phuongnamzz/jetson-agx-thor-baseboard/jetson-agx-thor-baseboard_full3D/3D_Model/D_SOD-323.step

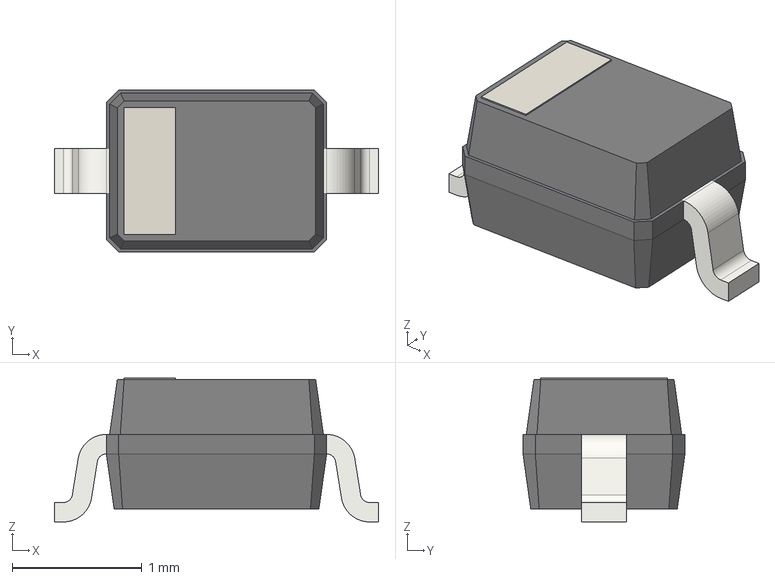
[picture p1: CAD file, 2026-10-12]
jetson-agx-thor-baseboard_full3D/3D_Model/D_SOD-323.step
2.50 x 1.25 x 1.11 mm
