phuongnamzz/jetson-agx-thor-baseboard/jetson-agx-thor-baseboard_full3D/3D_Model/Oscillator_SMD_Epson_SG3225EEN_3.2x2.5x1.2mm.stp

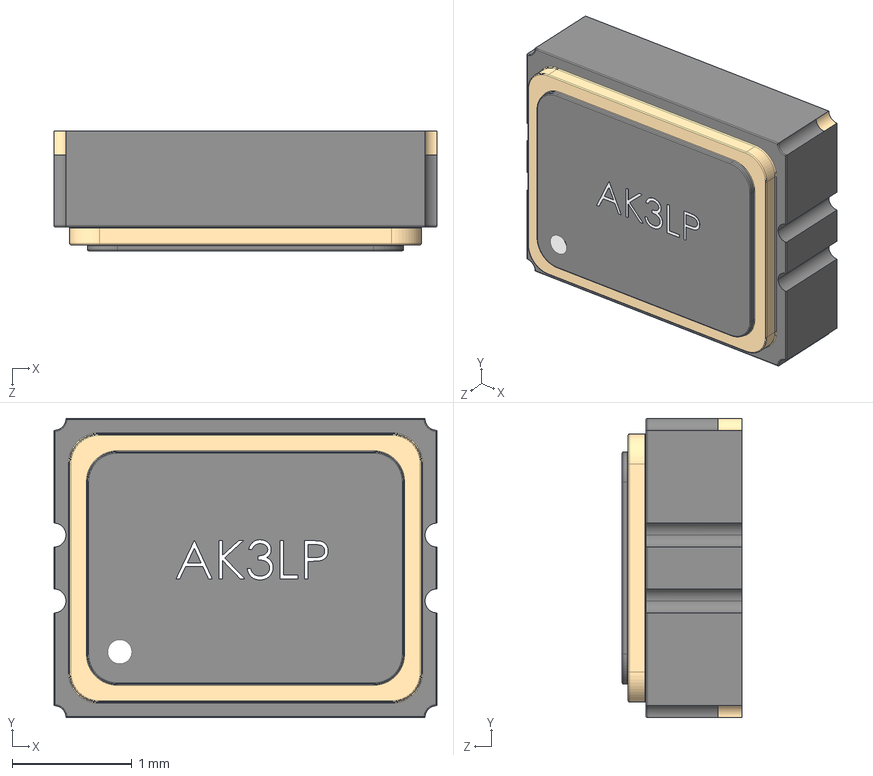
[picture p2: CAD file, 2026-10-12]
jetson-agx-thor-baseboard_full3D/3D_Model/Oscillator_SMD_Epson_SG3225EEN_3.2x2.5x1.2mm.stp
3.20 x 2.50 x 1.00 mm
