phuongnamzz/jetson-agx-thor-baseboard/jetson-agx-thor-baseboard_full3D/3D_Model/SOIC-8_L5.0-W4.0-P1.27-LS6.0-BL.step

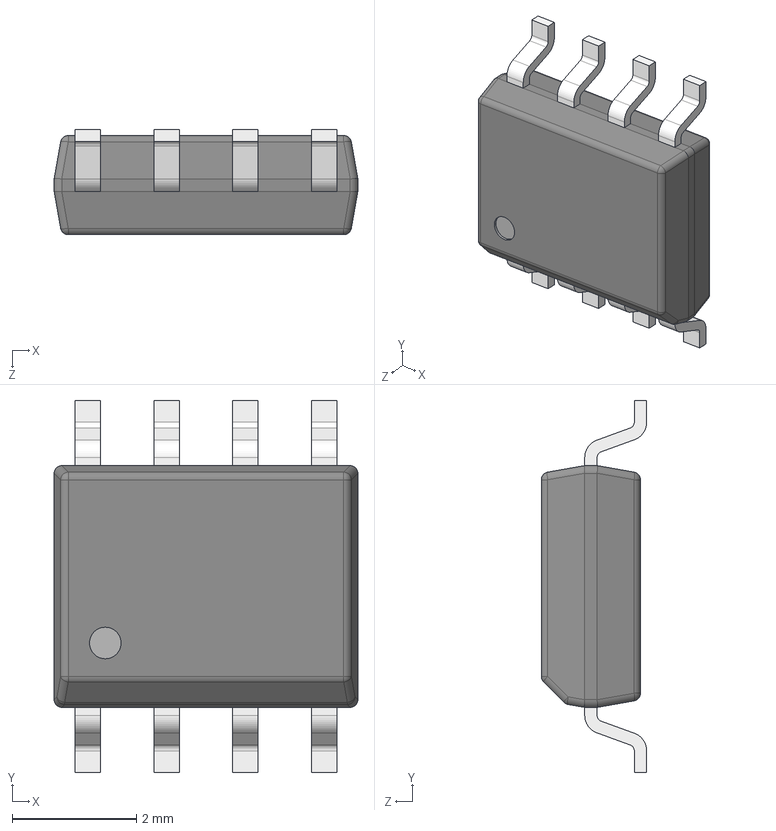
[picture p3: CAD file, 2026-10-12]
jetson-agx-thor-baseboard_full3D/3D_Model/SOIC-8_L5.0-W4.0-P1.27-LS6.0-BL.step
4.90 x 6.00 x 1.70 mm
