phuongnamzz/jetson-agx-thor-baseboard/jetson-agx-thor-baseboard_full3D/3D_Model/Oscillator_SMD_ECS_2520MV-2.5x2mm.stp

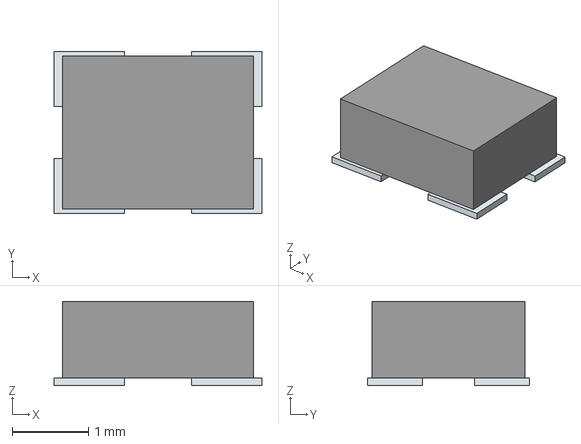
[picture p4: CAD file, 2026-10-12]
jetson-agx-thor-baseboard_full3D/3D_Model/Oscillator_SMD_ECS_2520MV-2.5x2mm.stp
2.72 x 2.12 x 1.10 mm
Pins
