phuongnamzz/jetson-agx-thor-baseboard/jetson-agx-thor-baseboard_full3D/3D_Model/CONN-SMD_MX1.25-LS-4P.step

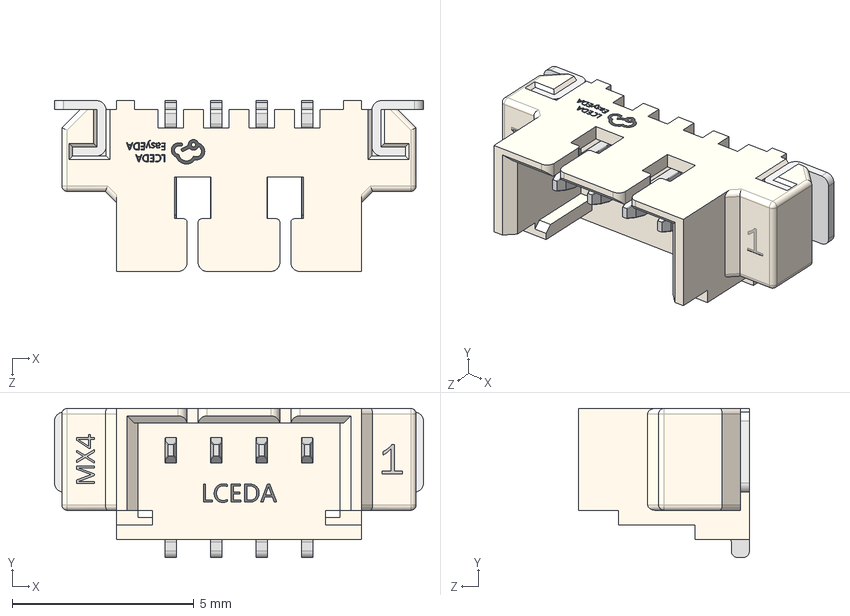
[picture p5: CAD file, 2026-10-12]
jetson-agx-thor-baseboard_full3D/3D_Model/CONN-SMD_MX1.25-LS-4P.step
10.2 x 4.10 x 4.70 mm
