phuongnamzz/jetson-agx-thor-baseboard/jetson-agx-thor-baseboard_full3D/3D_Model/XAL5030-332MEB.stp

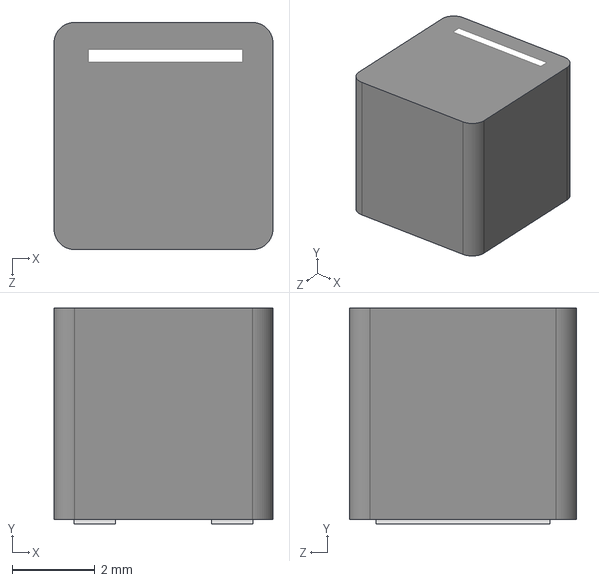
[picture p6: CAD file, 2026-10-12]
jetson-agx-thor-baseboard_full3D/3D_Model/XAL5030-332MEB.stp
5.28 x 5.20 x 5.48 mm
