phuongnamzz/jetson-agx-thor-baseboard/jetson-agx-thor-baseboard_full3D/3D_Model/SRP6050CA-1R0M.stp

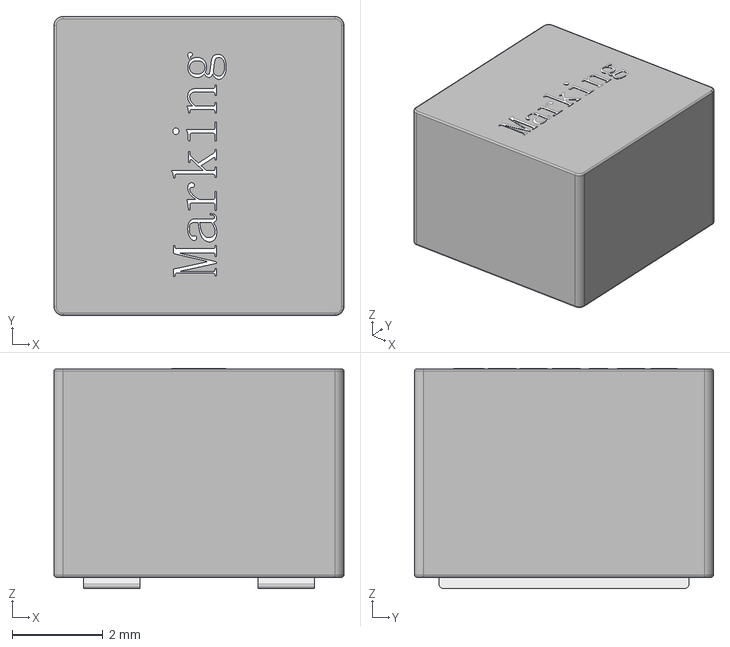
[picture p8: CAD file, 2026-10-12]
jetson-agx-thor-baseboard_full3D/3D_Model/SRP6050CA-1R0M.stp
6.40 x 6.60 x 4.86 mm
