phuongnamzz/jetson-agx-thor-baseboard/jetson-agx-thor-baseboard_full3D/3D_Model/Bus_M.2_Socket_Key_M_TE_1-2199230-6.step

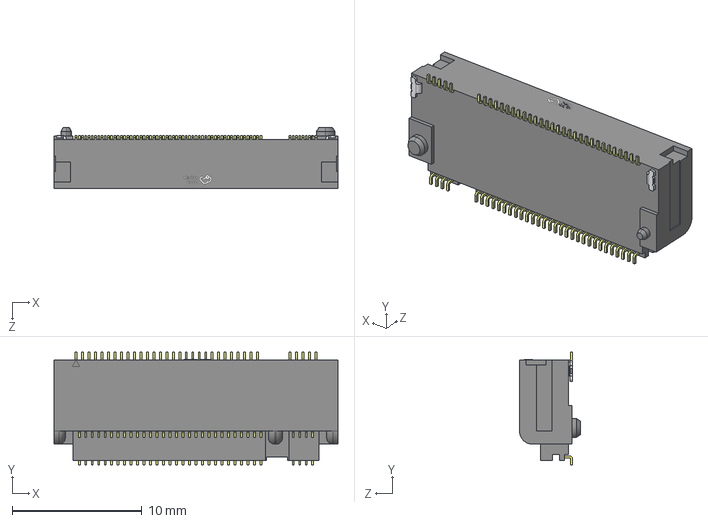
[picture p9: CAD file, 2026-10-12]
jetson-agx-thor-baseboard_full3D/3D_Model/Bus_M.2_Socket_Key_M_TE_1-2199230-6.step
21.9 x 8.70 x 4.70 mm
