phuongnamzz/jetson-agx-thor-baseboard/jetson-agx-thor-baseboard_full3D/3D_Model/SOT-23-8.step

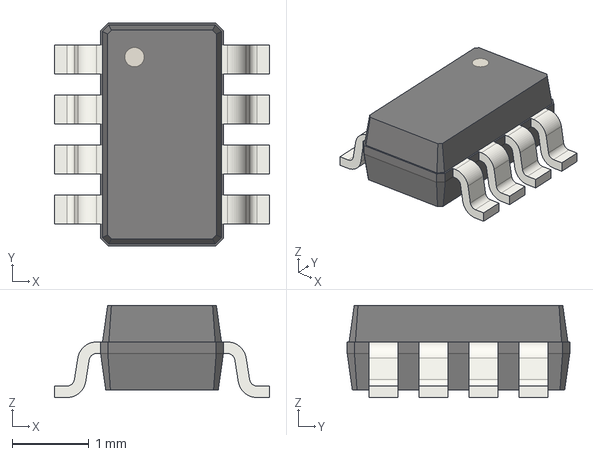
[picture p10: CAD file, 2026-10-12]
jetson-agx-thor-baseboard_full3D/3D_Model/SOT-23-8.step
2.80 x 2.90 x 1.20 mm
