phuongnamzz/jetson-agx-thor-baseboard/jetson-agx-thor-baseboard_full3D/3D_Model/SOT-363_SC-70-6.step

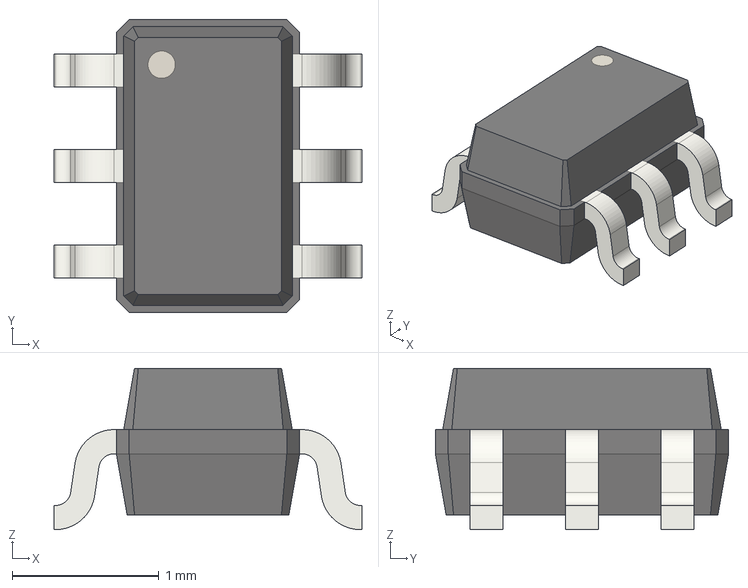
[picture p11: CAD file, 2026-10-12]
jetson-agx-thor-baseboard_full3D/3D_Model/SOT-363_SC-70-6.step
2.10 x 2.00 x 1.10 mm
