phuongnamzz/jetson-agx-thor-baseboard/jetson-agx-thor-baseboard_full3D/3D_Model/XAL7070-332MEB.stp

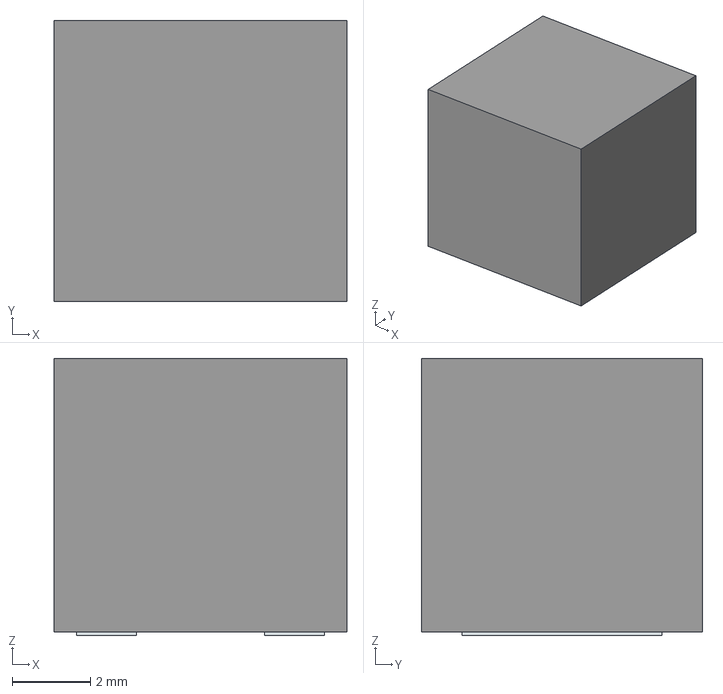
[picture p12: CAD file, 2026-10-12]
jetson-agx-thor-baseboard_full3D/3D_Model/XAL7070-332MEB.stp
7.50 x 7.20 x 7.10 mm
Pins
