phuongnamzz/jetson-agx-thor-baseboard/jetson-agx-thor-baseboard_full3D/3D_Model/R_0603_1608Metric.step

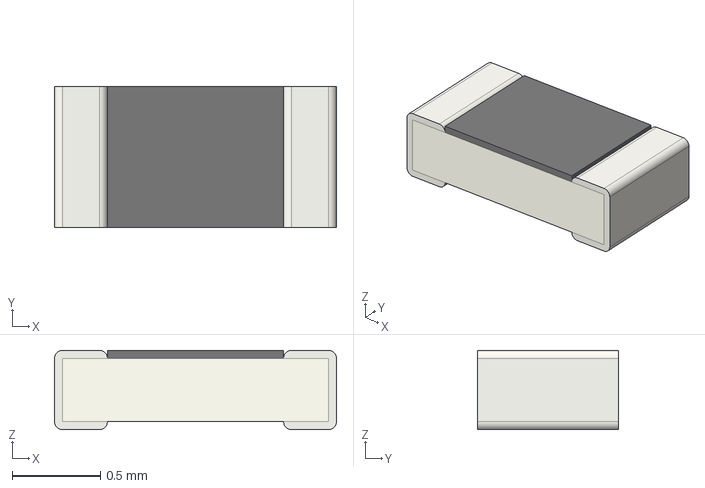
[picture p13: CAD file, 2026-10-12]
jetson-agx-thor-baseboard_full3D/3D_Model/R_0603_1608Metric.step
1.60 x 0.8 x 0.45 mm
