phuongnamzz/jetson-agx-thor-baseboard/jetson-agx-thor-baseboard_full3D/3D_Model/SOT-23-5_L2.9-W1.6-P0.95-LS2.8-BR.step

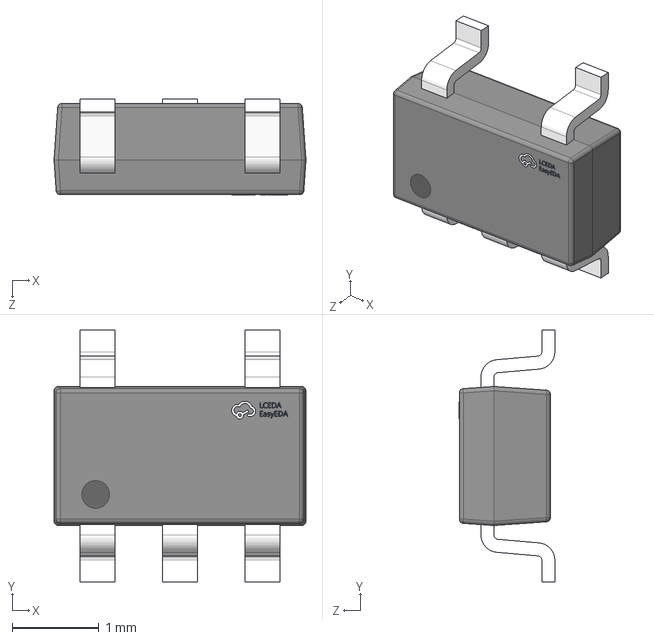
[picture p14: CAD file, 2026-10-12]
jetson-agx-thor-baseboard_full3D/3D_Model/SOT-23-5_L2.9-W1.6-P0.95-LS2.8-BR.step
2.90 x 2.90 x 1.10 mm
