phuongnamzz/jetson-agx-thor-baseboard/jetson-agx-thor-baseboard_full3D/3D_Model/SRP5030CA-R56M.stp

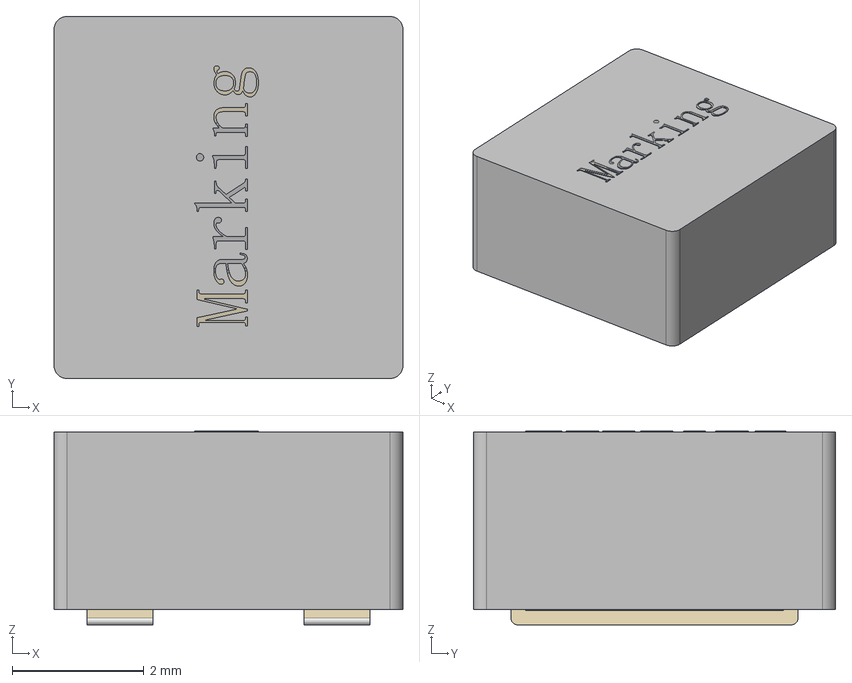
[picture p15: CAD file, 2026-10-12]
jetson-agx-thor-baseboard_full3D/3D_Model/SRP5030CA-R56M.stp
5.30 x 5.50 x 2.94 mm
