phuongnamzz/jetson-agx-thor-baseboard/jetson-agx-thor-baseboard_full3D/3D_Model/SOD-523_L1.2-W0.8-H0.7-LS1.6.step

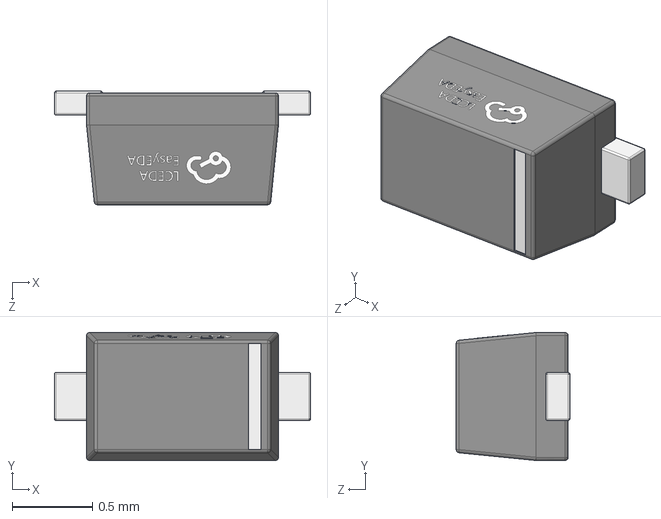
[picture p16: CAD file, 2026-10-12]
jetson-agx-thor-baseboard_full3D/3D_Model/SOD-523_L1.2-W0.8-H0.7-LS1.6.step
1.60 x 0.8 x 0.71 mm
