phuongnamzz/jetson-agx-thor-baseboard/jetson-agx-thor-baseboard_full3D/3D_Model/DFN1610-2_L1.6-W1.0-P1.05-RD.step

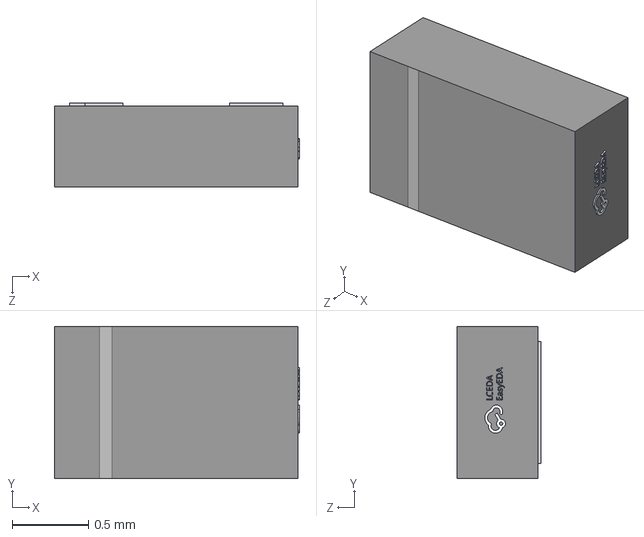
[picture p18: CAD file, 2026-10-12]
jetson-agx-thor-baseboard_full3D/3D_Model/DFN1610-2_L1.6-W1.0-P1.05-RD.step
1.61 x 1.00 x 0.55 mm
