phuongnamzz/jetson-agx-thor-baseboard/jetson-agx-thor-baseboard_full3D/3D_Model/USB-C_Receptacle_Kycon_KUSBX-SL2-CS1N24-B-TR.step

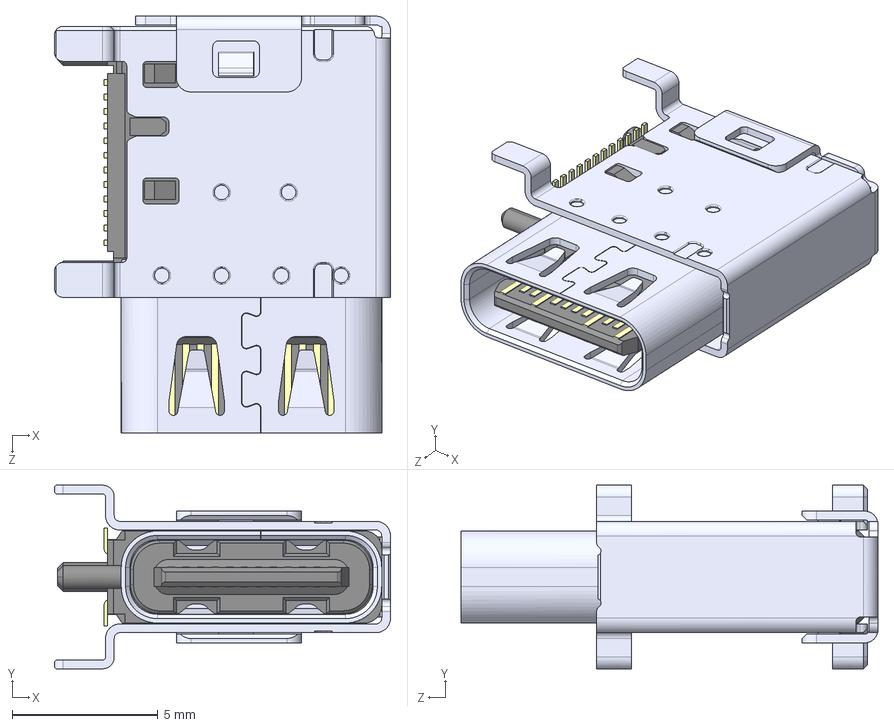
[picture p19: CAD file, 2026-10-12]
jetson-agx-thor-baseboard_full3D/3D_Model/USB-C_Receptacle_Kycon_KUSBX-SL2-CS1N24-B-TR.step
11.5 x 6.30 x 14.3 mm
