phuongnamzz/jetson-agx-thor-baseboard/jetson-agx-thor-baseboard_full3D/3D_Model/NTS0102GT.stp

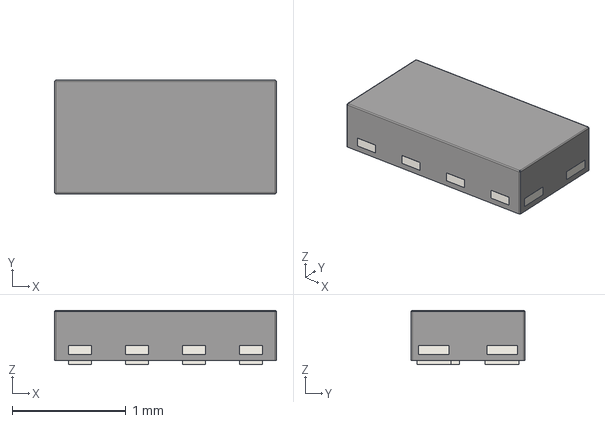
[picture p20: CAD file, 2026-10-12]
jetson-agx-thor-baseboard_full3D/3D_Model/NTS0102GT.stp
1.95 x 1.00 x 0.475 mm
