phuongnamzz/jetson-agx-thor-baseboard/jetson-agx-thor-baseboard_full3D/3D_Model/CONN-SMD_SR1.00-WS-4P.step

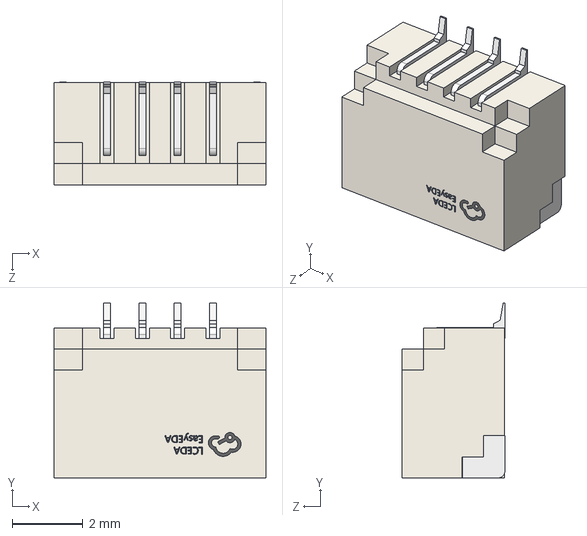
[picture p21: CAD file, 2026-10-12]
jetson-agx-thor-baseboard_full3D/3D_Model/CONN-SMD_SR1.00-WS-4P.step
6.00 x 4.95 x 2.91 mm
