phuongnamzz/jetson-agx-thor-baseboard/jetson-agx-thor-baseboard_full3D/3D_Model/WQFN-40_L6.0-W4.0-P0.40-TL-EP.step

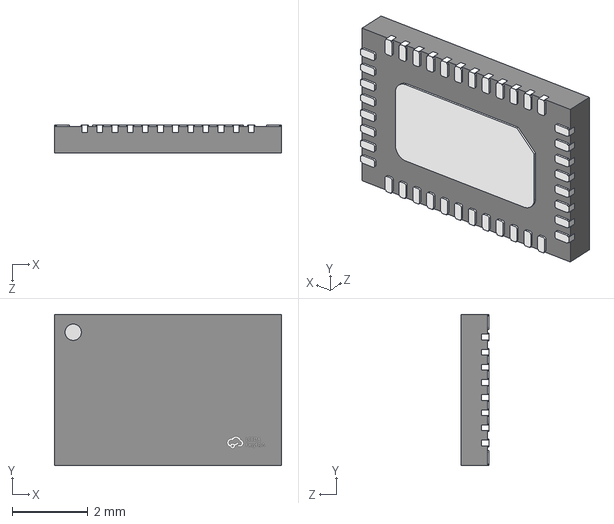
[picture p22: CAD file, 2026-10-12]
jetson-agx-thor-baseboard_full3D/3D_Model/WQFN-40_L6.0-W4.0-P0.40-TL-EP.step
6.00 x 4.00 x 0.751 mm
