phuongnamzz/jetson-agx-thor-baseboard/jetson-agx-thor-baseboard_full3D/3D_Model/WQFN-30_L4.5-W2.5-P0.4-BL-EP.step

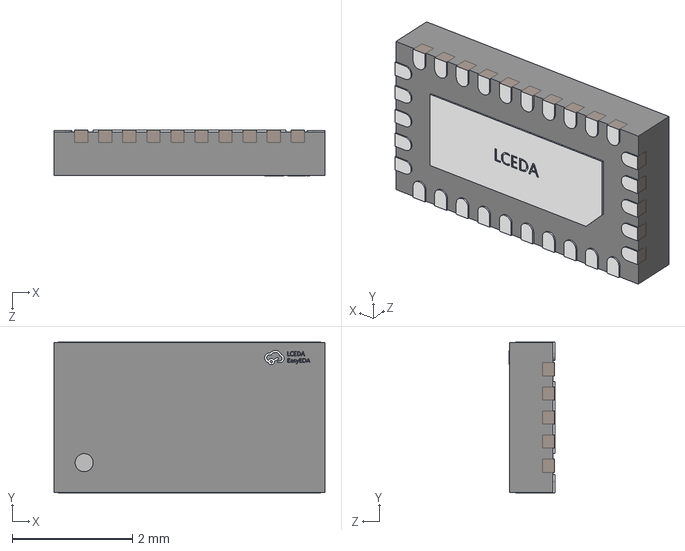
[picture p23: CAD file, 2026-10-12]
jetson-agx-thor-baseboard_full3D/3D_Model/WQFN-30_L4.5-W2.5-P0.4-BL-EP.step
4.50 x 2.50 x 0.756 mm
