phuongnamzz/jetson-agx-thor-baseboard/jetson-agx-thor-baseboard_full3D/3D_Model/Vishay_PowerPAK_1212-8_Single.stp

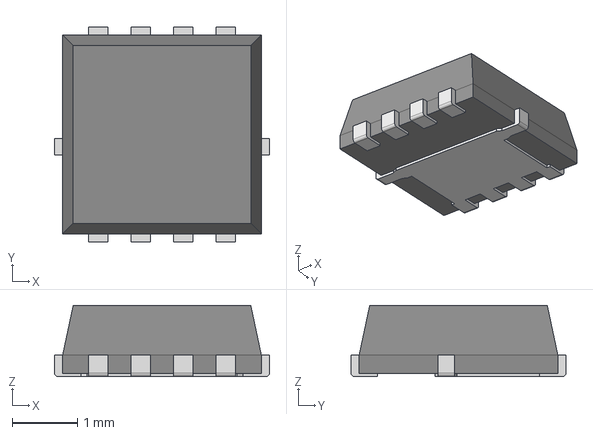
[picture p24: CAD file, 2026-10-12]
jetson-agx-thor-baseboard_full3D/3D_Model/Vishay_PowerPAK_1212-8_Single.stp
3.30 x 3.30 x 1.09 mm
