phuongnamzz/jetson-agx-thor-baseboard/jetson-agx-thor-baseboard_full3D/3D_Model/R_1206_3216Metric.step

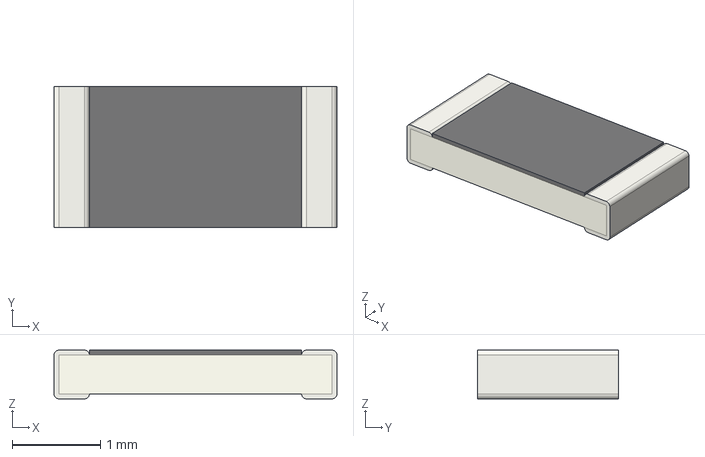
[picture p25: CAD file, 2026-10-12]
jetson-agx-thor-baseboard_full3D/3D_Model/R_1206_3216Metric.step
3.20 x 1.60 x 0.55 mm
