phuongnamzz/jetson-agx-thor-baseboard/jetson-agx-thor-baseboard_full3D/3D_Model/SOT-523.step

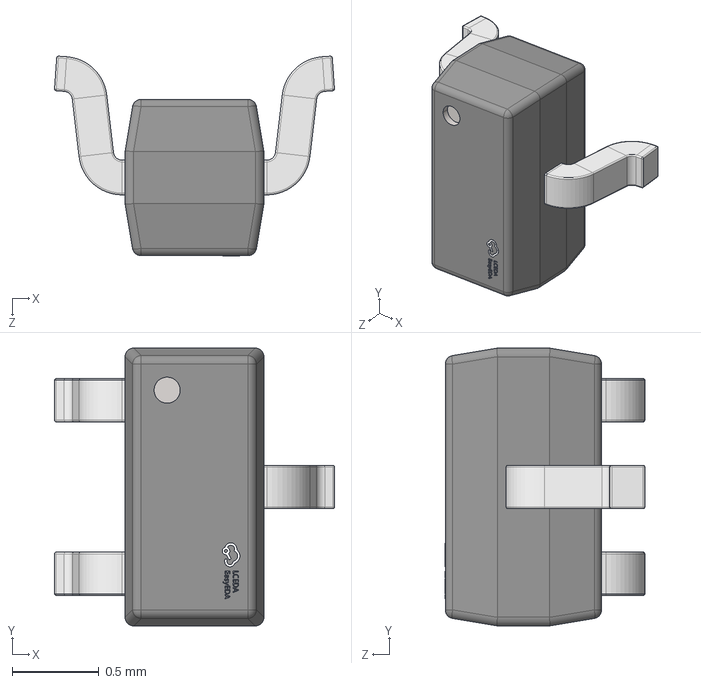
[picture p26: CAD file, 2026-10-12]
jetson-agx-thor-baseboard_full3D/3D_Model/SOT-523.step
1.61 x 1.60 x 1.15 mm
