phuongnamzz/jetson-agx-thor-baseboard/jetson-agx-thor-baseboard_full3D/3D_Model/USON-8_L3.0-W2.0-P0.50-BL-EP_GD25QXX.step

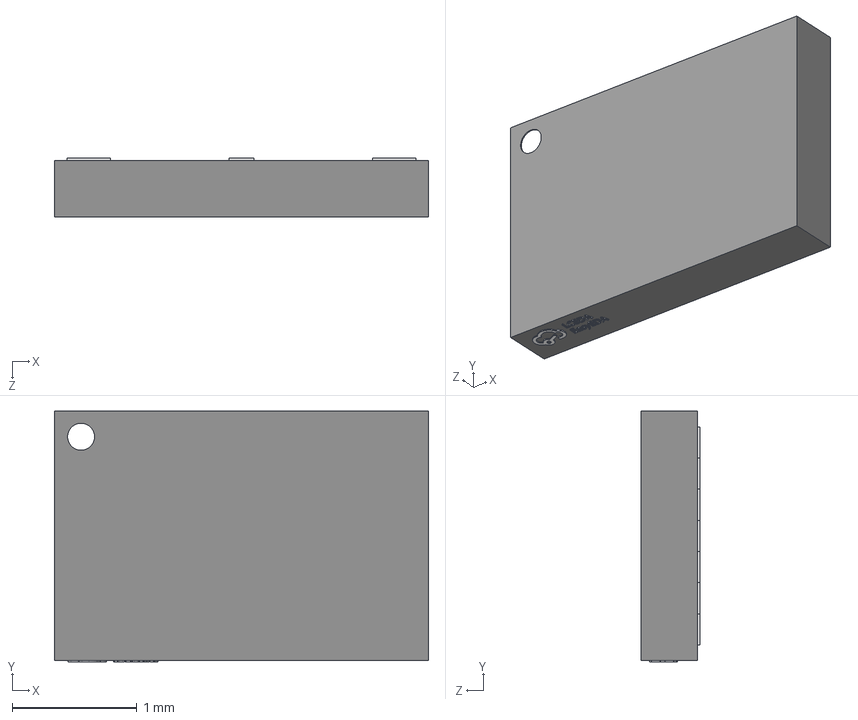
[picture p27: CAD file, 2026-10-12]
jetson-agx-thor-baseboard_full3D/3D_Model/USON-8_L3.0-W2.0-P0.50-BL-EP_GD25QXX.step
3.00 x 2.01 x 0.47 mm
