phuongnamzz/jetson-agx-thor-baseboard/jetson-agx-thor-baseboard_full3D/3D_Model/MPL-AL5050-xxx.STEP

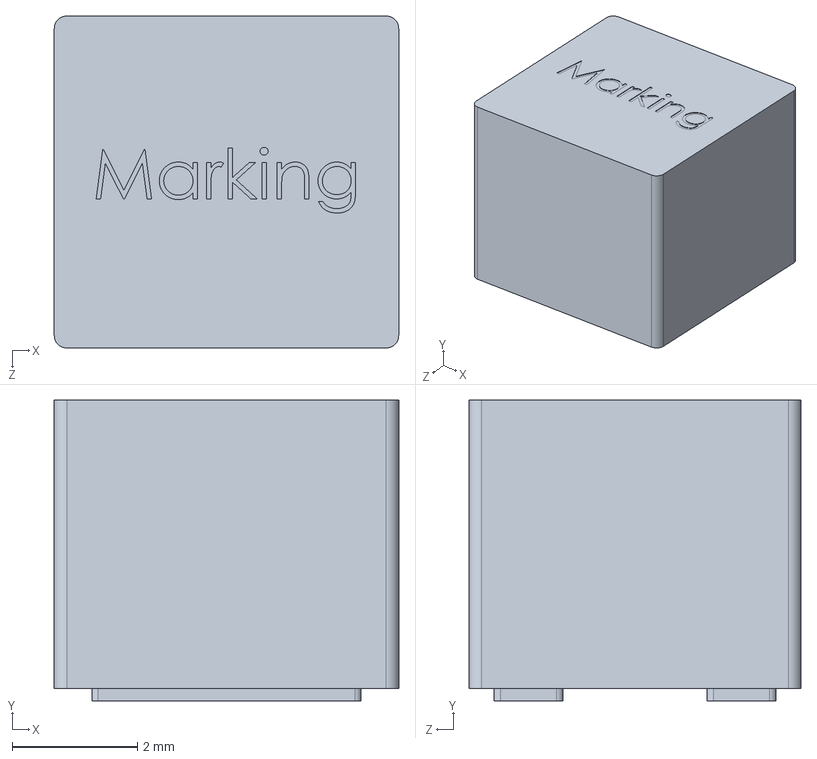
[picture p28: CAD file, 2026-10-12]
jetson-agx-thor-baseboard_full3D/3D_Model/MPL-AL5050-xxx.STEP
5.50 x 4.80 x 5.30 mm
