phuongnamzz/jetson-agx-thor-baseboard/jetson-agx-thor-baseboard_full3D/3D_Model/RSH0056E.stp

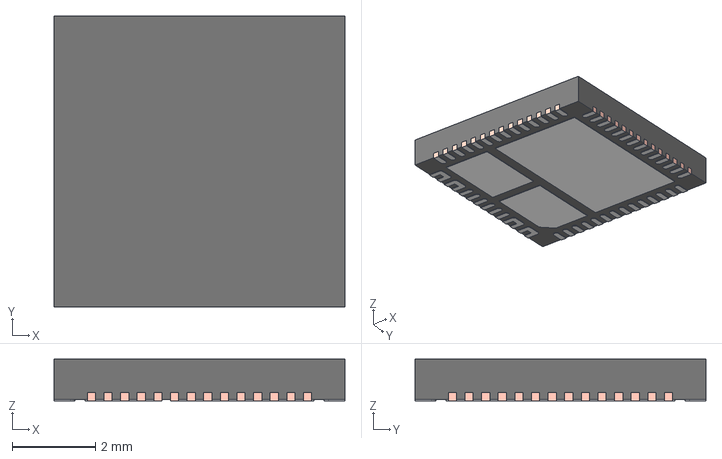
[picture p29: CAD file, 2026-10-12]
jetson-agx-thor-baseboard_full3D/3D_Model/RSH0056E.stp
7.00 x 7.00 x 1.00 mm
BODY-QFN
FRAME-RSH0056E
