phuongnamzz/jetson-agx-thor-baseboard/jetson-agx-thor-baseboard_full3D/3D_Model/SiC431AED-T1-GE3.stp

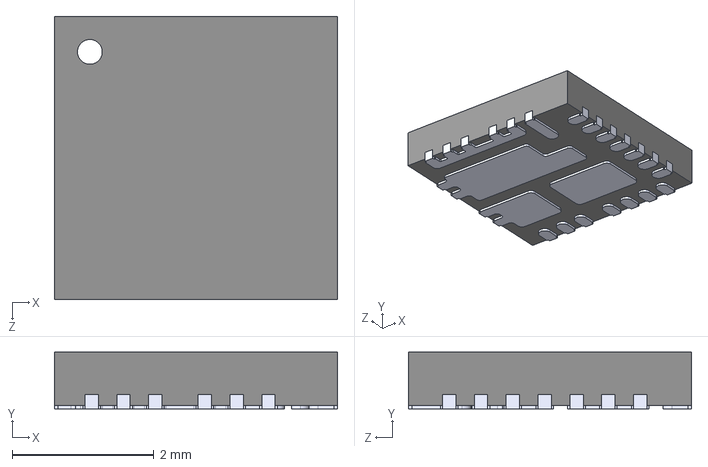
[picture p30: CAD file, 2026-10-12]
jetson-agx-thor-baseboard_full3D/3D_Model/SiC431AED-T1-GE3.stp
4.00 x 0.8 x 4.00 mm
