phuongnamzz/jetson-agx-thor-baseboard/jetson-agx-thor-baseboard_full3D/3D_Model/PCM12SMTR.step

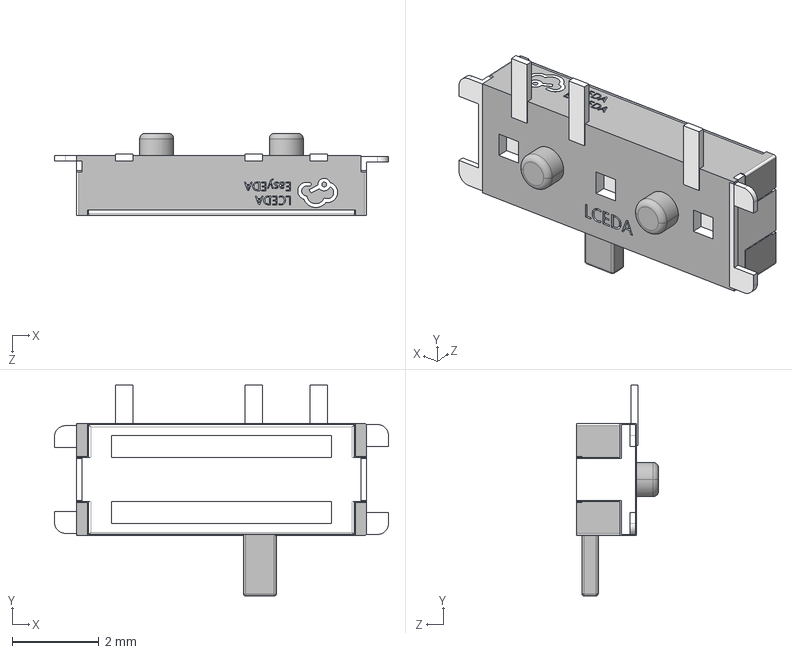
[picture p31: CAD file, 2026-10-12]
jetson-agx-thor-baseboard_full3D/3D_Model/PCM12SMTR.step
7.72 x 4.88 x 1.91 mm
