phuongnamzz/jetson-agx-thor-baseboard/jetson-agx-thor-baseboard_full3D/3D_Model/TQFN-32_L5.0-W5.0-P0.50-TL-EP3.7.step

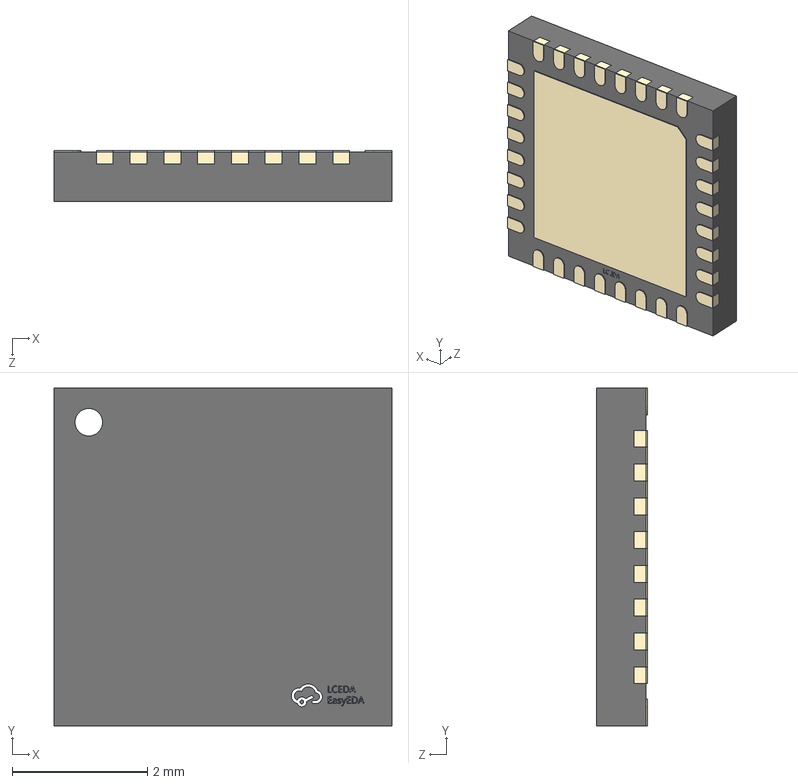
[picture p32: CAD file, 2026-10-12]
jetson-agx-thor-baseboard_full3D/3D_Model/TQFN-32_L5.0-W5.0-P0.50-TL-EP3.7.step
5.00 x 5.00 x 0.751 mm
