phuongnamzz/jetson-agx-thor-baseboard/jetson-agx-thor-baseboard_full3D/3D_Model/HVQFN-16_L3.0-W3.0-P0.50-BL-EP1.6.step

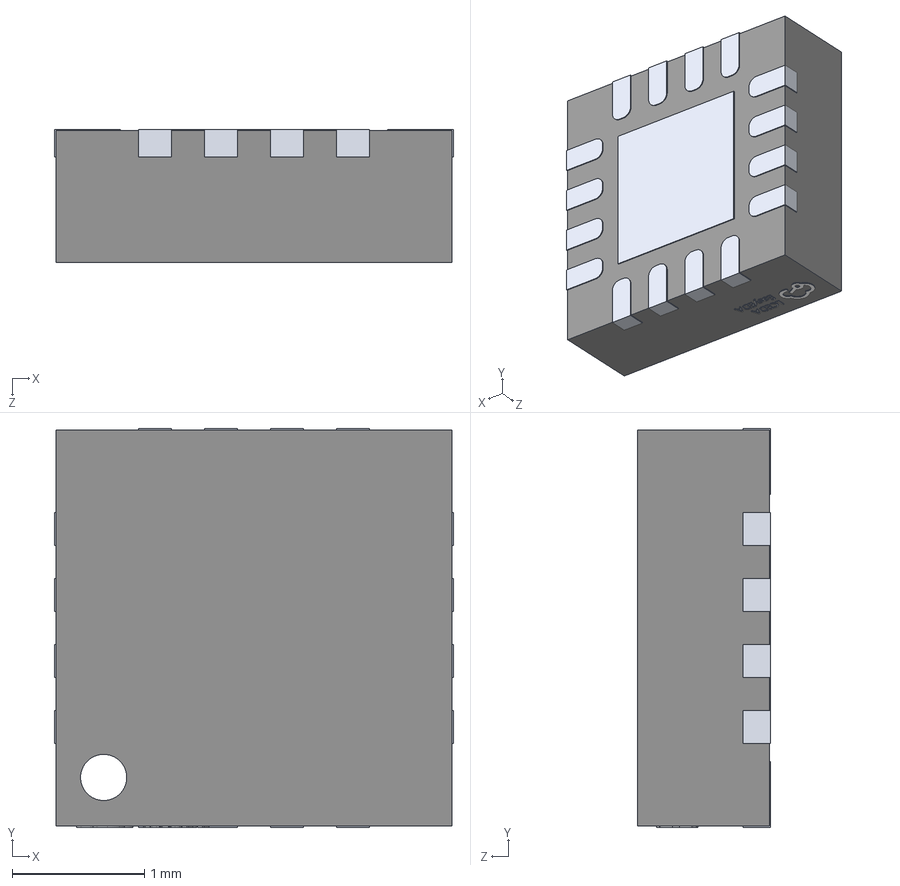
[picture p33: CAD file, 2026-10-12]
jetson-agx-thor-baseboard_full3D/3D_Model/HVQFN-16_L3.0-W3.0-P0.50-BL-EP1.6.step
3.02 x 3.02 x 1.01 mm
