phuongnamzz/jetson-agx-thor-baseboard/jetson-agx-thor-baseboard_full3D/3D_Model/R_0805_2012Metric.step

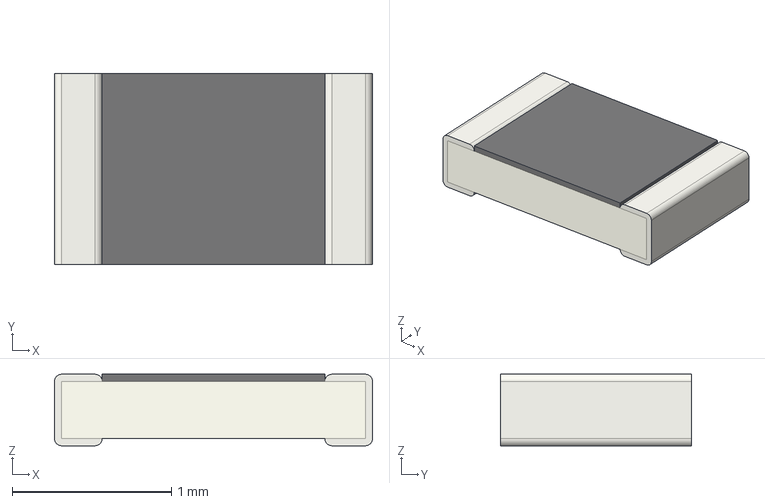
[picture p34: CAD file, 2026-10-12]
jetson-agx-thor-baseboard_full3D/3D_Model/R_0805_2012Metric.step
2.00 x 1.20 x 0.45 mm
