phuongnamzz/jetson-agx-thor-baseboard/jetson-agx-thor-baseboard_full3D/3D_Model/VQFN-24.step

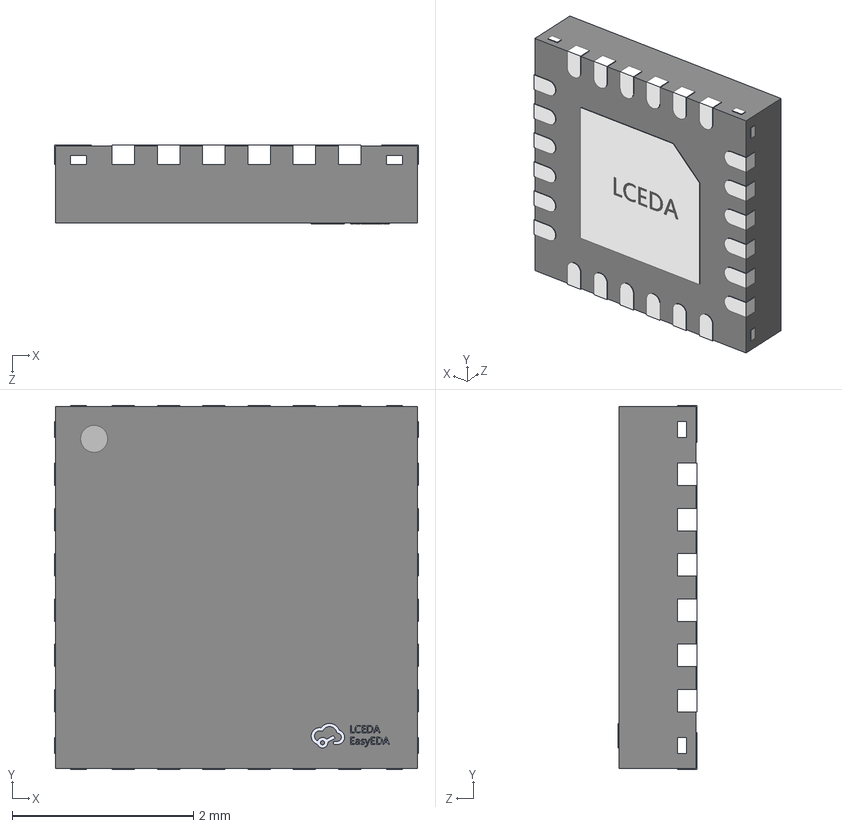
[picture p35: CAD file, 2026-10-12]
jetson-agx-thor-baseboard_full3D/3D_Model/VQFN-24.step
4.02 x 4.02 x 0.87 mm
