phuongnamzz/jetson-agx-thor-baseboard/jetson-agx-thor-baseboard_full3D/3D_Model/VQFN-100_L12.0-W12.0-P0.40-TL-EP8.0.step

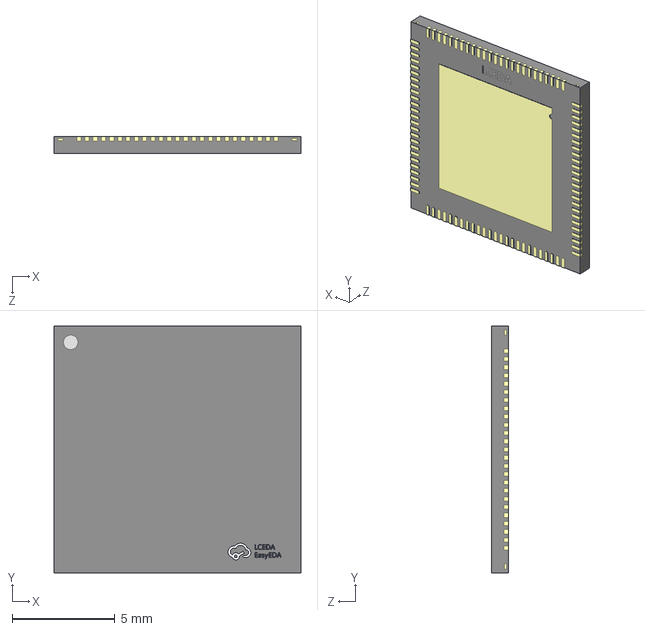
[picture p36: CAD file, 2026-10-12]
jetson-agx-thor-baseboard_full3D/3D_Model/VQFN-100_L12.0-W12.0-P0.40-TL-EP8.0.step
12.0 x 12.0 x 0.851 mm
