phuongnamzz/jetson-agx-thor-baseboard/jetson-agx-thor-baseboard_full3D/3D_Model/MS621FE-FL11E.stp

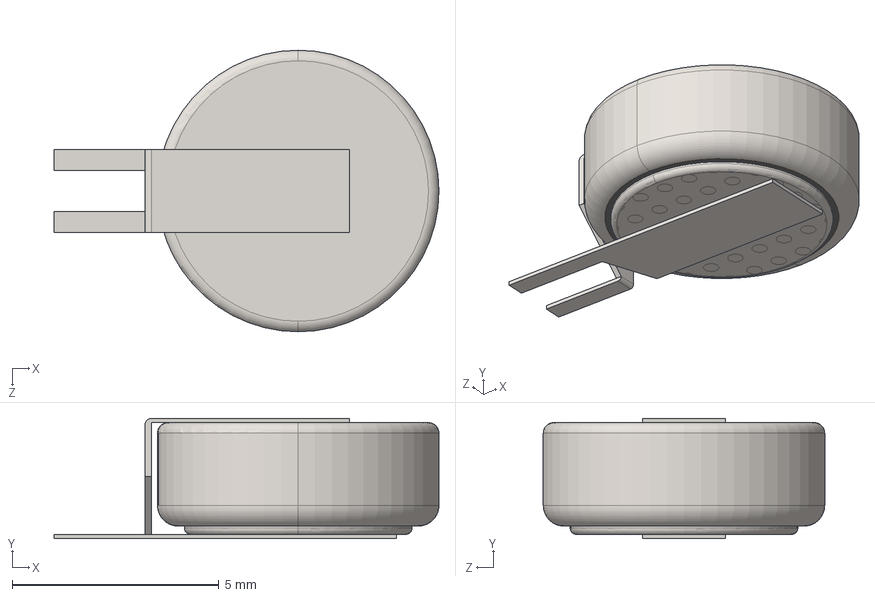
[picture p37: CAD file, 2026-10-12]
jetson-agx-thor-baseboard_full3D/3D_Model/MS621FE-FL11E.stp
9.30 x 2.90 x 6.80 mm
