phuongnamzz/jetson-agx-thor-baseboard/jetson-agx-thor-baseboard_full3D/3D_Model/MODULE_GENERIC_M.2-2280.step

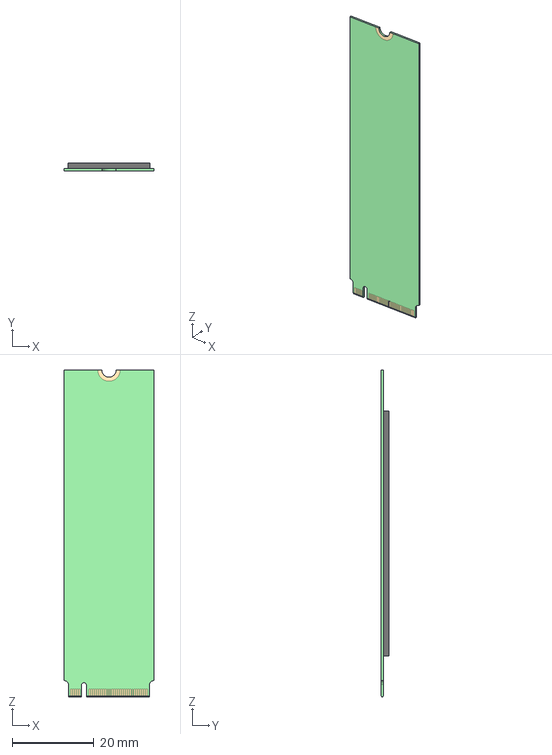
[picture p38: CAD file, 2026-10-12]
jetson-agx-thor-baseboard_full3D/3D_Model/MODULE_GENERIC_M.2-2280.step
22.0 x 1.86 x 80.0 mm
