phuongnamzz/jetson-agx-thor-baseboard/jetson-agx-thor-baseboard_full3D/3D_Model/Conn_Amphenol_SFP28_1x20_UE763GA202600T.step

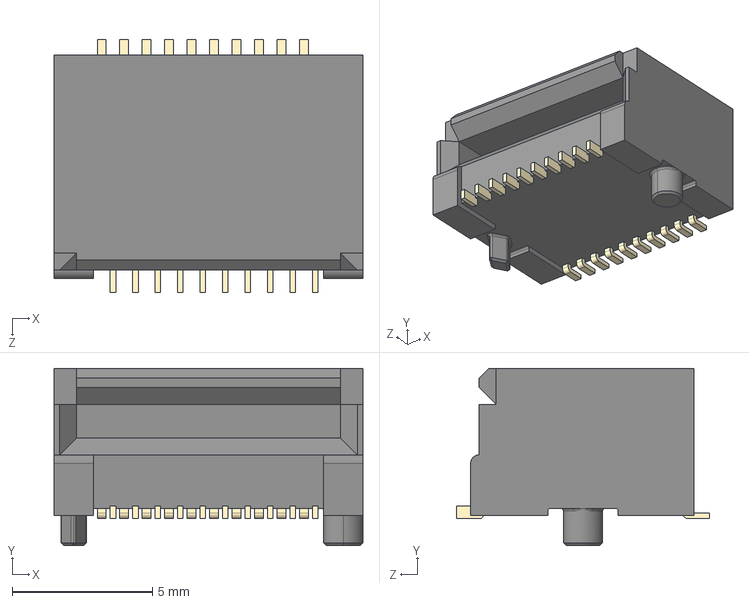
[picture p39: CAD file, 2026-10-12]
jetson-agx-thor-baseboard_full3D/3D_Model/Conn_Amphenol_SFP28_1x20_UE763GA202600T.step
11.0 x 6.31 x 9.00 mm
