phuongnamzz/jetson-agx-thor-baseboard/jetson-agx-thor-baseboard_full3D/3D_Model/D_SOD-123.step

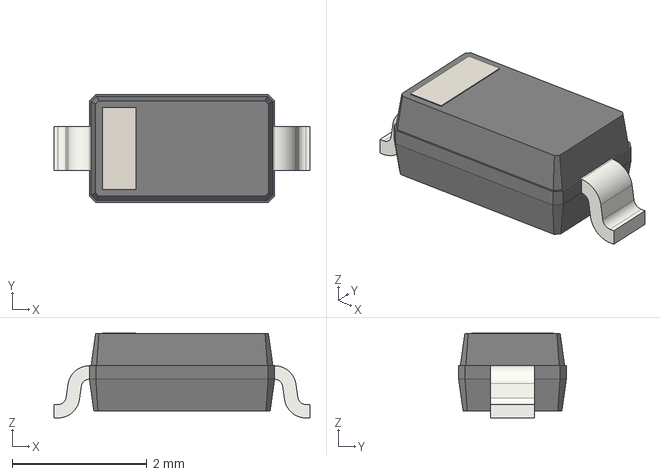
[picture p40: CAD file, 2026-10-12]
jetson-agx-thor-baseboard_full3D/3D_Model/D_SOD-123.step
3.80 x 1.60 x 1.26 mm
