phuongnamzz/jetson-agx-thor-baseboard/jetson-agx-thor-baseboard_full3D/3D_Model/UMPT-06-06.5-G-V-S-W-TR.stp

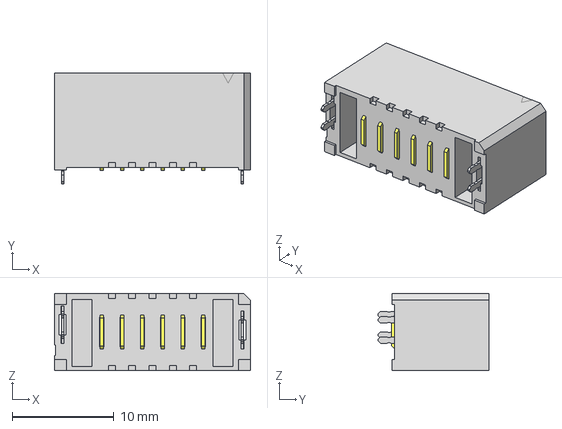
[picture p41: CAD file, 2026-10-12]
jetson-agx-thor-baseboard_full3D/3D_Model/UMPT-06-06.5-G-V-S-W-TR.stp
19.3 x 11.0 x 7.60 mm
06-06.5--W_BODY
UMPT-06-06.5-S-_PINS
