phuongnamzz/jetson-agx-thor-baseboard/jetson-agx-thor-baseboard_full3D/3D_Model/USON-10_L2.5-W1.0-H0.6-P0.50.step

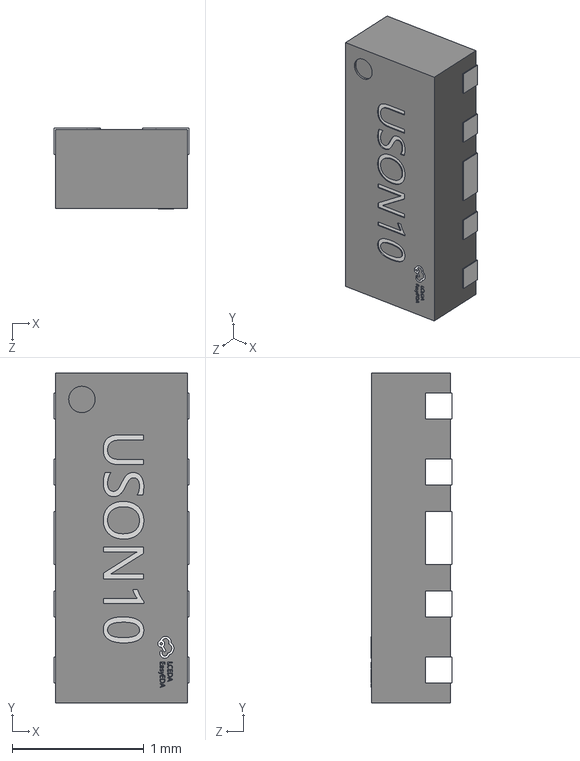
[picture p42: CAD file, 2026-10-12]
jetson-agx-thor-baseboard_full3D/3D_Model/USON-10_L2.5-W1.0-H0.6-P0.50.step
1.02 x 2.50 x 0.611 mm
