phuongnamzz/jetson-agx-thor-baseboard/jetson-agx-thor-baseboard_full3D/3D_Model/M-U77-3GC1638-X071-REVT1.STEP

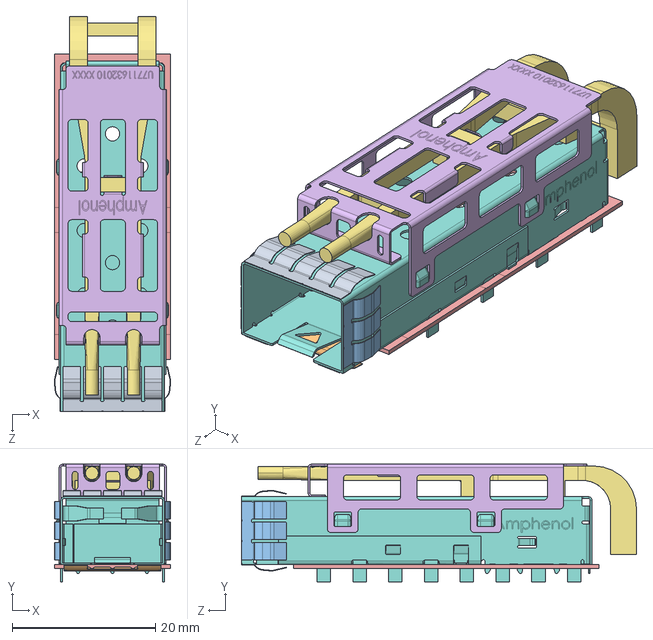
[picture p43: CAD file, 2026-10-12]
jetson-agx-thor-baseboard_full3D/3D_Model/M-U77-3GC1638-X071-REVT1.STEP
16.3 x 16.4 x 55.2 mm
