phuongnamzz/jetson-agx-thor-baseboard/jetson-agx-thor-baseboard_full3D/3D_Model/SOT-666.step

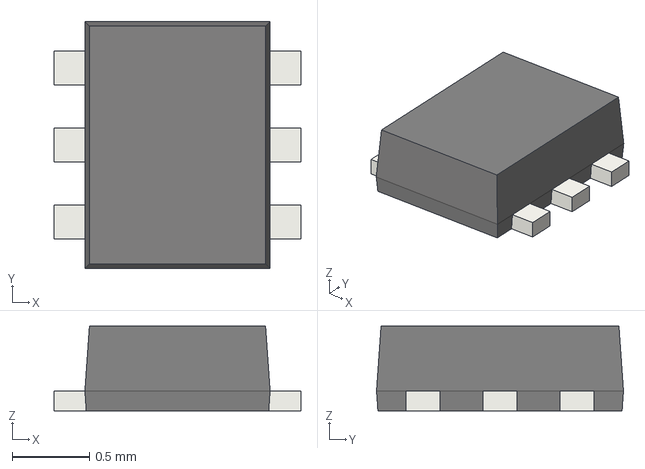
[picture p44: CAD file, 2026-10-12]
jetson-agx-thor-baseboard_full3D/3D_Model/SOT-666.step
1.60 x 1.60 x 0.55 mm
