phuongnamzz/jetson-agx-thor-baseboard/jetson-agx-thor-baseboard_full3D/3D_Model/SW-SMD_4P-L4.2-W2.8-P1.60-LS4.6-TR.step

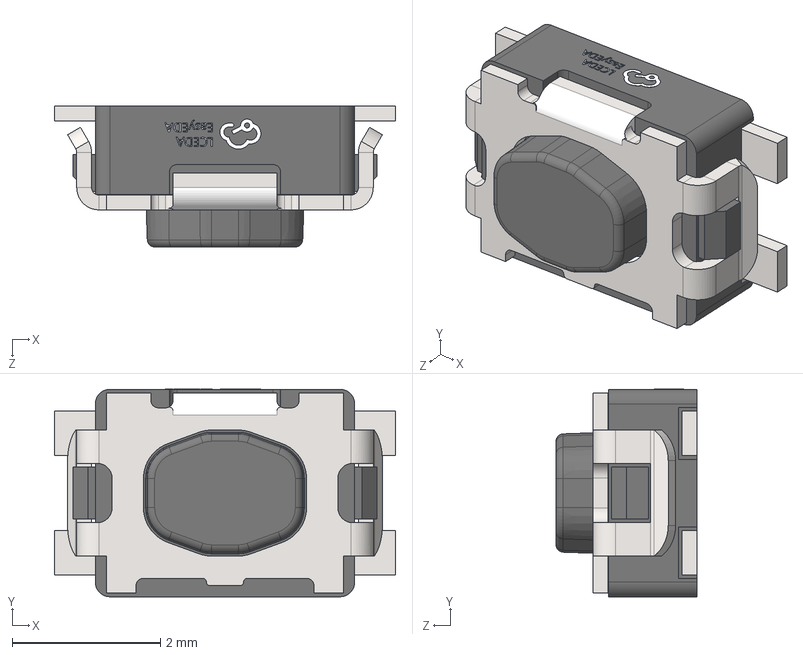
[picture p45: CAD file, 2026-10-12]
jetson-agx-thor-baseboard_full3D/3D_Model/SW-SMD_4P-L4.2-W2.8-P1.60-LS4.6-TR.step
4.60 x 2.80 x 1.90 mm
