phuongnamzz/jetson-agx-thor-baseboard/jetson-agx-thor-baseboard_full3D/3D_Model/C_0402_1005Metric.step

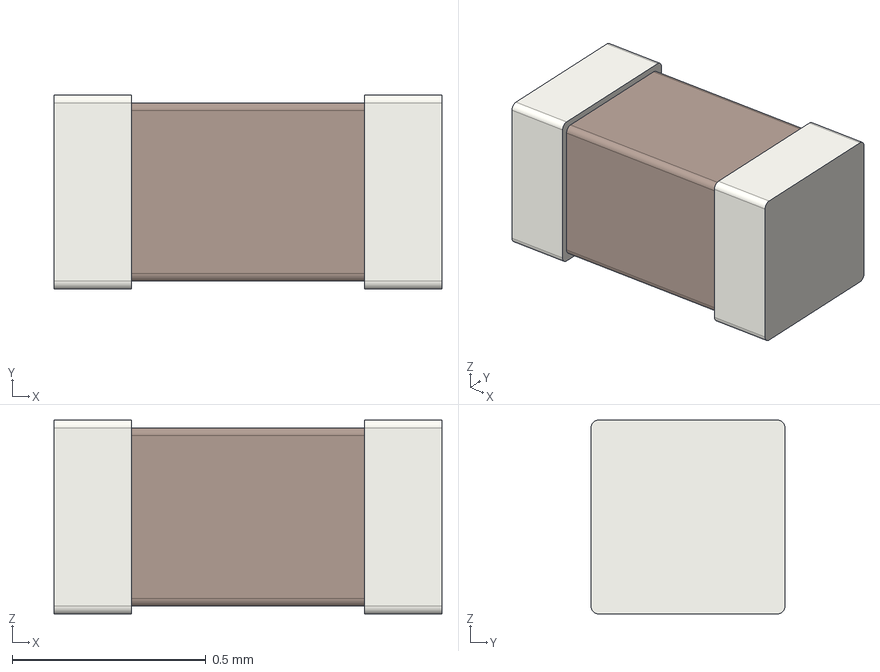
[picture p46: CAD file, 2026-10-12]
jetson-agx-thor-baseboard_full3D/3D_Model/C_0402_1005Metric.step
1.00 x 0.5 x 0.5 mm
