phuongnamzz/jetson-agx-thor-baseboard/jetson-agx-thor-baseboard_full3D/3D_Model/WE_68715014522.stp

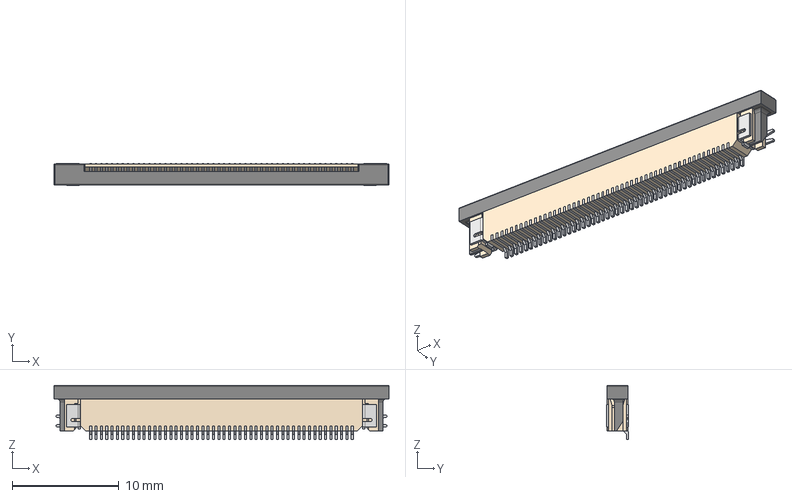
[picture p47: CAD file, 2026-10-12]
jetson-agx-thor-baseboard_full3D/3D_Model/WE_68715014522.stp
31.4 x 2.10 x 5.10 mm
6871xx14522_PIN x 50
6871xx14522_Patte
6871xx14522_Patte_2
68715014522_CAP
