phuongnamzz/jetson-agx-thor-baseboard/jetson-agx-thor-baseboard_full3D/3D_Model/SOIJ-8_L5.3-W5.3-P1.27-LS7.9-BL.step

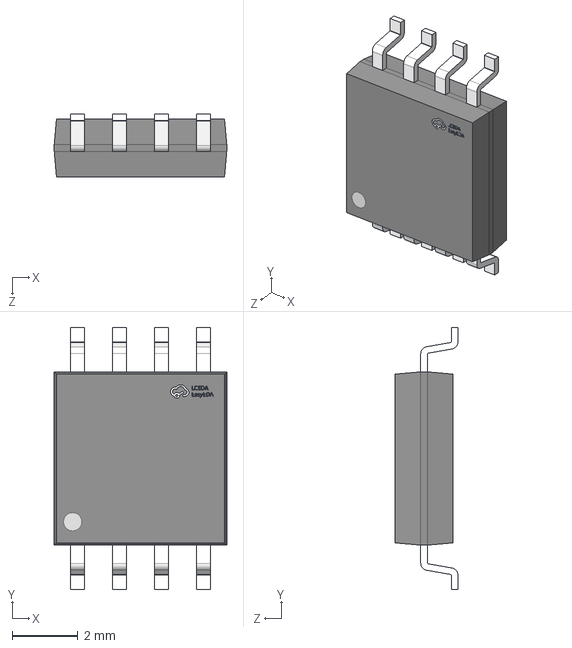
[picture p49: CAD file, 2026-10-12]
jetson-agx-thor-baseboard_full3D/3D_Model/SOIJ-8_L5.3-W5.3-P1.27-LS7.9-BL.step
5.23 x 7.94 x 1.90 mm
