phuongnamzz/jetson-agx-thor-baseboard/jetson-agx-thor-baseboard_full3D/3D_Model/UQFN-24_L4.0-W2.0-H0.6-P0.40-BL.step

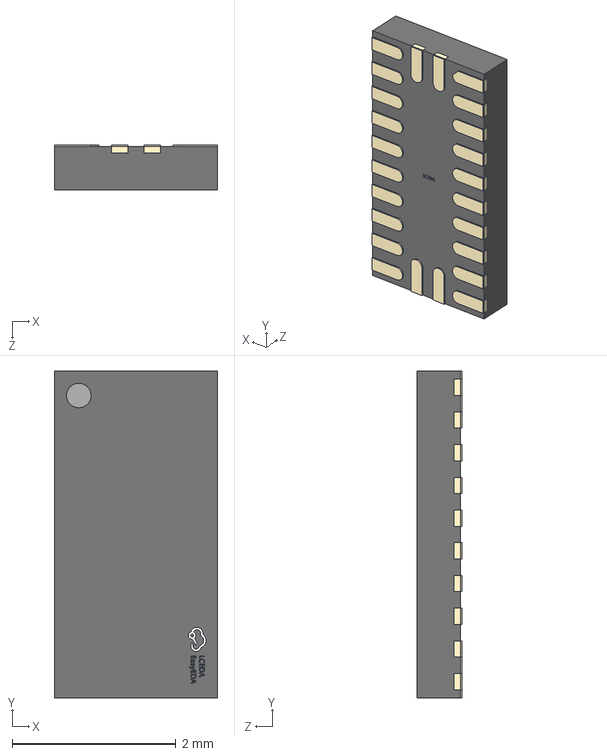
[picture p50: CAD file, 2026-10-12]
jetson-agx-thor-baseboard_full3D/3D_Model/UQFN-24_L4.0-W2.0-H0.6-P0.40-BL.step
2.00 x 4.00 x 0.551 mm
