phuongnamzz/jetson-agx-thor-baseboard/jetson-agx-thor-baseboard_full3D/3D_Model/sot23-6.step

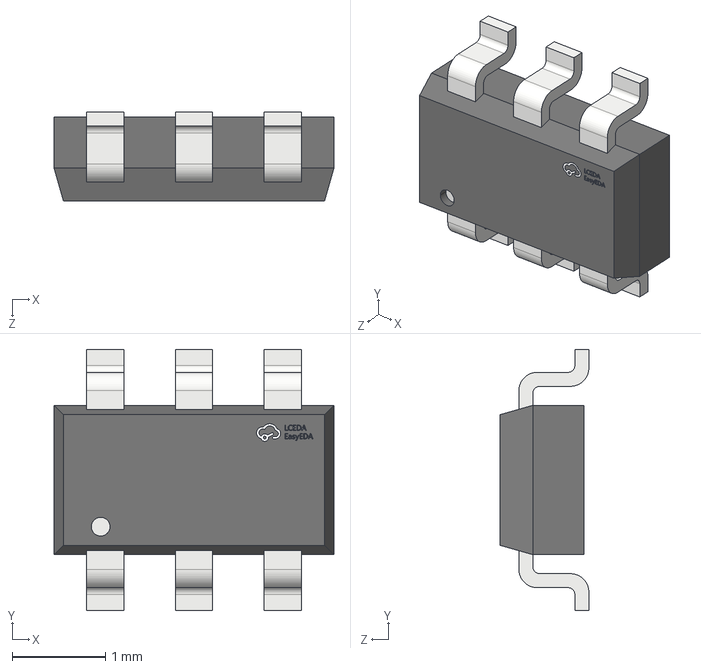
[picture p51: CAD file, 2026-10-12]
jetson-agx-thor-baseboard_full3D/3D_Model/sot23-6.step
3.00 x 2.80 x 0.951 mm
