phuongnamzz/jetson-agx-thor-baseboard/jetson-agx-thor-baseboard_full3D/3D_Model/QFN-16_L4.0-W4.0-H1.0-P0.65.step

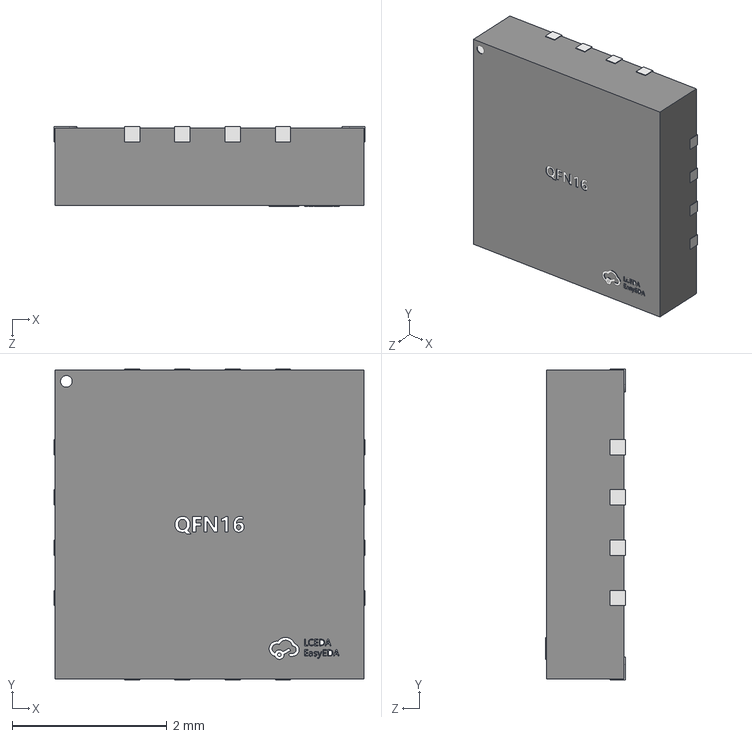
[picture p52: CAD file, 2026-10-12]
jetson-agx-thor-baseboard_full3D/3D_Model/QFN-16_L4.0-W4.0-H1.0-P0.65.step
4.02 x 4.02 x 1.03 mm
