phuongnamzz/jetson-agx-thor-baseboard/jetson-agx-thor-baseboard_full3D/3D_Model/sm3zs067u310amr1200.stp

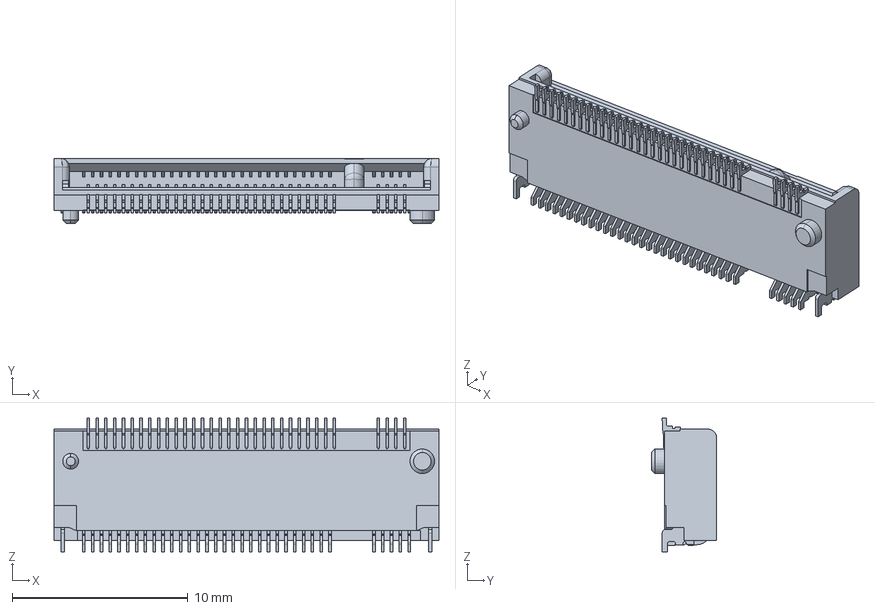
[picture p53: CAD file, 2026-10-12]
jetson-agx-thor-baseboard_full3D/3D_Model/sm3zs067u310amr1200.stp
21.9 x 3.72 x 7.60 mm
