phuongnamzz/jetson-agx-thor-baseboard/jetson-agx-thor-baseboard_full3D/3D_Model/X1SON-2_L1.0-W0.6-H0.4-P0.65.step

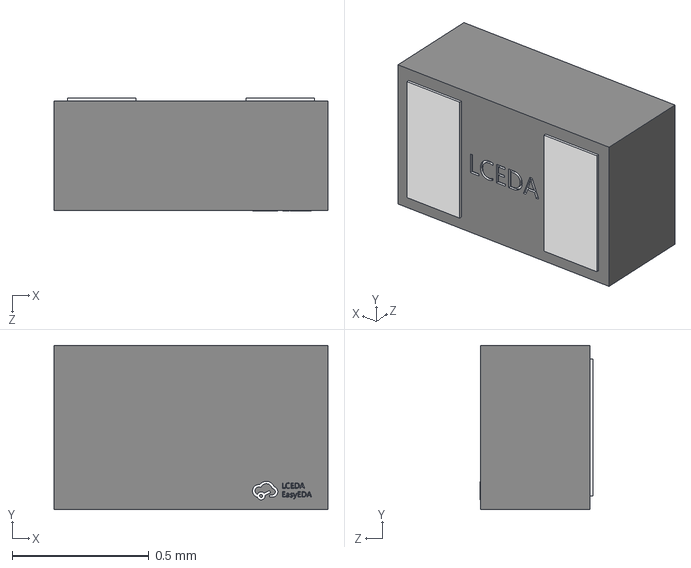
[picture p54: CAD file, 2026-10-12]
jetson-agx-thor-baseboard_full3D/3D_Model/X1SON-2_L1.0-W0.6-H0.4-P0.65.step
1.00 x 0.6 x 0.411 mm
