phuongnamzz/jetson-agx-thor-baseboard/jetson-agx-thor-baseboard_full3D/3D_Model/Oscillator_SMD_Abracon_AX3_3.2x2.5x1mm.stp

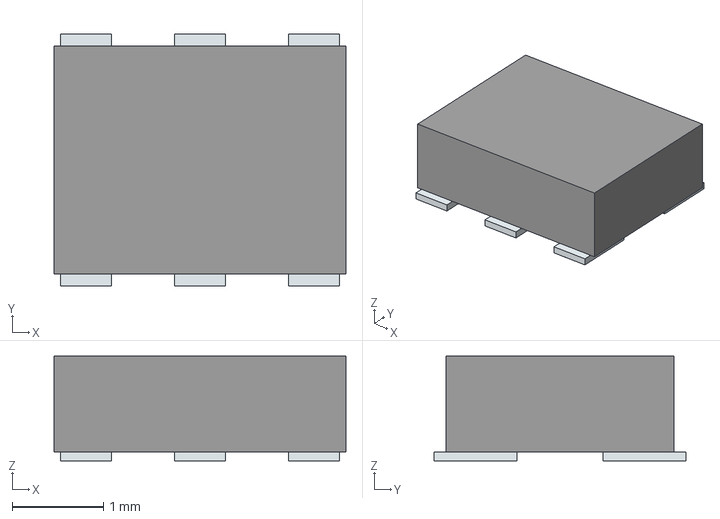
[picture p55: CAD file, 2026-10-12]
jetson-agx-thor-baseboard_full3D/3D_Model/Oscillator_SMD_Abracon_AX3_3.2x2.5x1mm.stp
3.20 x 2.76 x 1.15 mm
Pins
