phuongnamzz/jetson-agx-thor-baseboard/jetson-agx-thor-baseboard_full3D/3D_Model/DHVQFN-14-1EP_2.5x3mm.stp

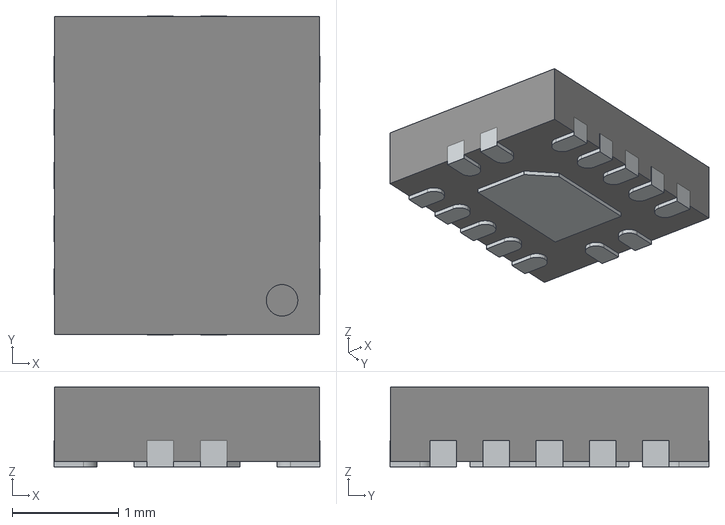
[picture p57: CAD file, 2026-10-12]
jetson-agx-thor-baseboard_full3D/3D_Model/DHVQFN-14-1EP_2.5x3mm.stp
2.51 x 3.00 x 0.75 mm
