phuongnamzz/jetson-agx-thor-baseboard/jetson-agx-thor-baseboard_full3D/3D_Model/Oscillator_SMD_ECS_2016MV_2x1.6x0.85mm.stp

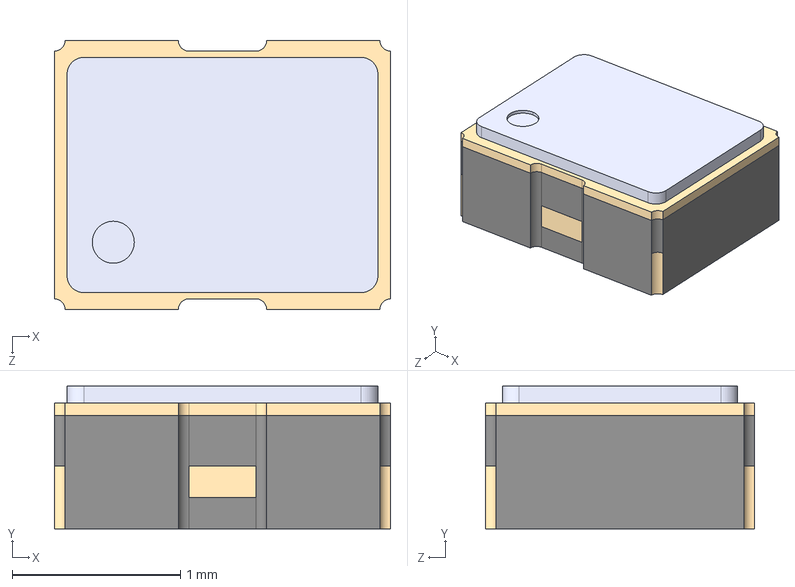
[picture p58: CAD file, 2026-10-12]
jetson-agx-thor-baseboard_full3D/3D_Model/Oscillator_SMD_ECS_2016MV_2x1.6x0.85mm.stp
2.00 x 0.85 x 1.60 mm
