phuongnamzz/jetson-agx-thor-baseboard/(list of files, cad)

Other CAD files:
jetson-agx-thor-baseboard_full3D/3D_Model/Bus_M.2_Socket_Key_E_TE_2199230-6.step
jetson-agx-thor-baseboard_full3D/3D_Model/0050362462.stp
jetson-agx-thor-baseboard_full3D/3D_Model/74438356018.stp
