phuongnamzz/jetson-agx-thor-baseboard/jetson-agx-thor-baseboard_full3D/expansion_connector.kicad_sch

## KiCad design jetson-agx-thor-baseboard_full3D/expansion_connector.kicad_sch (2026-10-11)

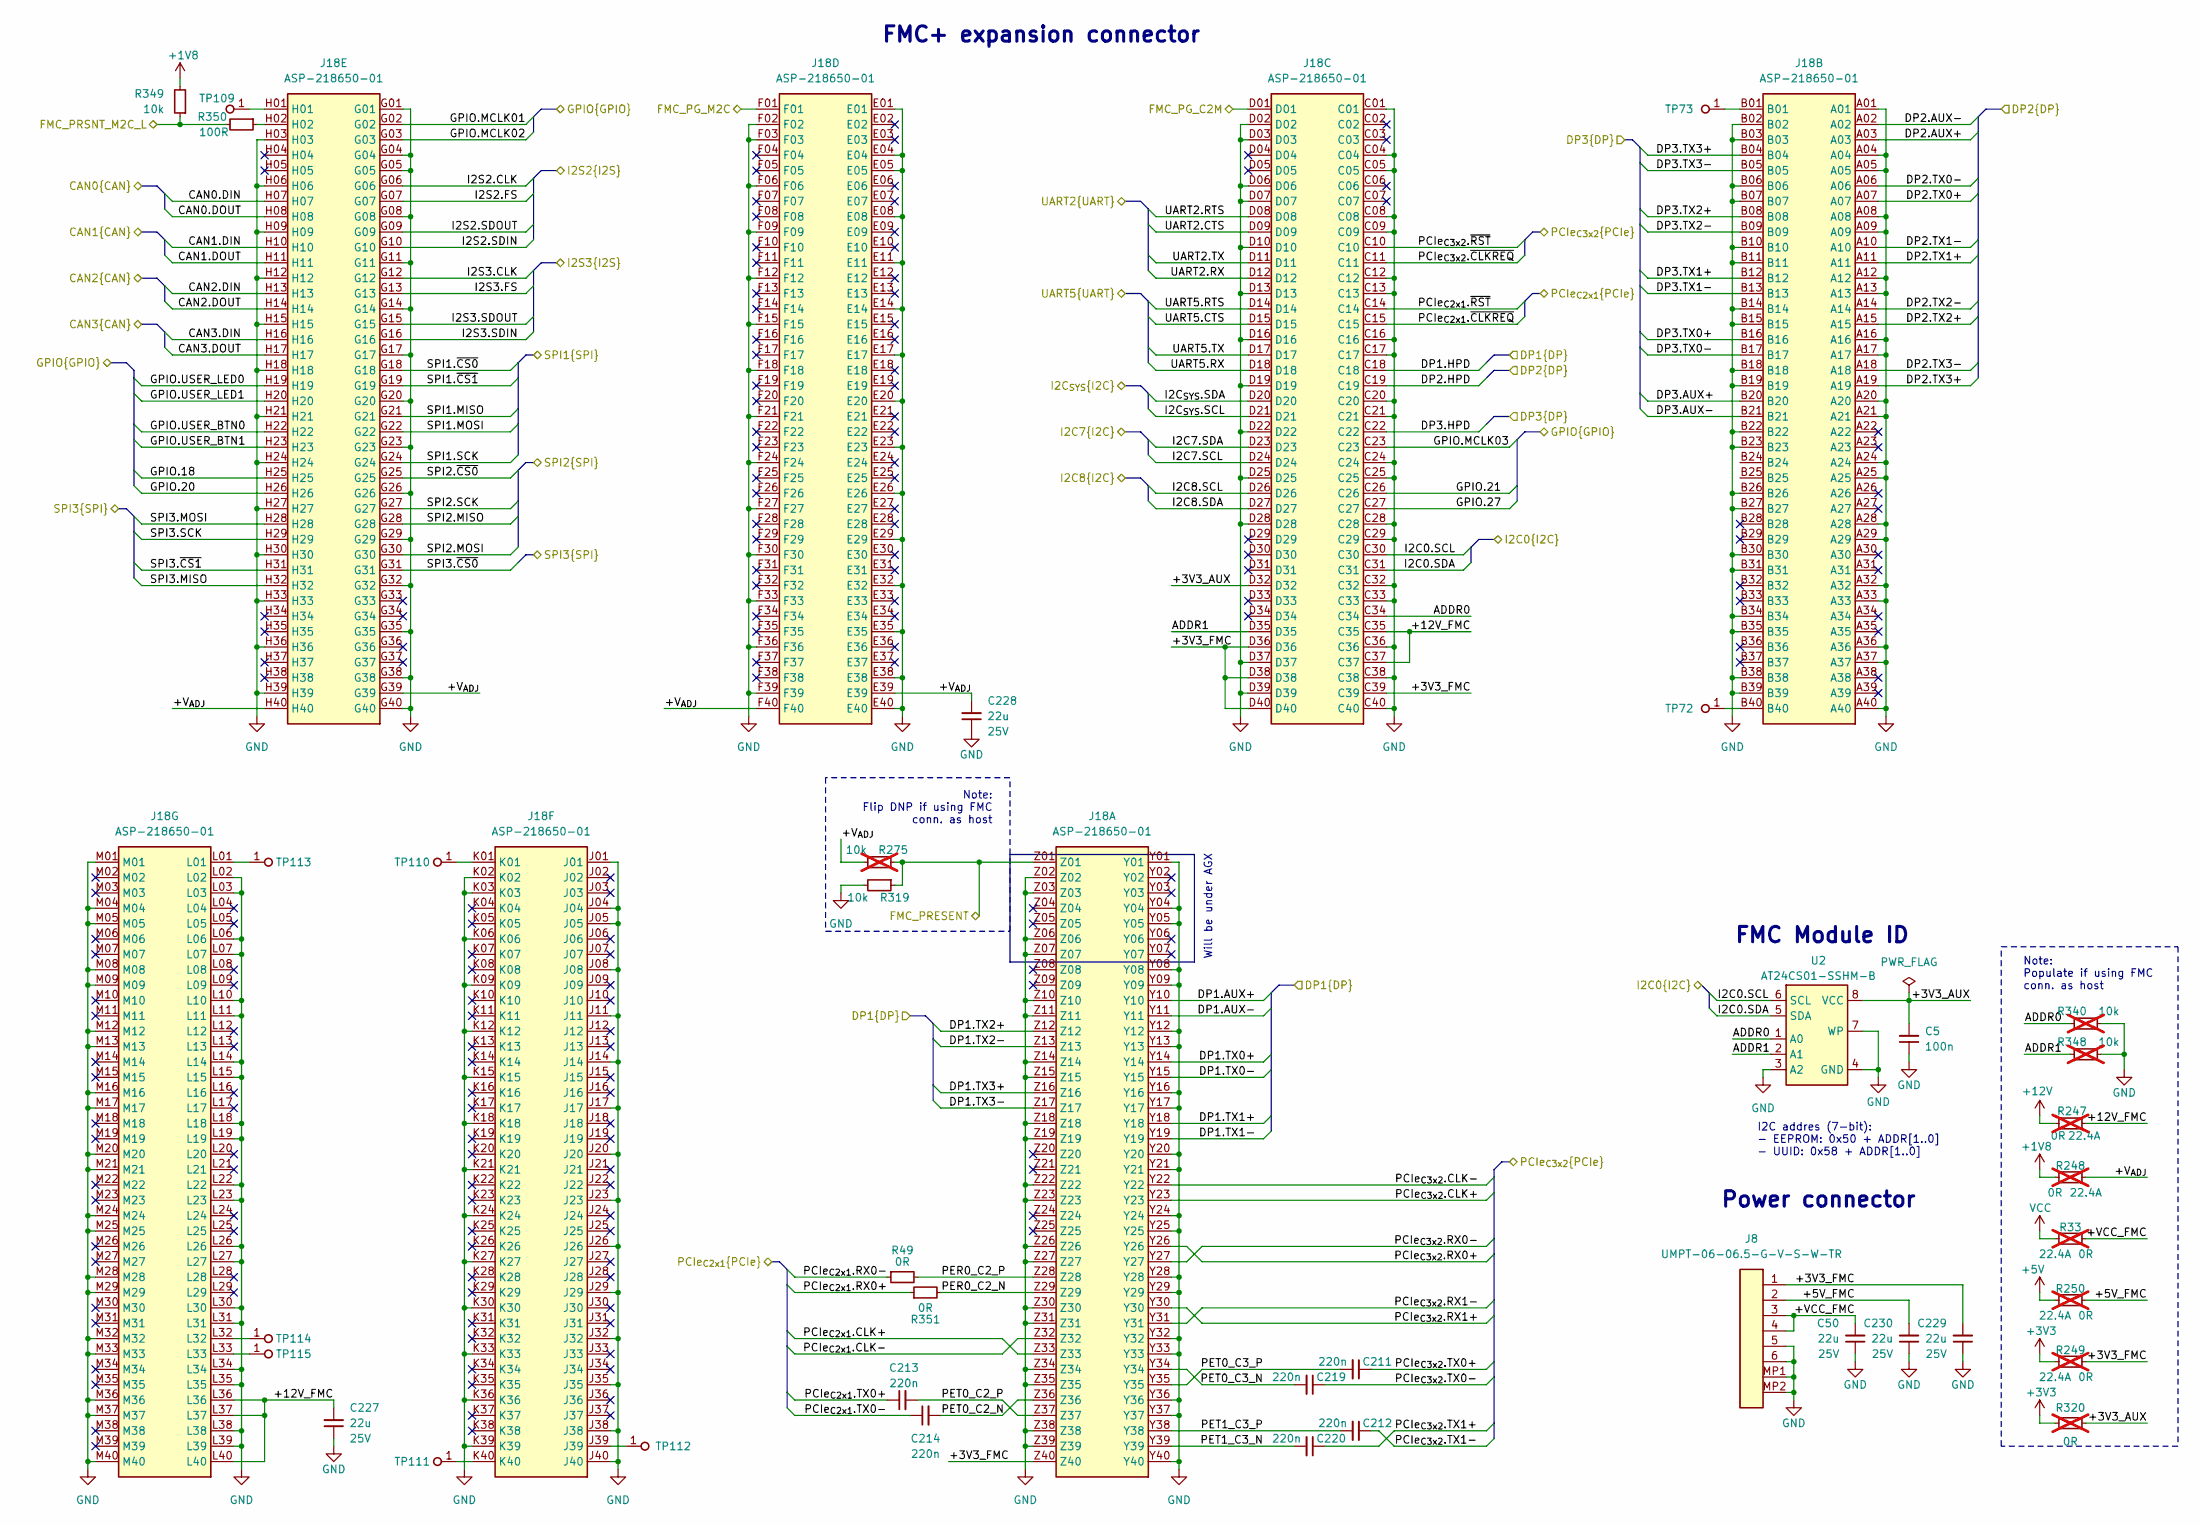
[picture p61: schematic expansion_connector.kicad_sch]

Parts:
C5: C_100n_0402; C_0402_1005Metric; Voltage 50V; MPN GRM155R61H104KE14D
C50, C227, C228, C229, C230: C_22u_25V_0805; C_0805_2012Metric; Voltage 25V; MPN CL21A226MAYNNNE
C211, C212, C213, C214, C219, C220: C_220n_0402; C_0402_1005Metric; Voltage 25V; MPN CC0402KRX5R6BB224
J8: Plug_Samtec_UMPT_1x6_UMPT-06-06.5-G-V-S-TR; Conn_Plug_Samtec_UMPT_1x6_UMPT-06-06.5-G-V-S-W-TR; MPN UMPT-06-06.5-G-V-S-W-TR
J18: ASP-218650-01_mounting_holes; MPN ASP-218650-01
R33, R247, R248, R249, R250: R_0R_22.4A_0603; R_0603_1608Metric; Tolerance template_tolerance; MPN PMR03EZPJ000; not fitted
R49, R351: R_0R_0402; R_0402_1005Metric; MPN ERJ2GE0R00X
R275, R340, R348: R_10k_0402; R_0402_1005Metric; Tolerance 1%; MPN CR0402-FX-1002GLF; not fitted
R319, R349: R_10k_0402; R_0402_1005Metric; Tolerance 1%; MPN CR0402-FX-1002GLF
R320: R_0R_0402; R_0402_1005Metric; MPN ERJ2GE0R00X; not fitted
R350: R_100R_0402; R_0402_1005Metric; Tolerance 1%; MPN CR0402-FX-1000GLF
TP72, TP73, TP109, TP110, TP111, TP112, TP113, TP114, TP115: TP_0.75mm_SMD; TP_SMD_0.75mm
U2: AT24CS01_SOIC8; SOIC-8-1EP_3.9x4.9x1.75mm_P1.27mm; MPN AT24CS01-SSHM-B

Connections:
+1V8: R248.2, R349.2
+3V3: R249.1, R320.1
+3V3_AUX: C5.2, J18.D32, R320.2, U2.8 (VCC)
+3V3_FMC: C229.2, J8.1, J18.C39, J18.D36, J18.D38, J18.D40, J18.Z40, R249.2
+5V: R250.1
+5V_FMC: C230.2, J8.2, R250.2
+12V: R247.2
+12V_FMC: C227.2, J18.C35, J18.C37, J18.L36, J18.L37, J18.L40, R247.1
+VCC_FMC: C50.2, J8.3, J8.4, R33.2
+V_{ADJ}: C228.2, J18.E39, J18.F40, J18.G39, J18.H40, R248.1, R275.2
ADDR0: J18.C34, R340.1, U2.1 (A0)
ADDR1: J18.D35, R348.1, U2.2 (A1)
CAN0.DIN: J18.H07
CAN0.DOUT: J18.H08
CAN1.DIN: J18.H10
CAN1.DOUT: J18.H11
CAN2.DIN: J18.H13
CAN2.DOUT: J18.H14
CAN3.DIN: J18.H16
CAN3.DOUT: J18.H17
DP1.AUX+: J18.Y10
DP1.AUX-: J18.Y11
DP1.HPD: J18.C18
DP1.TX0+: J18.Y14
DP1.TX0-: J18.Y15
DP1.TX1+: J18.Y18
DP1.TX1-: J18.Y19
DP1.TX2+: J18.Z12
DP1.TX2-: J18.Z13
DP1.TX3+: J18.Z16
DP1.TX3-: J18.Z17
DP2.AUX+: J18.A03
DP2.AUX-: J18.A02
DP2.HPD: J18.C19
DP2.TX0+: J18.A07
DP2.TX0-: J18.A06
DP2.TX1+: J18.A11
DP2.TX1-: J18.A10
DP2.TX2+: J18.A15
DP2.TX2-: J18.A14
DP2.TX3+: J18.A19
DP2.TX3-: J18.A18
DP3.AUX+: J18.B20
DP3.AUX-: J18.B21
DP3.HPD: J18.C22
DP3.TX0+: J18.B16
DP3.TX0-: J18.B17
DP3.TX1+: J18.B12
DP3.TX1-: J18.B13
DP3.TX2+: J18.B08
DP3.TX2-: J18.B09
DP3.TX3+: J18.B04
DP3.TX3-: J18.B05
FMC_PG_C2M: J18.D01
FMC_PG_M2C: J18.F01
FMC_PRESENT: J18.Z01, R275.1, R319.1
FMC_PRSNT_M2C_L: R349.1, R350.2
GND: C5.1, C50.1, C227.1, C228.1, C229.1, C230.1, J8.5, J8.6, J8.MP1, J8.MP2, J18.A01, J18.A04, J18.A05, J18.A08, J18.A09, J18.A12, J18.A13, J18.A16, J18.A17, J18.A20, J18.A21, J18.A24, J18.A25, J18.A28, J18.A29, J18.A32, J18.A33, J18.A36, J18.A37, J18.A40, J18.B02, J18.B03, J18.B06, J18.B07, J18.B10, J18.B11, J18.B14, J18.B15, J18.B18, J18.B19, J18.B22, J18.B23, J18.B26, J18.B27, J18.B30, J18.B31, J18.B34, J18.B35, J18.B38, J18.B39, J18.C01, J18.C04, J18.C05, J18.C08, J18.C09, J18.C12, J18.C13, J18.C16, J18.C17, J18.C20, J18.C21, J18.C24, J18.C25, J18.C28, J18.C29, J18.C32, J18.C33, J18.C36, J18.C38, J18.C40, J18.D02, J18.D03, J18.D06, J18.D07, J18.D10, J18.D13, J18.D16, J18.D19, J18.D22, J18.D25, J18.D28, J18.D37, J18.D39, J18.E01, J18.E04, J18.E05, J18.E08, J18.E11, J18.E14, J18.E17, J18.E20, J18.E23, J18.E26, J18.E29, J18.E32, J18.E35, J18.E38, J18.E40, J18.F02, J18.F03, J18.F06, J18.F09, J18.F12, J18.F15, J18.F18, J18.F21, J18.F24, J18.F27, J18.F30, J18.F33, J18.F36, J18.F39, J18.G01, J18.G04, J18.G05, J18.G08, J18.G11, J18.G14, J18.G17, J18.G20, J18.G23, J18.G26, J18.G29, J18.G32, J18.G35, J18.G38, J18.G40, J18.H03, J18.H06, J18.H09, J18.H12, J18.H15, J18.H18, J18.H21, J18.H24, J18.H27, J18.H30, J18.H33, J18.H36, J18.H39, J18.J01, J18.J04, J18.J05, J18.J08, J18.J11, J18.J14, J18.J17, J18.J20, J18.J23, J18.J26, J18.J29, J18.J32, J18.J35, J18.J38, J18.J40, J18.K02, J18.K03, J18.K06, J18.K09, J18.K12, J18.K15, J18.K18, J18.K21, J18.K24, J18.K27, J18.K30, J18.K33, J18.K36, J18.K39, J18.L02, J18.L03, J18.L06, J18.L07, J18.L10, J18.L11, J18.L14, J18.L15, J18.L18, J18.L19, J18.L22, J18.L23, J18.L26, J18.L27, J18.L30, J18.L31, J18.L34, J18.L35, J18.L38, J18.L39, J18.M01, J18.M04, J18.M05, J18.M08, J18.M09, J18.M12, J18.M13, J18.M16, J18.M17, J18.M20, J18.M21, J18.M24, J18.M25, J18.M28, J18.M29, J18.M32, J18.M33, J18.M36, J18.M37, J18.M40, J18.Y01, J18.Y04, J18.Y05, J18.Y08, J18.Y09, J18.Y12, J18.Y13, J18.Y16, J18.Y17, J18.Y20, J18.Y21, J18.Y24, J18.Y25, J18.Y28, J18.Y29, J18.Y32, J18.Y33, J18.Y36, J18.Y37, J18.Y40, J18.Z02, J18.Z03, J18.Z06, J18.Z07, J18.Z10, J18.Z11, J18.Z14, J18.Z15, J18.Z18, J18.Z19, J18.Z22, J18.Z23, J18.Z26, J18.Z27, J18.Z30, J18.Z31, J18.Z34, J18.Z35, J18.Z38, J18.Z39, R319.2, R340.2, R348.2, U2.3 (A2), U2.4 (GND), U2.7 (WP)
GPIO.18: J18.H25
GPIO.20: J18.H26
GPIO.21: J18.C26
GPIO.27: J18.C27
GPIO.MCLK01: J18.G02
GPIO.MCLK02: J18.G03
GPIO.MCLK03: J18.C23
GPIO.USER_BTN0: J18.H22
GPIO.USER_BTN1: J18.H23
GPIO.USER_LED0: J18.H19
GPIO.USER_LED1: J18.H20
I2C0.SCL: J18.C30, U2.6 (SCL)
I2C0.SDA: J18.C31, U2.5 (SDA)
I2C7.SCL: J18.D24
I2C7.SDA: J18.D23
I2C8.SCL: J18.D26
I2C8.SDA: J18.D27
I2C_{SYS}.SCL: J18.D21
I2C_{SYS}.SDA: J18.D20
I2S2.CLK: J18.G06
I2S2.FS: J18.G07
I2S2.SDIN: J18.G10
I2S2.SDOUT: J18.G09
I2S3.CLK: J18.G12
I2S3.FS: J18.G13
I2S3.SDIN: J18.G16
I2S3.SDOUT: J18.G15
unnamed: J18.B01, TP73.1
unnamed: J18.B40, TP72.1
unnamed: J18.H01, TP109.1
unnamed: J18.H02, R350.1
unnamed: J18.J39, TP112.1
unnamed: J18.K01, TP110.1
unnamed: J18.K40, TP111.1
unnamed: J18.L01, TP113.1
unnamed: J18.L32, TP114.1
unnamed: J18.L33, TP115.1
PCIe_{C2x1}.CLK+: J18.Z33
PCIe_{C2x1}.CLK-: J18.Z32
PCIe_{C2x1}.RX0+: R351.1
PCIe_{C2x1}.RX0-: R49.1
PCIe_{C2x1}.TX0+: C213.1
PCIe_{C2x1}.TX0-: C214.1
PCIe_{C2x1}.~CLKREQ: J18.C15
PCIe_{C2x1}.~RST: J18.C14
PCIe_{C3x2}.CLK+: J18.Y23
PCIe_{C3x2}.CLK-: J18.Y22
PCIe_{C3x2}.RX0+: J18.Y26
PCIe_{C3x2}.RX0-: J18.Y27
PCIe_{C3x2}.RX1+: J18.Y30
PCIe_{C3x2}.RX1-: J18.Y31
PCIe_{C3x2}.TX0+: C211.1
PCIe_{C3x2}.TX0-: C219.1
PCIe_{C3x2}.TX1+: C220.1
PCIe_{C3x2}.TX1-: C212.1
PCIe_{C3x2}.~CLKREQ: J18.C11
PCIe_{C3x2}.~RST: J18.C10
PER0_C2_N: J18.Z29, R351.2
PER0_C2_P: J18.Z28, R49.2
PET0_C2_N: C214.2, J18.Z36
PET0_C2_P: C213.2, J18.Z37
PET0_C3_N: C219.2, J18.Y34
PET0_C3_P: C211.2, J18.Y35
PET1_C3_N: C220.2, J18.Y39
PET1_C3_P: C212.2, J18.Y38
SPI1.MISO: J18.G21
SPI1.MOSI: J18.G22
SPI1.SCK: J18.G24
SPI1.~CS0: J18.G18
SPI1.~CS1: J18.G19
SPI2.MISO: J18.G28
SPI2.MOSI: J18.G30
SPI2.SCK: J18.G27
SPI2.~CS0: J18.G25
SPI3.MISO: J18.H32
SPI3.MOSI: J18.H28
SPI3.SCK: J18.H29
SPI3.~CS0: J18.G31
SPI3.~CS1: J18.H31
UART2.CTS: J18.D09
UART2.RTS: J18.D08
UART2.RX: J18.D12
UART2.TX: J18.D11
UART5.CTS: J18.D15
UART5.RTS: J18.D14
UART5.RX: J18.D18
UART5.TX: J18.D17
VCC: R33.1

Notes on the sheet:
Will be under AGX
Note: Populate if using FMC conn. as host
FMC Module ID
FMC+ expansion connector
I2C addres (7-bit): - EEPROM: 0x50 + ADDR[1..0] - UUID: 0x58 + ADDR[1..0]
Note: Flip DNP if using FMC conn. as host
Power connector
