phuongnamzz/jetson-agx-thor-baseboard/jetson-agx-thor-baseboard_full3D/jetson-agx-thor-baseboard.kicad_sch

## KiCad design jetson-agx-thor-baseboard_full3D/jetson-agx-thor-baseboard.kicad_sch (2026-10-11)

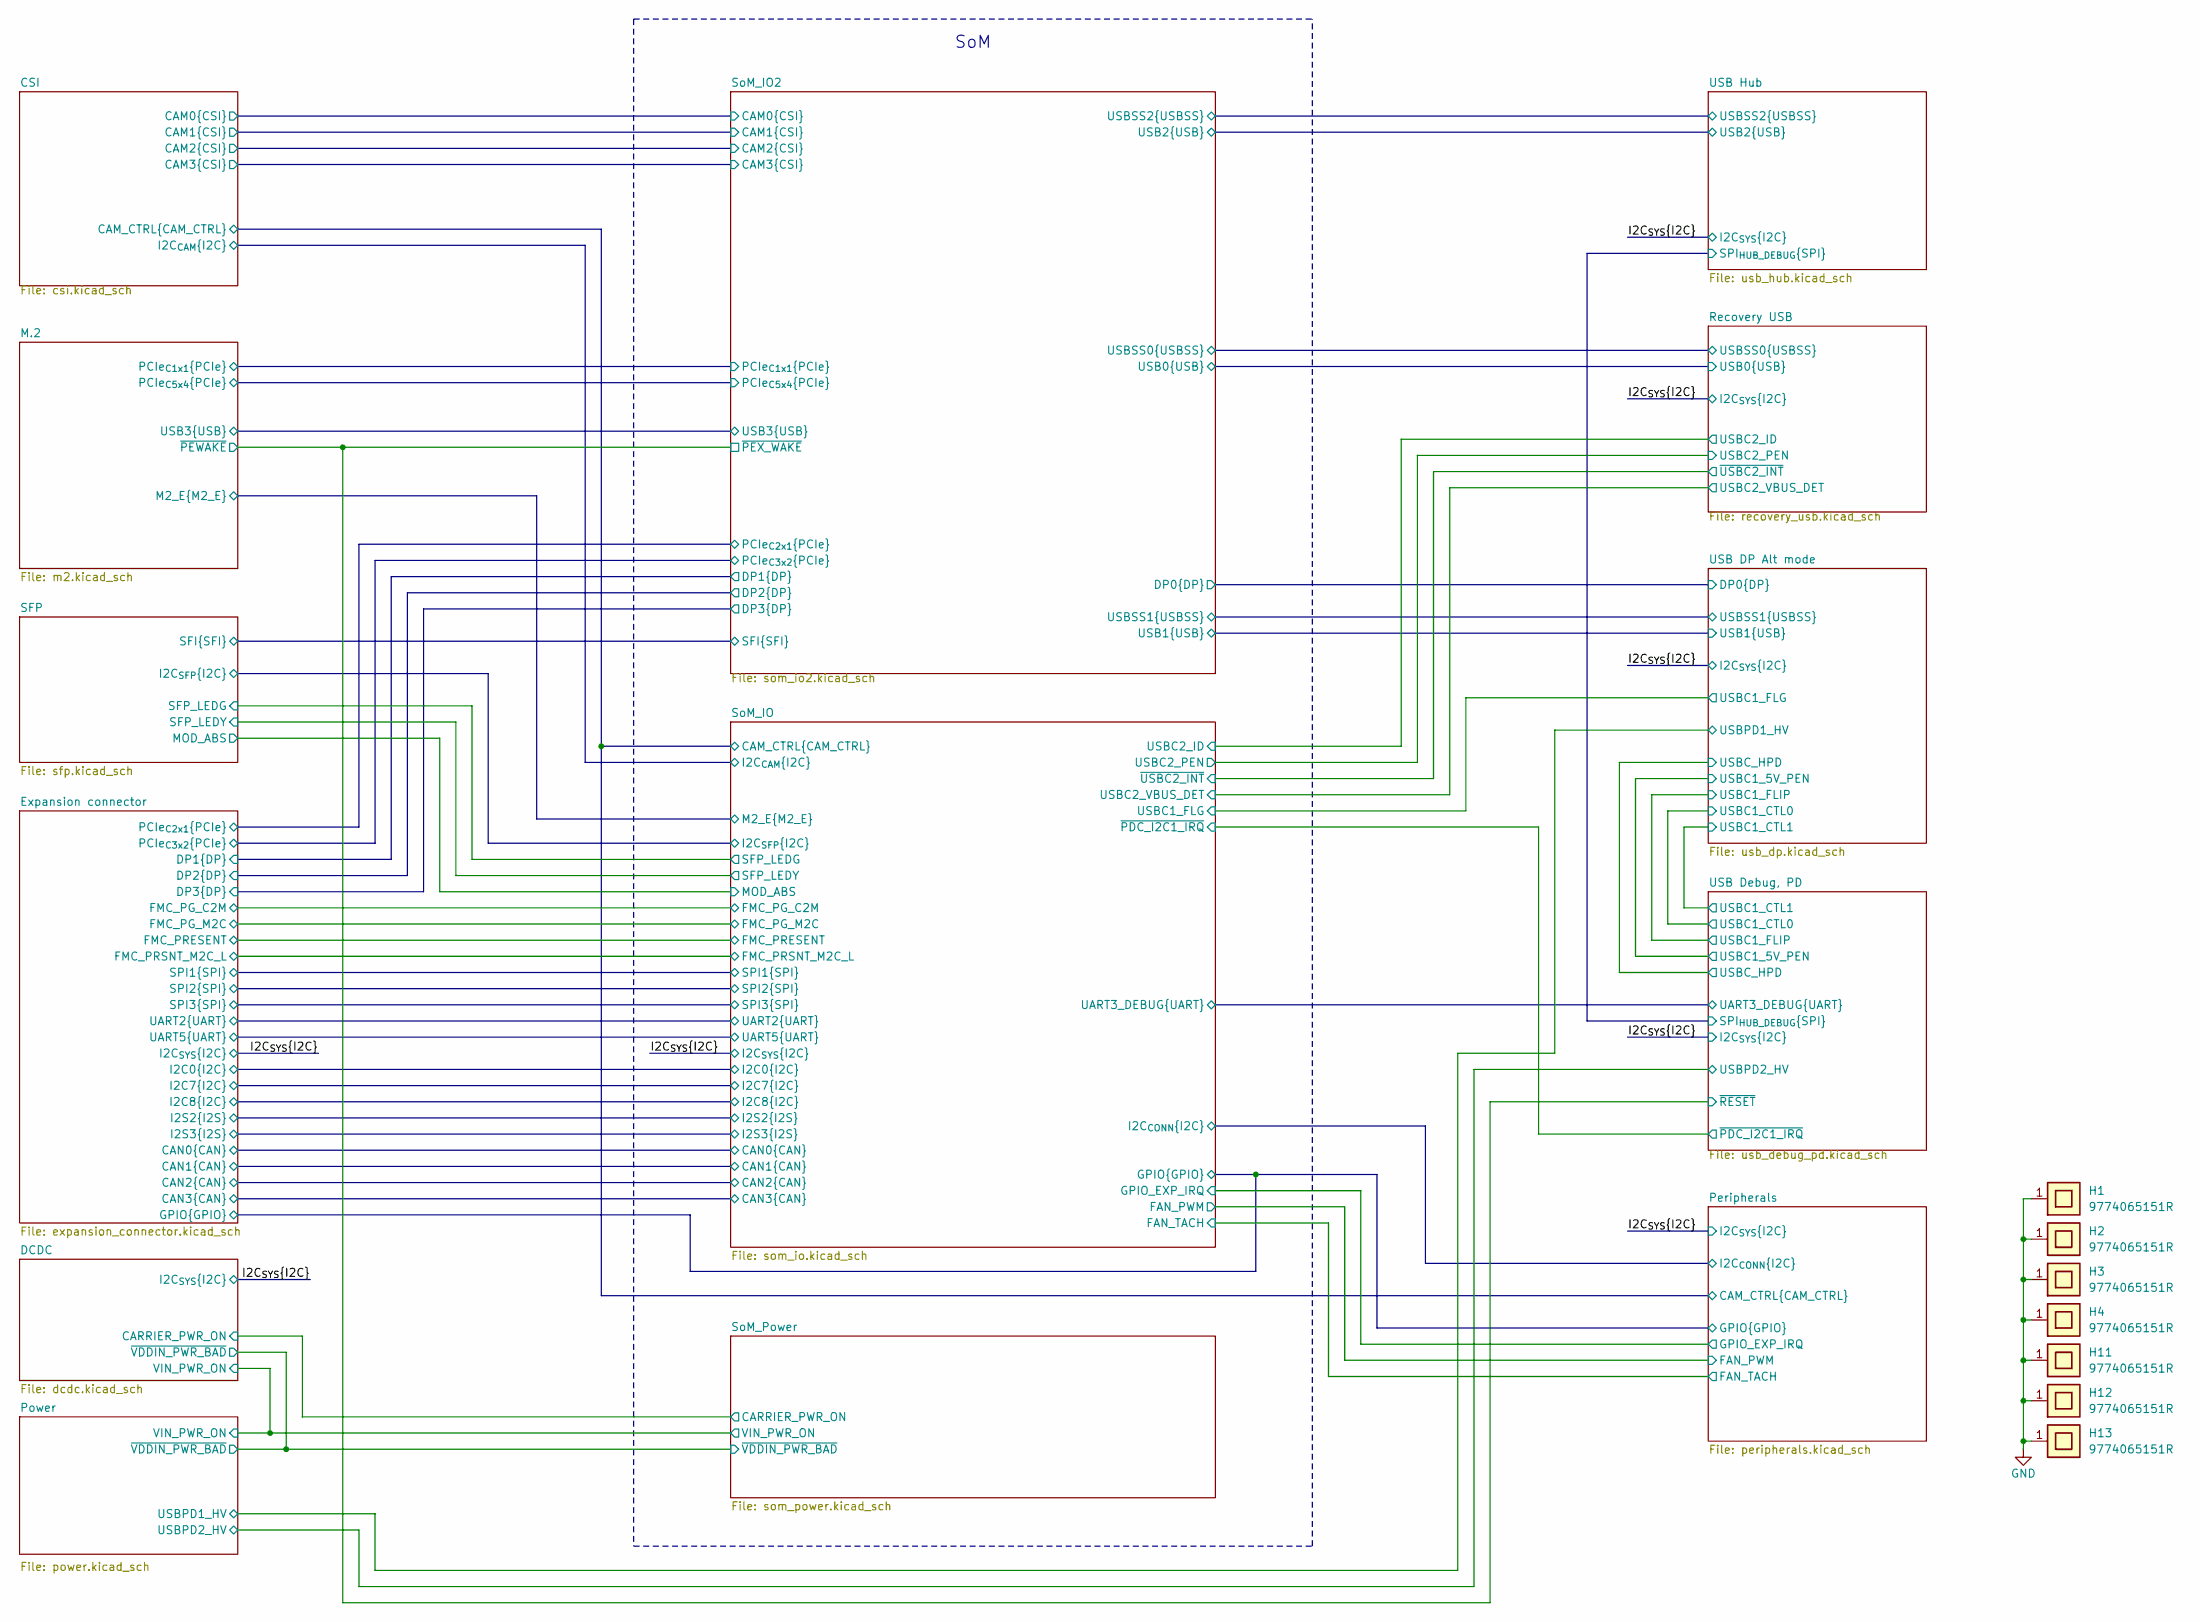
[picture p62: schematic jetson-agx-thor-baseboard.kicad_sch]

Parts:
H1, H2, H3, H4, H11, H12, H13: Spacer_Drill3.7mm_H6.5mm_9774065151R; MPN 9774065151R

Connections:
GND: H1.1, H2.1, H3.1, H4.1, H11.1, H12.1, H13.1

Notes on the sheet:
SoM
