phuongnamzz/jetson-agx-thor-baseboard/jetson-agx-thor-baseboard_full3D/level_shifter_x8.kicad_sch

## KiCad design jetson-agx-thor-baseboard_full3D/level_shifter_x8.kicad_sch (2026-10-11)

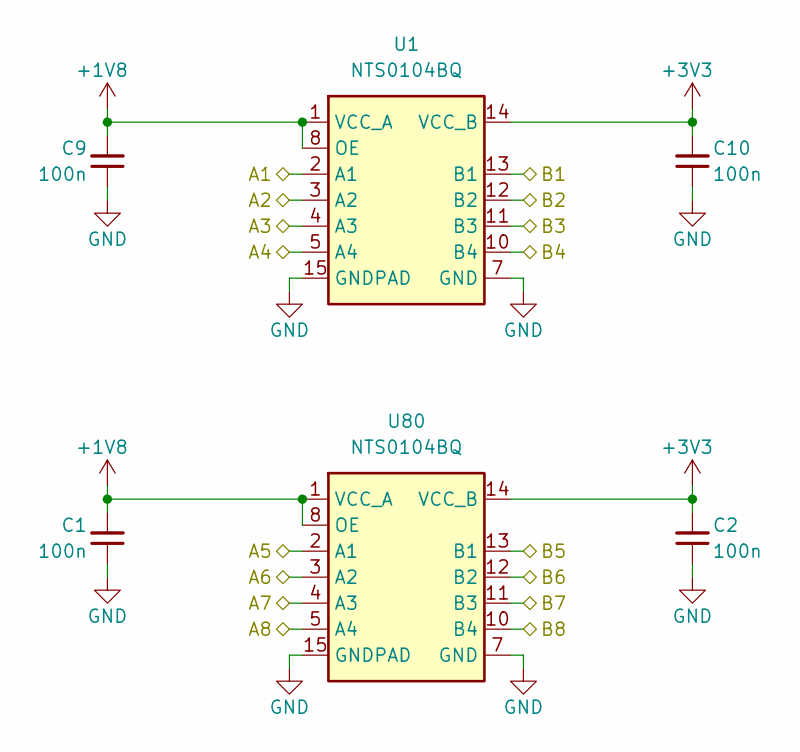
[picture p63: schematic level_shifter_x8.kicad_sch]

Parts:
C1, C2, C9, C10: C_100n_0402; C_0402_1005Metric; Voltage 50V; MPN GRM155R61H104KE14D
U1, U80: NTS0104_DHVQFN; DHVQFN-14-1EP_2.5x3mm; MPN NTS0104BQ

Connections:
+1V8: C1.2, C9.2, U1.1 (VCC_A), U1.8 (OE), U80.1 (VCC_A), U80.8 (OE)
+3V3: C2.2, C10.2, U1.14 (VCC_B), U80.14 (VCC_B)
A1: U1.2 (A1)
A2: U1.3 (A2)
A3: U1.4 (A3)
A4: U1.5 (A4)
A5: U80.2 (A1)
A6: U80.3 (A2)
A7: U80.4 (A3)
A8: U80.5 (A4)
B1: U1.13 (B1)
B2: U1.12 (B2)
B3: U1.11 (B3)
B4: U1.10 (B4)
B5: U80.13 (B1)
B6: U80.12 (B2)
B7: U80.11 (B3)
B8: U80.10 (B4)
GND: C1.1, C2.1, C9.1, C10.1, U1.7 (GND), U1.15 (GNDPAD), U80.7 (GND), U80.15 (GNDPAD)
