phuongnamzz/jetson-agx-thor-baseboard/jetson-agx-thor-baseboard_full3D/peripherals.kicad_sch

## KiCad design jetson-agx-thor-baseboard_full3D/peripherals.kicad_sch (2026-10-11)

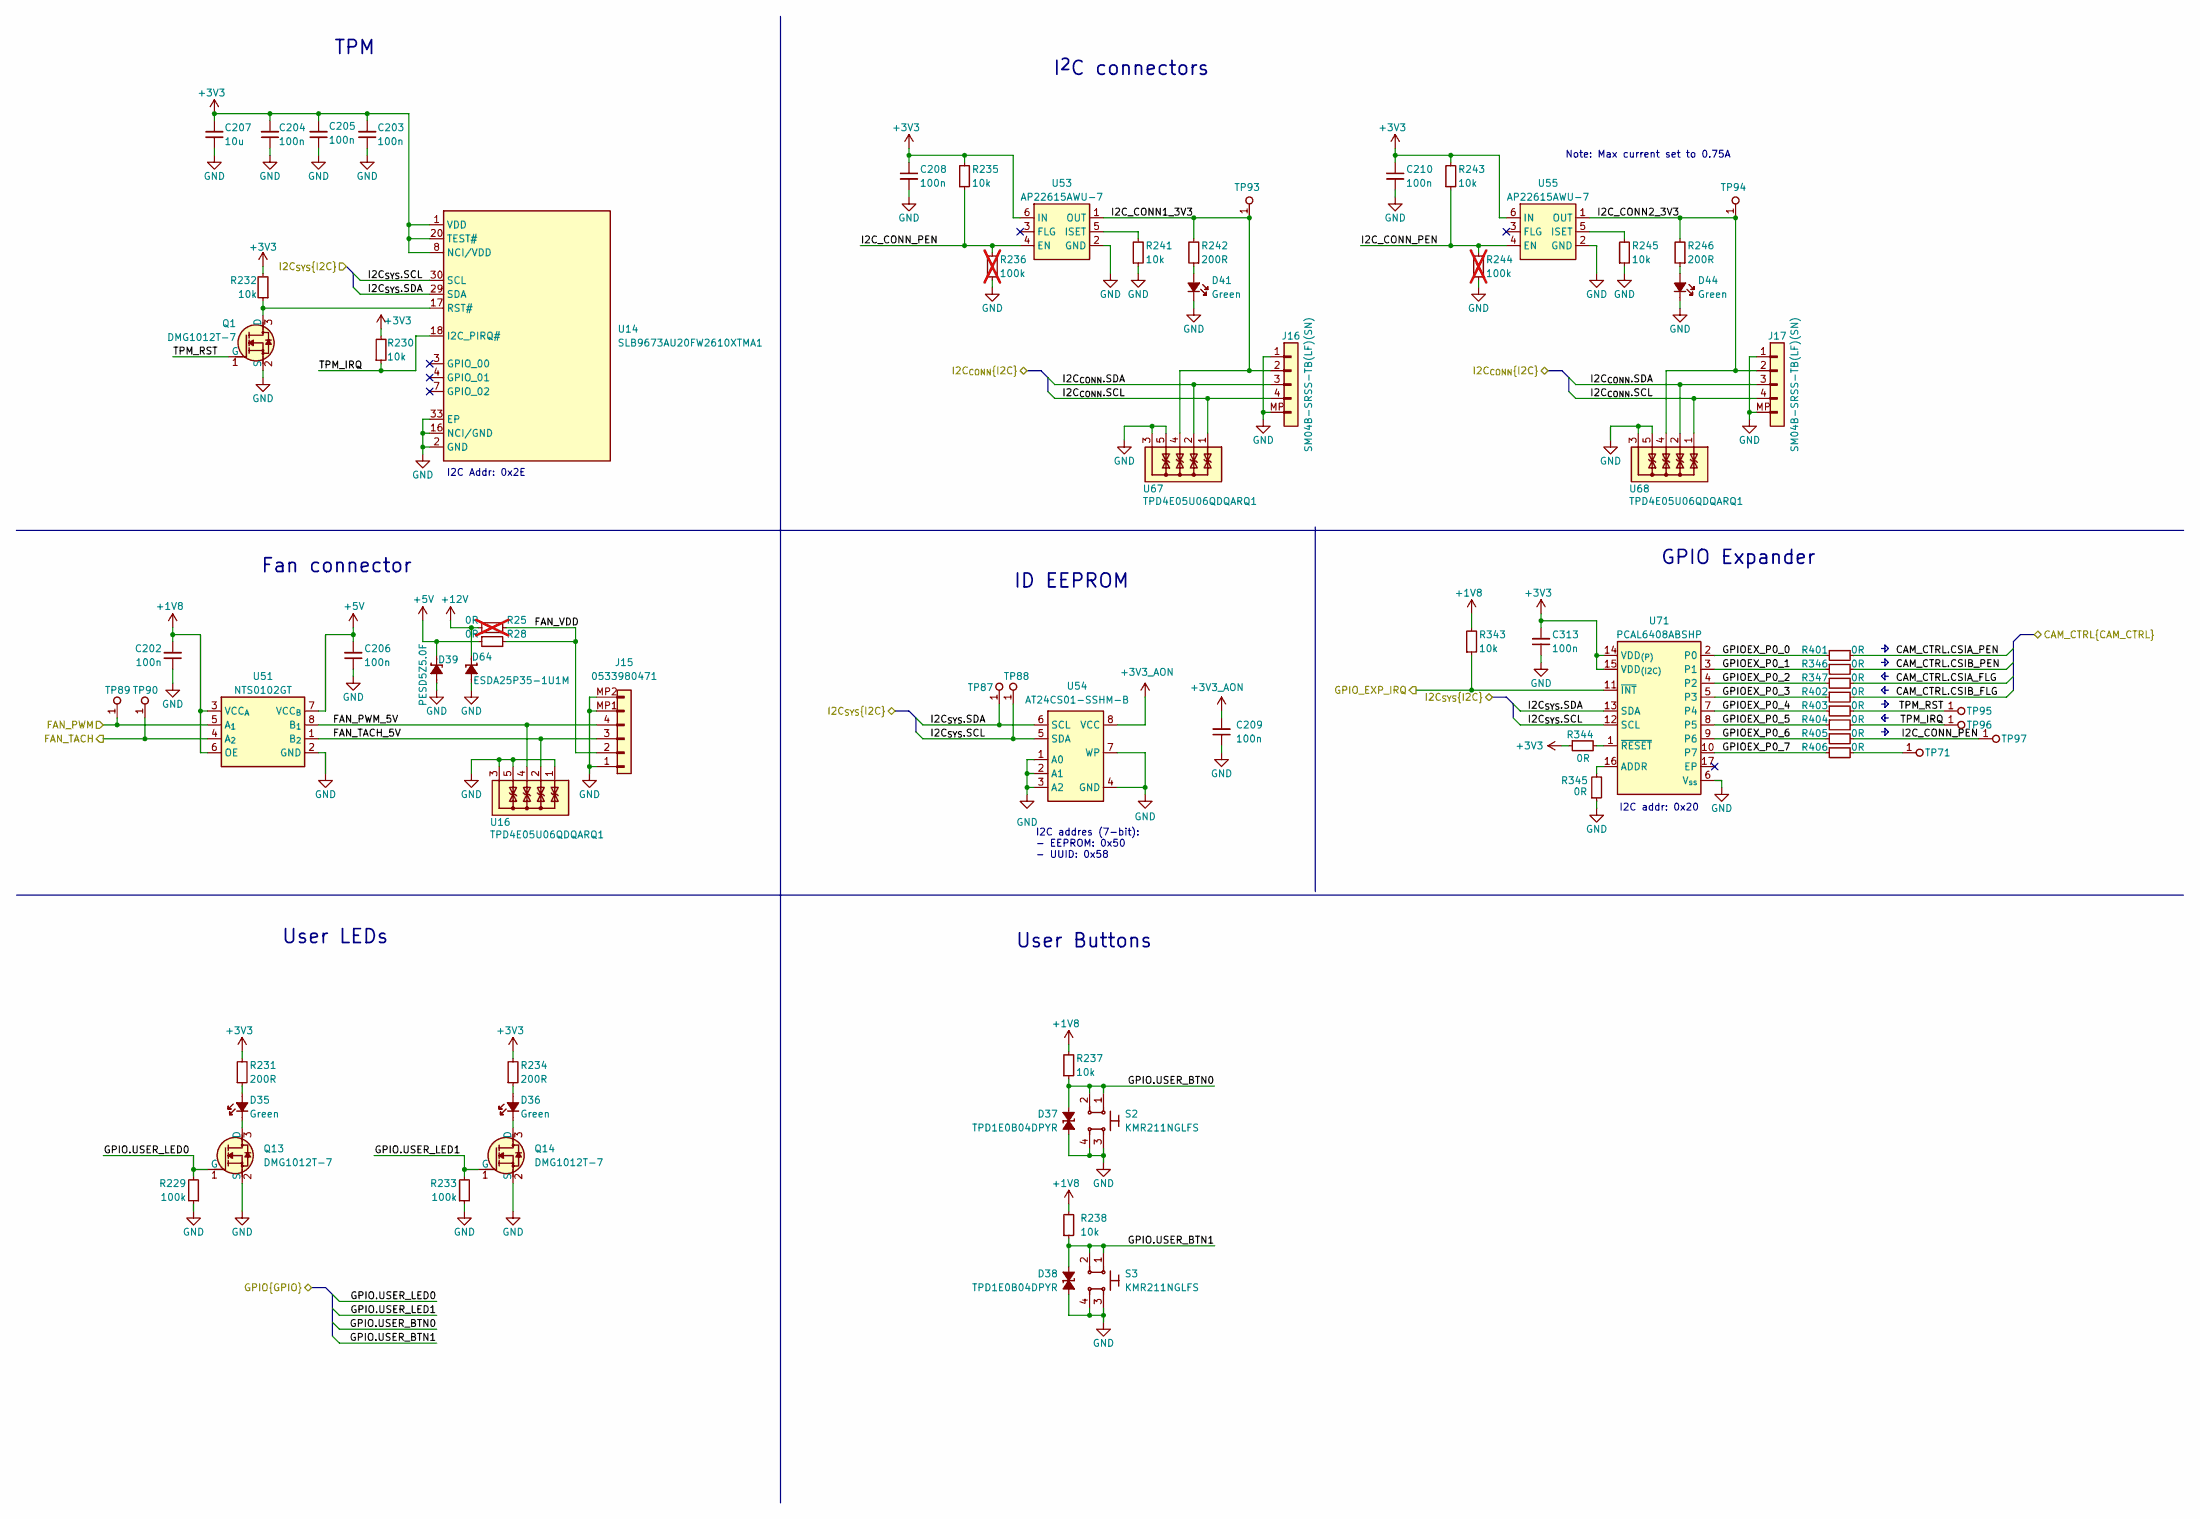
[picture p65: schematic peripherals.kicad_sch]

Parts:
C202, C203, C204, C205, C206, C208, C209, C210, C313: C_100n_0402; C_0402_1005Metric; Voltage 50V; MPN GRM155R61H104KE14D
C207: C_10u_0402; C_0402_1005Metric; Voltage 16V; MPN CC0402MRX5R5BB106
D35, D36, D41, D44: LED_G_0603_LTST-C190GKT; LED_0603_1608Metric_G; MPN LTST-C190GKT
D37, D38: TPD1E0B04_XDFN-2; XDFN-2_1x0.60mm; MPN TPD1E0B04DPYR
D39: PESD5Z5.0F; SOD-523; MPN PESD5Z5.0F
D64: ESDA25P35-1U1M; QFN-2L_1.6x1x0.55mm; MPN ESDA25P35-1U1M
J15: Molex_PicoBlade_1x4_0533980471; Conn_Molex_PicoBlade_1x4_0533980471; MPN 0533980471
J16, J17: JST_SH_1x4_SM04B-SRSS-TB-LF-SN; Conn_JST_SH_1x4_SM04B-SRSS-TB-LF-SN; MPN SM04B-SRSS-TB(LF)(SN)
Q1, Q13, Q14: DMG1012T-7; SOT-523; MPN DMG1012T-7
R25: R_0R_0402; R_0402_1005Metric; MPN ERJ2GE0R00X; not fitted
R28, R344, R345, R346, R347, R401, R402, R403, R404, R405, R406: R_0R_0402; R_0402_1005Metric; MPN ERJ2GE0R00X
R229, R233: R_100k_0402; R_0402_1005Metric; Tolerance 1%; MPN CR0402-FX-1003GLF
R230, R232, R235, R237, R238, R241, R243, R245, R343: R_10k_0402; R_0402_1005Metric; Tolerance 1%; MPN CR0402-FX-1002GLF
R231, R234, R242, R246: R_200R_0402; R_0402_1005Metric; Tolerance 1%; MPN CR0402-FX-2000GLF
R236, R244: R_100k_0402; R_0402_1005Metric; Tolerance 1%; MPN CR0402-FX-1003GLF; not fitted
S2, S3: SW_KMR211NGLFS_SMD; MPN KMR211NGLFS
TP71, TP87, TP88, TP89, TP90, TP93, TP94, TP95, TP96, TP97: TP_0.75mm_SMD; TP_SMD_0.75mm
U14: SLB9673AU20FW2610XTMA1; QFN-32-1EP_5x5mm; MPN SLB9673AU20FW2610XTMA1
U16, U67, U68: TPD4E05U06QDQARQ1; USON-10_2.5x1mm_P0.5mm; MPN TPD4E05U06QDQARQ1
U51: NTS0102_XSON; XSON-8_1x1.95mm_P0.5mm; MPN NTS0102GT
U53, U55: AP22615A_TSOT26; TSOT23-6; MPN AP22615AWU-7
U54: AT24CS01_SOIC8; SOIC-8-1EP_3.9x4.9x1.75mm_P1.27mm; MPN AT24CS01-SSHM-B
U71: PCAL6408A_VQFN; VQFN-16-1EP_3x3mm_P0.5mm_EP1.68x1.68mm; MPN PCAL6408ABSHP

Connections:
+1V8: C202.2, R237.2, R238.2, R343.2, U51.3 (VCC_{A}), U51.6 (OE)
+3V3: C203.2, C204.2, C205.2, C207.2, C208.1, C210.1, C313.2, R230.2, R231.2, R232.2, R234.2, R235.2, R243.2, R344.1, U14.1 (VDD), U14.8 (NCI/VDD), U14.14 (VDD), U14.20 (TEST#), U14.22 (VDD), U53.6 (IN), U55.6 (IN), U71.14 (VDD_{(P)}), U71.15 (VDD_{(I2C)})
+3V3_AON: C209.2, U54.8 (VCC)
+5V: C206.2, D39.1 (C), R28.1, U51.7 (VCC_{B})
+12V: D64.1 (C), R25.1
CAM_CTRL.CSIA_FLG: R347.2
CAM_CTRL.CSIA_PEN: R401.2
CAM_CTRL.CSIB_FLG: R402.2
CAM_CTRL.CSIB_PEN: R346.2
FAN_PWM: TP89.1, U51.5 (A_{1})
FAN_PWM_5V: J15.4, U16.4, U16.7, U51.8 (B_{1})
FAN_TACH: TP90.1, U51.4 (A_{2})
FAN_TACH_5V: J15.3, U16.2, U16.9, U51.1 (B_{2})
FAN_VDD: J15.2, R25.2, R28.2
GND: C202.1, C203.1, C204.1, C205.1, C206.1, C207.1, C208.2, C209.1, C210.2, C313.1, D37.1 (C), D38.1 (C), D39.2 (A), D41.1 (C), D44.1 (C), D64.2 (A), J15.1, J15.MP1, J15.MP2, J16.1, J16.MP, J17.1, J17.MP, Q1.2 (S), Q13.2 (S), Q14.2 (S), R229.1, R233.1, R236.1, R241.1, R244.1, R245.1, R345.1, S2.3, S2.4, S3.3, S3.4, U14.2 (GND), U14.9 (GND), U14.16 (NCI/GND), U14.23 (GND), U14.32 (GND), U14.33 (EP), U16.1, U16.3, U16.5, U16.6, U16.8, U16.10, U51.2 (GND), U53.2 (GND), U54.1 (A0), U54.2 (A1), U54.3 (A2), U54.4 (GND), U54.7 (WP), U55.2 (GND), U67.3, U67.5, U67.6, U67.8, U68.3, U68.5, U68.6, U68.8, U71.6 (V_{ss})
GPIO.USER_BTN0: D37.2 (A), R237.1, S2.1, S2.2
GPIO.USER_BTN1: D38.2 (A), R238.1, S3.1, S3.2
GPIO.USER_LED0: Q13.1 (G), R229.2
GPIO.USER_LED1: Q14.1 (G), R233.2
GPIOEX_P0_0: R401.1, U71.2 (P0)
GPIOEX_P0_1: R346.1, U71.3 (P1)
GPIOEX_P0_2: R347.1, U71.4 (P2)
GPIOEX_P0_3: R402.1, U71.5 (P3)
GPIOEX_P0_4: R403.1, U71.7 (P4)
GPIOEX_P0_5: R404.1, U71.8 (P5)
GPIOEX_P0_6: R405.1, U71.9 (P6)
GPIOEX_P0_7: R406.1, U71.10 (P7)
GPIO_EXP_IRQ: R343.1, U71.11 (~INT)
I2C_CONN1_3V3: J16.2, R242.2, TP93.1, U53.1 (OUT), U67.4, U67.7
I2C_CONN2_3V3: J17.2, R246.2, TP94.1, U55.1 (OUT), U68.4, U68.7
I2C_CONN_PEN: R235.1, R236.2, R243.1, R244.2, R405.2, TP97.1, U53.4 (EN), U55.4 (EN)
I2C_{CONN}.SCL: J16.4, J17.4, U67.1, U67.10, U68.1, U68.10
I2C_{CONN}.SDA: J16.3, J17.3, U67.2, U67.9, U68.2, U68.9
I2C_{SYS}.SCL: TP88.1, U14.30 (SCL), U54.5 (SDA), U71.12 (SCL)
I2C_{SYS}.SDA: TP87.1, U14.29 (SDA), U54.6 (SCL), U71.13 (SDA)
unnamed: D35.1 (C), Q13.3 (D)
unnamed: D35.2 (A), R231.1
unnamed: D36.1 (C), Q14.3 (D)
unnamed: D36.2 (A), R234.1
unnamed: D41.2 (A), R242.1
unnamed: D44.2 (A), R246.1
unnamed: Q1.3 (D), R232.1, U14.17 (RST#)
unnamed: R241.2, U53.5 (ISET)
unnamed: R245.2, U55.5 (ISET)
unnamed: R344.2, U71.1 (~RESET)
unnamed: R345.2, U71.16 (ADDR)
unnamed: R406.2, TP71.1
TPM_IRQ: R230.1, R404.2, TP96.1, U14.18 (I2C_PIRQ#)
TPM_RST: Q1.1 (G), R403.2, TP95.1

Notes on the sheet:
User Buttons
I2C Addr: 0x2E
Fan connector
I2C addr: 0x20
ID EEPROM
I^{2}C connectors
GPIO Expander
Note: Max current set to 0.75A
TPM
I2C addres (7-bit): - EEPROM: 0x50 - UUID: 0x58
User LEDs
