phuongnamzz/jetson-agx-thor-baseboard/jetson-agx-thor-baseboard_full3D/power.kicad_sch

## KiCad design jetson-agx-thor-baseboard_full3D/power.kicad_sch (2026-10-11)

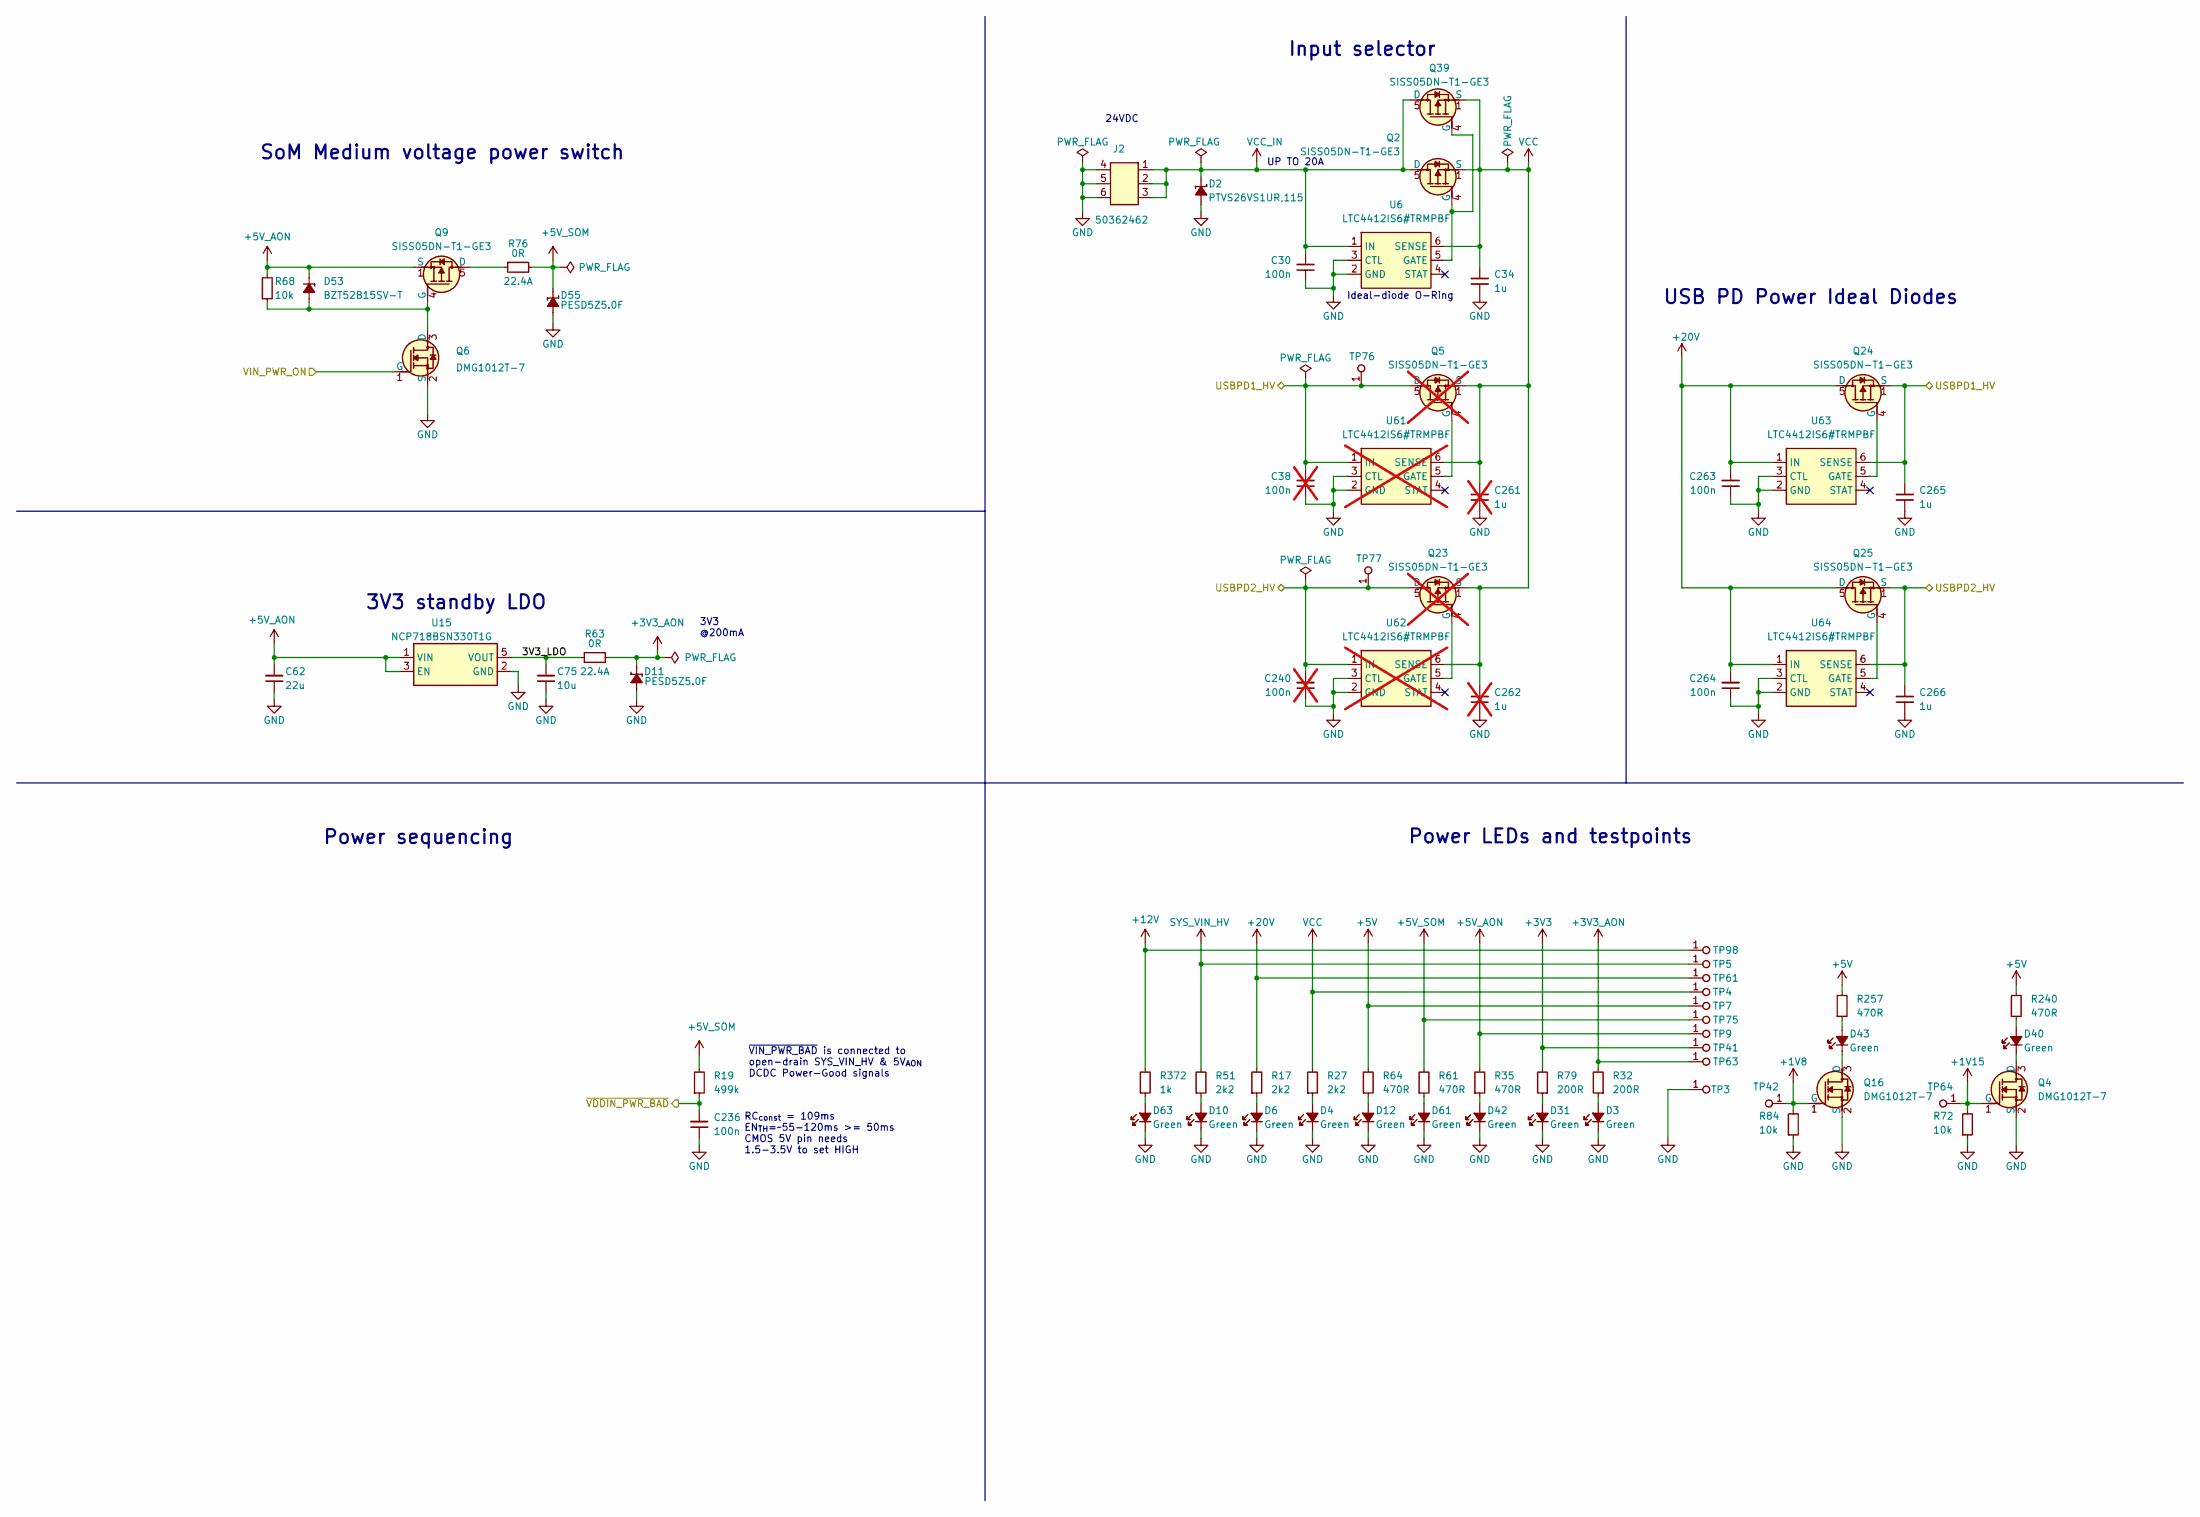
[picture p66: schematic power.kicad_sch]

Parts:
C30, C236, C263, C264: C_100n_0402; C_0402_1005Metric; Voltage 50V; MPN GRM155R61H104KE14D
C34, C265, C266: C_1u_25V_0402; C_0402_1005Metric; Voltage 25V; MPN GRM155R61E105KE11J
C38, C240: C_100n_0402; C_0402_1005Metric; Voltage 50V; MPN GRM155R61H104KE14D; not fitted
C62: C_22u_16V_0603; C_0603_1608Metric_EIA; Voltage 16V; MPN CL10A226MO7JZNC
C75: C_10u_0402; C_0402_1005Metric; MPN CC0402MRX5R5BB106
C261, C262: C_1u_25V_0402; C_0402_1005Metric; Voltage 25V; MPN GRM155R61E105KE11J; not fitted
D2: PTVS26VS1UR,115; D_SOD-123; MPN PTVS26VS1UR,115
D3, D4, D6, D10, D12, D31, D40, D42, D43, D61, D63: LED_G_0603_LTST-C190GKT; LED_0603_1608Metric_G; MPN LTST-C190GKT
D11, D55: PESD5Z5.0F; SOD-523; MPN PESD5Z5.0F
D53: BZT52B15SV-T; D_SOD-323; MPN BZT52B15SV-T
J2: Molex_Mini-Fit_2x3_50362462; MPN 50362462
Q2, Q9, Q24, Q25, Q39: SISS05DN-T1-GE3; Vishay_PowerPAK_1212-8_Single; MPN SISS05DN-T1-GE3
Q4, Q6, Q16: DMG1012T-7; SOT-523; MPN DMG1012T-7
Q5, Q23: SISS05DN-T1-GE3; Vishay_PowerPAK_1212-8_Single; MPN SISS05DN-T1-GE3; not fitted
R17, R27, R51: R_2k2_0402; R_0402_1005Metric; Tolerance 1%; MPN CR0402-FX-2201GLF
R19: R_499k_0402; R_0402_1005Metric; Tolerance 1%; MPN CR0402-FX-4993GLF
R32, R79: R_200R_0402; R_0402_1005Metric; Tolerance 1%; MPN CR0402-FX-2000GLF
R35, R61, R64, R240, R257: R_470R_0402; R_0402_1005Metric; Tolerance 1%; MPN CR0402-FX-4700GLF
R63, R76: R_0R_22.4A_0603; R_0603_1608Metric; Tolerance template_tolerance; MPN PMR03EZPJ000
R68, R72, R84: R_10k_0402; R_0402_1005Metric; Tolerance 1%; MPN CR0402-FX-1002GLF
R372: R_1k_0402; R_0402_1005Metric; Tolerance 1%; MPN CR0402-FX-1001GLF
TP3, TP4, TP5, TP7, TP9, TP41, TP42, TP61, TP63, TP64, TP75, TP76, TP77, TP98: TP_0.75mm_SMD; TP_SMD_0.75mm
U6, U63, U64: LTC4412IS6; SOT-23-6; MPN LTC4412IS6#TRMPBF
U15: NCP718BSN330T1G; SOT-23-5; MPN NCP718BSN330T1G
U61, U62: LTC4412IS6; SOT-23-6; MPN LTC4412IS6#TRMPBF; not fitted

Connections:
3V3_LDO: C75.2, R63.1, U15.5 (VOUT)
+1V8: Q16.1 (G), R84.2, TP42.1
+1V15: Q4.1 (G), R72.2, TP64.1
+3V3: R79.2, TP41.1
+3V3_AON: D11.1 (C), R32.2, R63.2, TP63.1
+5V: R64.2, R240.2, R257.2, TP7.1
+5V_AON: C62.2, D53.1 (C), Q9.1 (S), Q9.2 (S), Q9.3 (S), R35.2, R68.2, TP9.1, U15.1 (VIN), U15.3 (EN)
+5V_SOM: D55.1 (C), R19.2, R61.2, R76.2, TP75.1
+12V: R372.2, TP98.1
+20V: C263.2, C264.2, Q24.5 (D), Q25.5 (D), R17.2, TP61.1, U63.1 (IN), U64.1 (IN)
GND: C30.1, C34.1, C38.1, C62.1, C75.1, C236.1, C240.1, C261.1, C262.1, C263.1, C264.1, C265.1, C266.1, D2.2 (A), D3.1 (C), D4.1 (C), D6.1 (C), D10.1 (C), D11.2 (A), D12.1 (C), D31.1 (C), D42.1 (C), D55.2 (A), D61.1 (C), D63.1 (C), J2.4, J2.5, J2.6, Q4.2 (S), Q6.2 (S), Q16.2 (S), R72.1, R84.1, TP3.1, U6.2 (GND), U6.3 (CTL), U15.2 (GND), U61.2 (GND), U61.3 (CTL), U62.2 (GND), U62.3 (CTL), U63.2 (GND), U63.3 (CTL), U64.2 (GND), U64.3 (CTL)
unnamed: D3.2 (A), R32.1
unnamed: D4.2 (A), R27.1
unnamed: D6.2 (A), R17.1
unnamed: D10.2 (A), R51.1
unnamed: D12.2 (A), R64.1
unnamed: D31.2 (A), R79.1
unnamed: D40.1 (C), Q4.3 (D)
unnamed: D40.2 (A), R240.1
unnamed: D42.2 (A), R35.1
unnamed: D43.1 (C), Q16.3 (D)
unnamed: D43.2 (A), R257.1
unnamed: D53.2 (A), Q6.3 (D), Q9.4 (G), R68.1
unnamed: D61.2 (A), R61.1
unnamed: D63.2 (A), R372.1
unnamed: Q2.4 (G), Q39.4 (G), U6.5 (GATE)
unnamed: Q5.4 (G), U61.5 (GATE)
unnamed: Q9.5 (D), R76.1
unnamed: Q23.4 (G), U62.5 (GATE)
unnamed: Q24.4 (G), U63.5 (GATE)
unnamed: Q25.4 (G), U64.5 (GATE)
SYS_VIN_HV: R51.2, TP5.1
USBPD1_HV: C38.2, C265.2, Q5.5 (D), Q24.1 (S), Q24.2 (S), Q24.3 (S), TP76.1, U61.1 (IN), U63.6 (SENSE)
USBPD2_HV: C240.2, C266.2, Q23.5 (D), Q25.1 (S), Q25.2 (S), Q25.3 (S), TP77.1, U62.1 (IN), U64.6 (SENSE)
VCC: C34.2, C261.2, C262.2, Q2.1 (S), Q2.2 (S), Q2.3 (S), Q5.1 (S), Q5.2 (S), Q5.3 (S), Q23.1 (S), Q23.2 (S), Q23.3 (S), Q39.1 (S), Q39.2 (S), Q39.3 (S), R27.2, TP4.1, U6.6 (SENSE), U61.6 (SENSE), U62.6 (SENSE)
VCC_IN: C30.2, D2.1 (C), J2.1, J2.2, J2.3, Q2.5 (D), Q39.5 (D), U6.1 (IN)
VIN_PWR_ON: Q6.1 (G)
~VDDIN_PWR_BAD: C236.2, R19.1

Notes on the sheet:
SoM Medium voltage power switch
3V3 @200mA
USB PD Power Ideal Diodes
Power LEDs and testpoints
~{VIN_PWR_BAD} is connected to open-drain SYS_VIN_HV & 5V_{AON} DCDC Power-Good signals
Power sequencing
Input selector
UP TO 20A
Ideal-diode O-Ring
24VDC
3V3 standby LDO
RC_{const} = 109ms EN_{TH}=~55-120ms >= 50ms CMOS 5V pin needs 1.5-3.5V to set HIGH
