phuongnamzz/jetson-agx-thor-baseboard/jetson-agx-thor-baseboard_full3D/sfp.kicad_sch

## KiCad design jetson-agx-thor-baseboard_full3D/sfp.kicad_sch (2026-10-11)

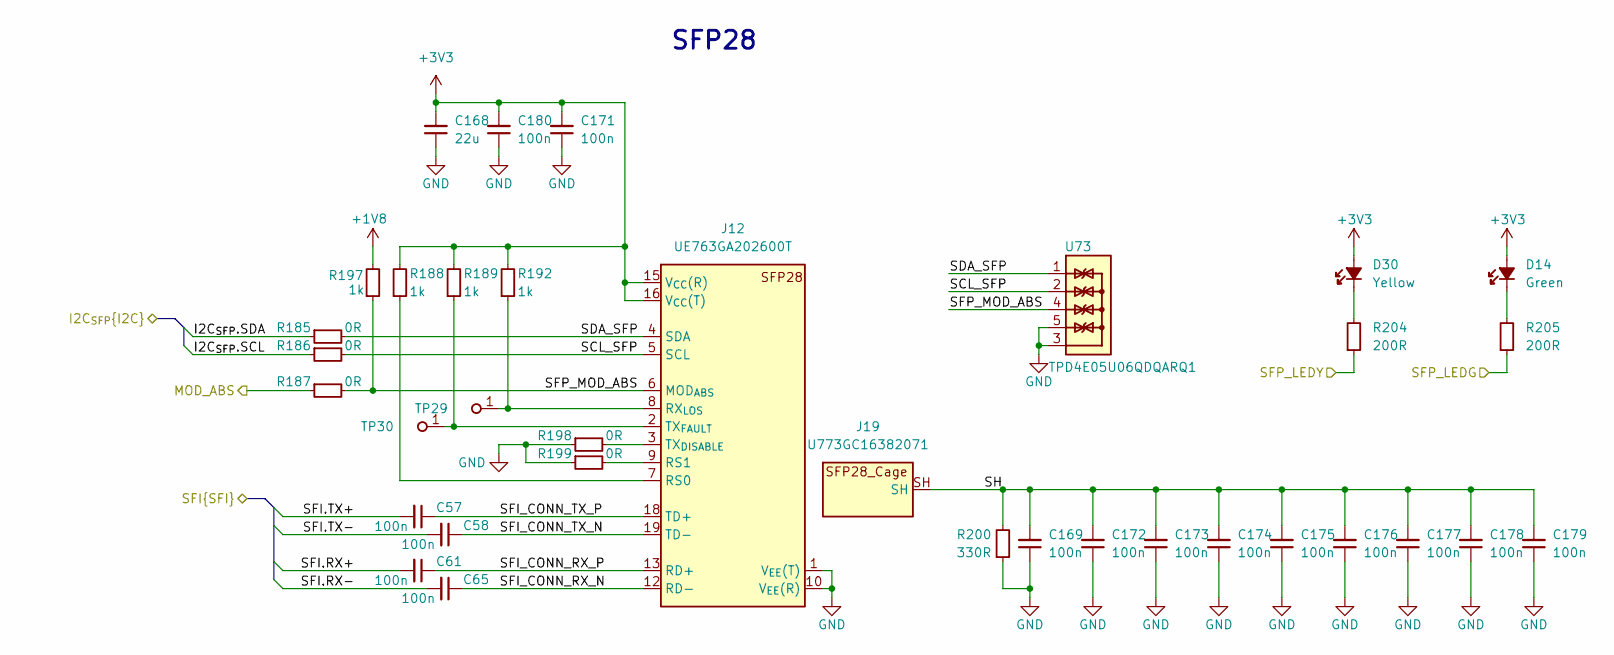
[picture p68: schematic sfp.kicad_sch]

Parts:
C57, C58, C61, C65, C169, C171, C172, C173, C174, C175, C176, C177, C178, C179, C180: C_100n_0402; C_0402_1005Metric; Voltage 50V; MPN GRM155R61H104KE14D
C168: C_22u_16V_0603; C_0603_1608Metric_EIA; Voltage 16V; MPN CL10A226MO7JZNC
D14: LED_G_0603_LTST-C190GKT; LED_0603_1608Metric_G; MPN LTST-C190GKT
D30: LED_Y_0603_LTST-C191KSKT; LED_0603_1608Metric_Y; MPN LTST-C191KSKT
J12: Amphenol_SFP28_1x20_UE763GA202600T; Conn_Amphenol_SFP28_1x20_UE763GA202600T; MPN UE763GA202600T
J19: Amphenol_SFP28_Cage_U773GC16382071; Conn_Amphenol_SFP28_Cage_U773GC16382071; MPN U773GC16382071
R185, R186, R187, R198, R199: R_0R_0402; R_0402_1005Metric; MPN ERJ2GE0R00X
R188, R189, R192, R197: R_1k_0402; R_0402_1005Metric; Tolerance 1%; MPN CR0402-FX-1001GLF
R200: R_330R_0402; R_0402_1005Metric; Tolerance 1%; MPN CR0402-FX-3300GLF
R204, R205: R_200R_0402; R_0402_1005Metric; Tolerance 1%; MPN CR0402-FX-2000GLF
TP29, TP30: TP_0.75mm_SMD; TP_SMD_0.75mm
U73: TPD4E05U06QDQARQ1; USON-10_2.5x1mm_P0.5mm; MPN TPD4E05U06QDQARQ1

Connections:
+1V8: R197.2
+3V3: C168.2, C171.2, C180.2, D14.2 (A), D30.2 (A), J12.15 (V_{CC}(R)), J12.16 (V_{CC}(T)), R188.2, R189.2, R192.2
GND: C168.1, C169.1, C171.1, C172.1, C173.1, C174.1, C175.1, C176.1, C177.1, C178.1, C179.1, C180.1, J12.1 (V_{EE}(T)), J12.10 (V_{EE}(R)), J12.11 (V_{EE}(R)), J12.14 (V_{EE}(R)), J12.17 (V_{EE}(T)), J12.20 (V_{EE}(T)), R198.1, R199.1, R200.1, U73.3, U73.5, U73.6, U73.8
I2C_{SFP}.SCL: R186.1
I2C_{SFP}.SDA: R185.1
MOD_ABS: R187.1
unnamed: D14.1 (C), R205.2
unnamed: D30.1 (C), R204.2
unnamed: J12.2 (TX_{FAULT}), R189.1, TP30.1
unnamed: J12.3 (TX_{DISABLE}), R198.2
unnamed: J12.7 (RS0), R188.1
unnamed: J12.8 (RX_{LOS}), R192.1, TP29.1
unnamed: J12.9 (RS1), R199.2
SCL_SFP: J12.5 (SCL), R186.2, U73.2, U73.9
SDA_SFP: J12.4 (SDA), R185.2, U73.1, U73.10
SFI.RX+: C61.2
SFI.RX-: C65.2
SFI.TX+: C57.2
SFI.TX-: C58.2
SFI_CONN_RX_N: C65.1, J12.12 (RD-)
SFI_CONN_RX_P: C61.1, J12.13 (RD+)
SFI_CONN_TX_N: C58.1, J12.19 (TD-)
SFI_CONN_TX_P: C57.1, J12.18 (TD+)
SFP_LEDG: R205.1
SFP_LEDY: R204.1
SFP_MOD_ABS: J12.6 (MOD_{ABS}), R187.2, R197.1, U73.4, U73.7
SH: C169.2, C172.2, C173.2, C174.2, C175.2, C176.2, C177.2, C178.2, C179.2, J19.SH, R200.2

Notes on the sheet:
SFP28
