phuongnamzz/jetson-agx-thor-baseboard/jetson-agx-thor-baseboard_full3D/som_io2.kicad_sch

## KiCad design jetson-agx-thor-baseboard_full3D/som_io2.kicad_sch (2026-10-11)

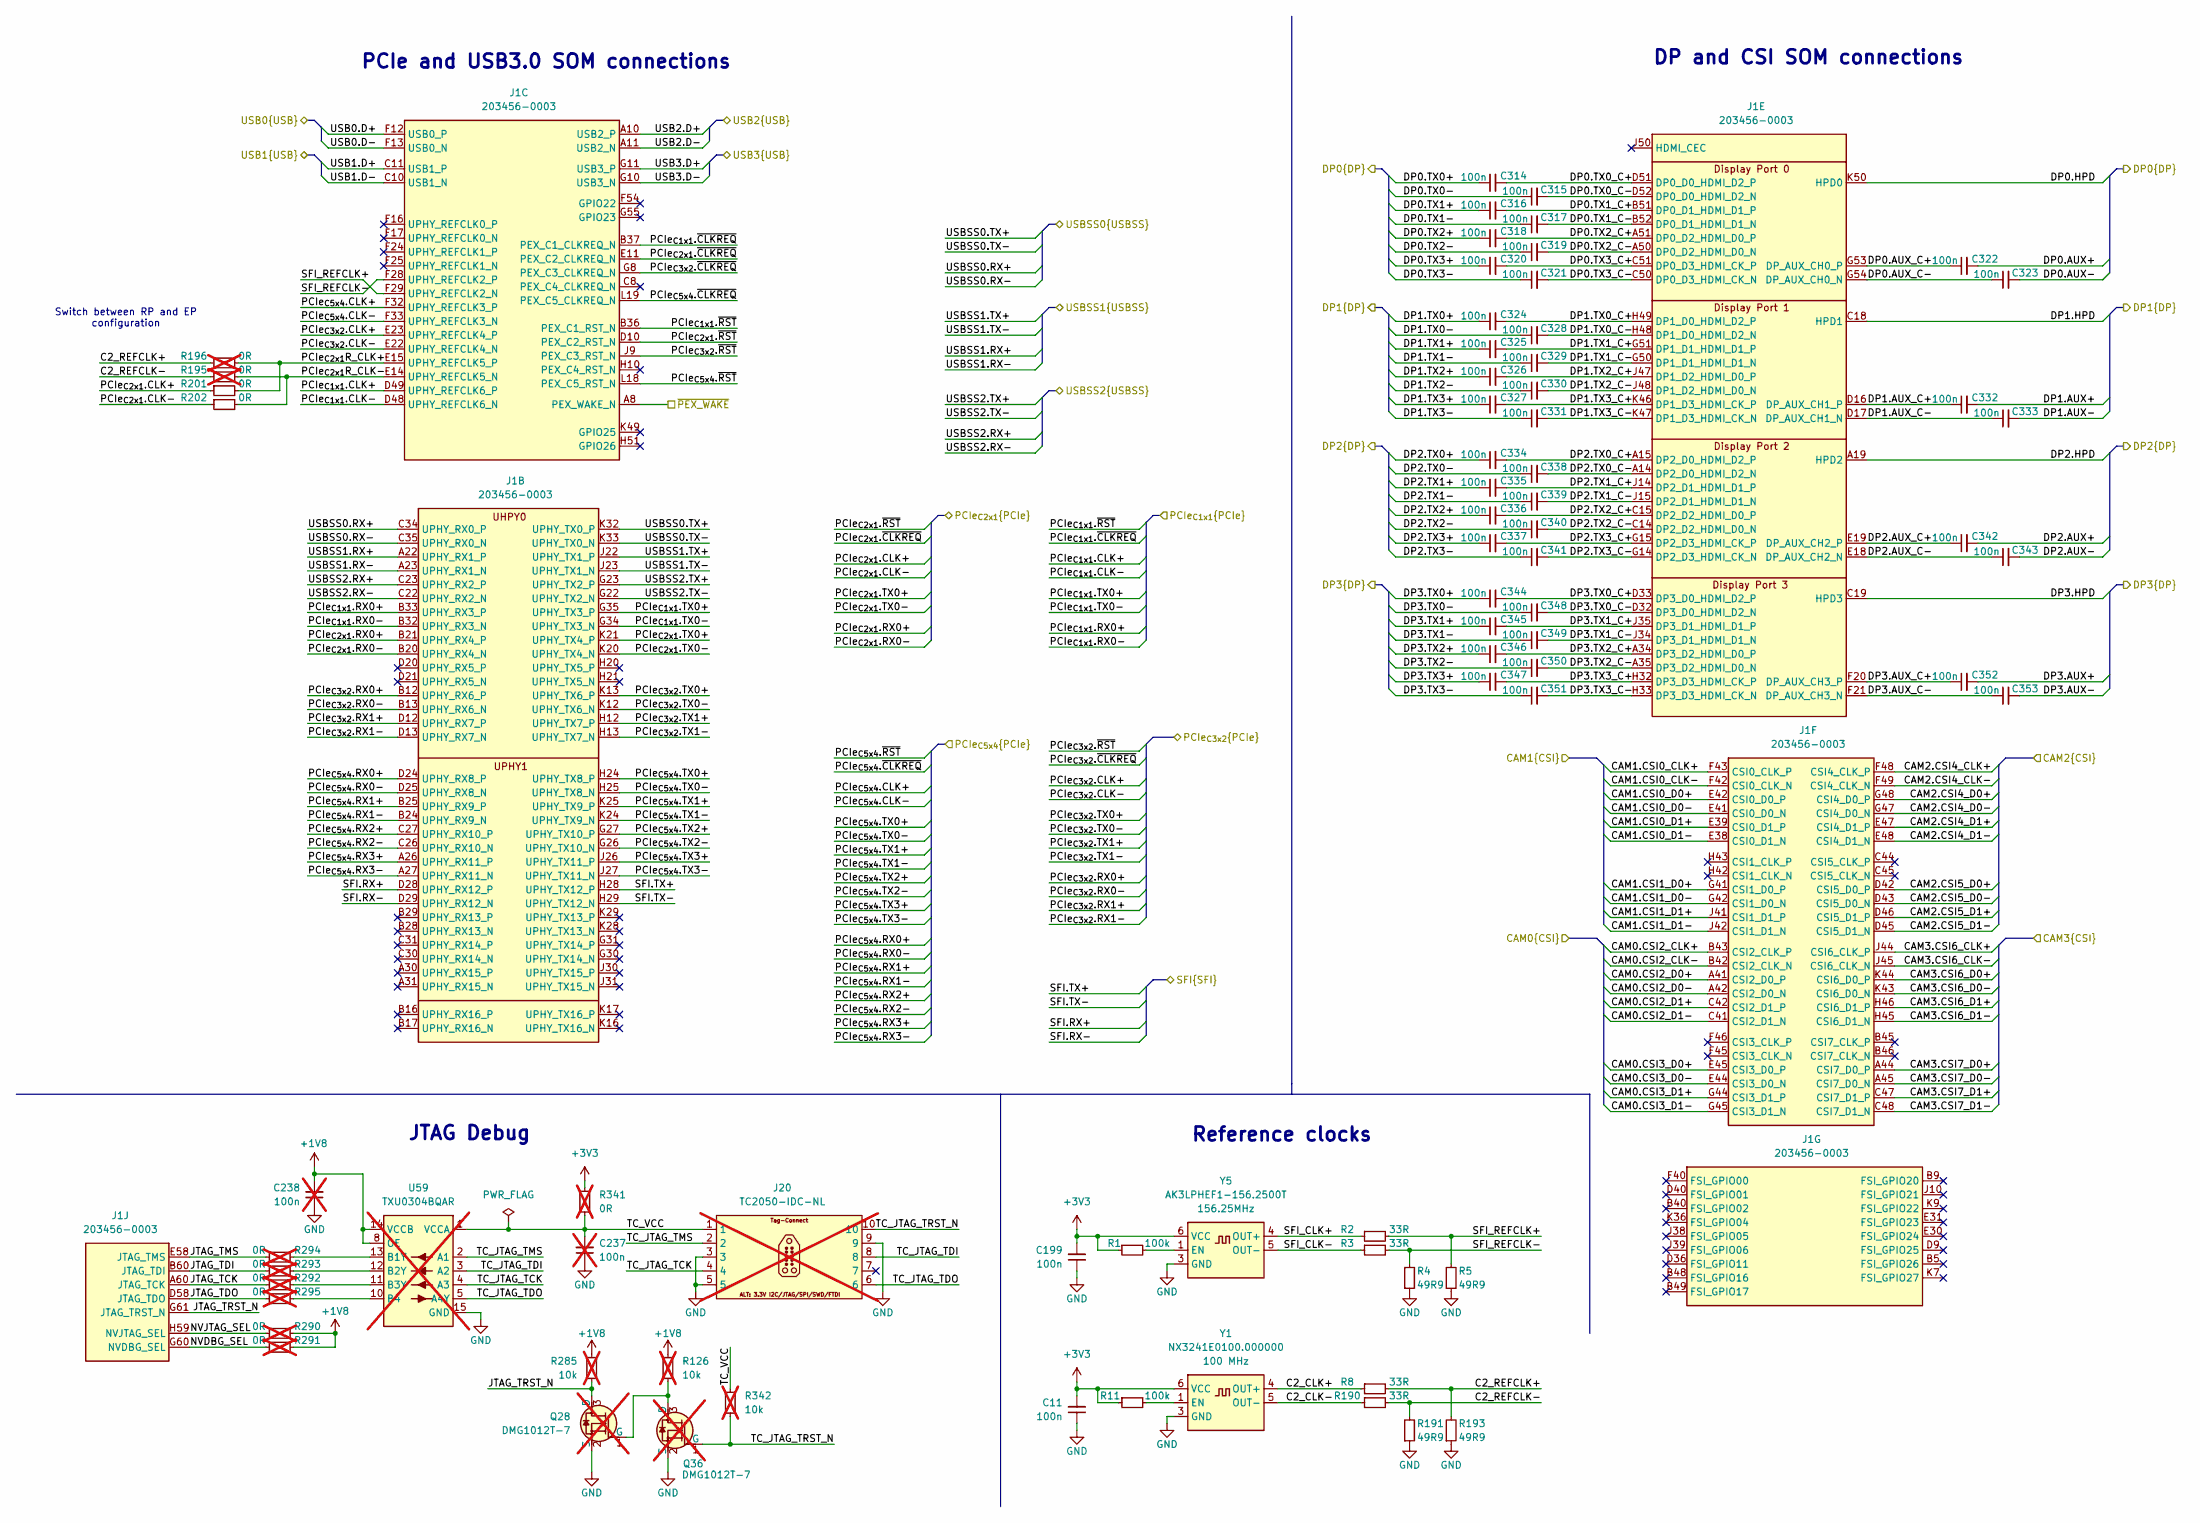
[picture p69: schematic som_io2.kicad_sch]

Parts:
C11, C199, C314, C315, C316, C317, C318, C319, C320, C321, C322, C323, C324, C325, C326, C327, C328, C329, C330, C331, C332, C333, C334, C335, C336, C337, C338, C339, C340, C341, C342, C343, C344, C345, C346, C347, C348, C349, C350, C351, C352, C353: C_100n_0402; C_0402_1005Metric; Voltage 50V; MPN GRM155R61H104KE14D
C237, C238: C_100n_0402; C_0402_1005Metric; Voltage 50V; MPN GRM155R61H104KE14D; not fitted
J1: Hermaphroditic_Molex_203456-0003_CUSTOM_Jetson_AG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; Conn_Hermaphroditic_Molex_203456-0003_mirrored; MPN 203456-0003
J20: Tag-Connect_TC2050-IDC-NL_2x5_P1.27mm; MPN TC2050-IDC-NL; not fitted
Q28, Q36: DMG1012T-7; SOT-523; MPN DMG1012T-7; not fitted
R1, R11: R_100k_0402; R_0402_1005Metric; Tolerance 1%; MPN CR0402-FX-1003GLF
R2, R3, R8, R190: R_33R_0402; R_0402_1005Metric; Tolerance 1%; MPN CR0402-FX-33R0GLF
R4, R5, R191, R193: R_49R9_0402; R_0402_1005Metric; Tolerance 1%; MPN CR0402-FX-49R9GLF
R126, R285, R342: R_10k_0402; R_0402_1005Metric; Tolerance 1%; MPN CR0402-FX-1002GLF; not fitted
R195, R196, R290, R291, R292, R293, R294, R295, R341: R_0R_0402; R_0402_1005Metric; MPN ERJ2GE0R00X; not fitted
R201, R202: R_0R_0402; R_0402_1005Metric; MPN ERJ2GE0R00X
U59: TXU0304BQAR; DHVQFN-14-1EP_2.5x3mm; MPN TXU0304BQAR; not fitted
Y1: Oscillator_100MHz_NX324; Oscillator_SMD_Abracon_AX3_3.2x2.5x1mm; MPN NX3241E0100.000000
Y5: Oscillator_156.25MHz_AK3LPHEF1; Oscillator_SMD_Abracon_AK3LPHEF1_3.2x2.5x1mm; MPN AK3LPHEF1-156.2500T

Connections:
+1V8: C238.2, R126.2, R285.2, R290.1, R291.1, U59.8 (OE), U59.14 (VCCB)
+3V3: C11.2, C199.2, R1.1, R11.1, R341.2, Y1.6 (VCC), Y5.6 (VCC)
C2_CLK+: R8.1, Y1.4 (OUT+)
C2_CLK-: R190.1, Y1.5 (OUT-)
C2_REFCLK+: R8.2, R193.2, R196.1
C2_REFCLK-: R190.2, R191.2, R195.1
CAM0.CSI2_CLK+: J1.B43 (CSI2_CLK_P)
CAM0.CSI2_CLK-: J1.B42 (CSI2_CLK_N)
CAM0.CSI2_D0+: J1.A41 (CSI2_D0_P)
CAM0.CSI2_D0-: J1.A42 (CSI2_D0_N)
CAM0.CSI2_D1+: J1.C42 (CSI2_D1_P)
CAM0.CSI2_D1-: J1.C41 (CSI2_D1_N)
CAM0.CSI3_D0+: J1.E45 (CSI3_D0_P)
CAM0.CSI3_D0-: J1.E44 (CSI3_D0_N)
CAM0.CSI3_D1+: J1.G44 (CSI3_D1_P)
CAM0.CSI3_D1-: J1.G45 (CSI3_D1_N)
CAM1.CSI0_CLK+: J1.F43 (CSI0_CLK_P)
CAM1.CSI0_CLK-: J1.F42 (CSI0_CLK_N)
CAM1.CSI0_D0+: J1.E42 (CSI0_D0_P)
CAM1.CSI0_D0-: J1.E41 (CSI0_D0_N)
CAM1.CSI0_D1+: J1.E39 (CSI0_D1_P)
CAM1.CSI0_D1-: J1.E38 (CSI0_D1_N)
CAM1.CSI1_D0+: J1.G41 (CSI1_D0_P)
CAM1.CSI1_D0-: J1.G42 (CSI1_D0_N)
CAM1.CSI1_D1+: J1.J41 (CSI1_D1_P)
CAM1.CSI1_D1-: J1.J42 (CSI1_D1_N)
CAM2.CSI4_CLK+: J1.F48 (CSI4_CLK_P)
CAM2.CSI4_CLK-: J1.F49 (CSI4_CLK_N)
CAM2.CSI4_D0+: J1.G48 (CSI4_D0_P)
CAM2.CSI4_D0-: J1.G47 (CSI4_D0_N)
CAM2.CSI4_D1+: J1.E47 (CSI4_D1_P)
CAM2.CSI4_D1-: J1.E48 (CSI4_D1_N)
CAM2.CSI5_D0+: J1.D42 (CSI5_D0_P)
CAM2.CSI5_D0-: J1.D43 (CSI5_D0_N)
CAM2.CSI5_D1+: J1.D46 (CSI5_D1_P)
CAM2.CSI5_D1-: J1.D45 (CSI5_D1_N)
CAM3.CSI6_CLK+: J1.J44 (CSI6_CLK_P)
CAM3.CSI6_CLK-: J1.J45 (CSI6_CLK_N)
CAM3.CSI6_D0+: J1.K44 (CSI6_D0_P)
CAM3.CSI6_D0-: J1.K43 (CSI6_D0_N)
CAM3.CSI6_D1+: J1.H46 (CSI6_D1_P)
CAM3.CSI6_D1-: J1.H45 (CSI6_D1_N)
CAM3.CSI7_D0+: J1.A44 (CSI7_D0_P)
CAM3.CSI7_D0-: J1.A45 (CSI7_D0_N)
CAM3.CSI7_D1+: J1.C47 (CSI7_D1_P)
CAM3.CSI7_D1-: J1.C48 (CSI7_D1_N)
DP0.AUX+: C322.2
DP0.AUX-: C323.2
DP0.AUX_C+: C322.1, J1.G53 (DP_AUX_CH0_P)
DP0.AUX_C-: C323.1, J1.G54 (DP_AUX_CH0_N)
DP0.HPD: J1.K50 (HPD0)
DP0.TX0+: C314.1
DP0.TX0-: C315.1
DP0.TX0_C+: C314.2, J1.D51 (DP0_D0_HDMI_D2_P)
DP0.TX0_C-: C315.2, J1.D52 (DP0_D0_HDMI_D2_N)
DP0.TX1+: C316.1
DP0.TX1-: C317.1
DP0.TX1_C+: C316.2, J1.B51 (DP0_D1_HDMI_D1_P)
DP0.TX1_C-: C317.2, J1.B52 (DP0_D1_HDMI_D1_N)
DP0.TX2+: C318.1
DP0.TX2-: C319.1
DP0.TX2_C+: C318.2, J1.A51 (DP0_D2_HDMI_D0_P)
DP0.TX2_C-: C319.2, J1.A50 (DP0_D2_HDMI_D0_N)
DP0.TX3+: C320.1
DP0.TX3-: C321.1
DP0.TX3_C+: C320.2, J1.C51 (DP0_D3_HDMI_CK_P)
DP0.TX3_C-: C321.2, J1.C50 (DP0_D3_HDMI_CK_N)
DP1.AUX+: C332.2
DP1.AUX-: C333.2
DP1.AUX_C+: C332.1, J1.D16 (DP_AUX_CH1_P)
DP1.AUX_C-: C333.1, J1.D17 (DP_AUX_CH1_N)
DP1.HPD: J1.C18 (HPD1)
DP1.TX0+: C324.1
DP1.TX0-: C328.1
DP1.TX0_C+: C324.2, J1.H49 (DP1_D0_HDMI_D2_P)
DP1.TX0_C-: C328.2, J1.H48 (DP1_D0_HDMI_D2_N)
DP1.TX1+: C325.1
DP1.TX1-: C329.1
DP1.TX1_C+: C325.2, J1.G51 (DP1_D1_HDMI_D1_P)
DP1.TX1_C-: C329.2, J1.G50 (DP1_D1_HDMI_D1_N)
DP1.TX2+: C326.1
DP1.TX2-: C330.1
DP1.TX2_C+: C326.2, J1.J47 (DP1_D2_HDMI_D0_P)
DP1.TX2_C-: C330.2, J1.J48 (DP1_D2_HDMI_D0_N)
DP1.TX3+: C327.1
DP1.TX3-: C331.1
DP1.TX3_C+: C327.2, J1.K46 (DP1_D3_HDMI_CK_P)
DP1.TX3_C-: C331.2, J1.K47 (DP1_D3_HDMI_CK_N)
DP2.AUX+: C342.2
DP2.AUX-: C343.2
DP2.AUX_C+: C342.1, J1.E19 (DP_AUX_CH2_P)
DP2.AUX_C-: C343.1, J1.E18 (DP_AUX_CH2_N)
DP2.HPD: J1.A19 (HPD2)
DP2.TX0+: C334.1
DP2.TX0-: C338.1
DP2.TX0_C+: C334.2, J1.A15 (DP2_D0_HDMI_D2_P)
DP2.TX0_C-: C338.2, J1.A14 (DP2_D0_HDMI_D2_N)
DP2.TX1+: C335.1
DP2.TX1-: C339.1
DP2.TX1_C+: C335.2, J1.J14 (DP2_D1_HDMI_D1_P)
DP2.TX1_C-: C339.2, J1.J15 (DP2_D1_HDMI_D1_N)
DP2.TX2+: C336.1
DP2.TX2-: C340.1
DP2.TX2_C+: C336.2, J1.C15 (DP2_D2_HDMI_D0_P)
DP2.TX2_C-: C340.2, J1.C14 (DP2_D2_HDMI_D0_N)
DP2.TX3+: C337.1
DP2.TX3-: C341.1
DP2.TX3_C+: C337.2, J1.G15 (DP2_D3_HDMI_CK_P)
DP2.TX3_C-: C341.2, J1.G14 (DP2_D3_HDMI_CK_N)
DP3.AUX+: C352.2
DP3.AUX-: C353.2
DP3.AUX_C+: C352.1, J1.F20 (DP_AUX_CH3_P)
DP3.AUX_C-: C353.1, J1.F21 (DP_AUX_CH3_N)
DP3.HPD: J1.C19 (HPD3)
DP3.TX0+: C344.1
DP3.TX0-: C348.1
DP3.TX0_C+: C344.2, J1.D33 (DP3_D0_HDMI_D2_P)
DP3.TX0_C-: C348.2, J1.D32 (DP3_D0_HDMI_D2_N)
DP3.TX1+: C345.1
DP3.TX1-: C349.1
DP3.TX1_C+: C345.2, J1.J35 (DP3_D1_HDMI_D1_P)
DP3.TX1_C-: C349.2, J1.J34 (DP3_D1_HDMI_D1_N)
DP3.TX2+: C346.1
DP3.TX2-: C350.1
DP3.TX2_C+: C346.2, J1.A34 (DP3_D2_HDMI_D0_P)
DP3.TX2_C-: C350.2, J1.A35 (DP3_D2_HDMI_D0_N)
DP3.TX3+: C347.1
DP3.TX3-: C351.1
DP3.TX3_C+: C347.2, J1.H32 (DP3_D3_HDMI_CK_P)
DP3.TX3_C-: C351.2, J1.H33 (DP3_D3_HDMI_CK_N)
GND: C11.1, C199.1, C237.1, C238.1, J20.3, J20.5, J20.9, Q28.2 (S), Q36.2 (S), R4.1, R5.1, R191.1, R193.1, U59.7 (GND), U59.15 (GND), Y1.3 (GND), Y5.3 (GND)
JTAG_TCK: J1.A60 (JTAG_TCK), R292.2
JTAG_TDI: J1.B60 (JTAG_TDI), R293.2
JTAG_TDO: J1.D58 (JTAG_TDO), R295.2
JTAG_TMS: J1.E58 (JTAG_TMS), R294.2
JTAG_TRST_N: J1.G61 (JTAG_TRST_N), Q28.3 (D), R285.1
NVDBG_SEL: J1.G60 (NVDBG_SEL), R291.2
NVJTAG_SEL: J1.H59 (NVJTAG_SEL), R290.2
unnamed: Q28.1 (G), Q36.3 (D), R126.1
unnamed: R1.2, Y5.1 (EN)
unnamed: R11.2, Y1.1 (EN)
unnamed: R292.1, U59.11 (B3Y)
unnamed: R293.1, U59.12 (B2Y)
unnamed: R294.1, U59.13 (B1Y)
unnamed: R295.1, U59.10 (B4)
PCIe_{C1x1}.CLK+: J1.D49 (UPHY_REFCLK6_P)
PCIe_{C1x1}.CLK-: J1.D48 (UPHY_REFCLK6_N)
PCIe_{C1x1}.RX0+: J1.B33 (UPHY_RX3_P)
PCIe_{C1x1}.RX0-: J1.B32 (UPHY_RX3_N)
PCIe_{C1x1}.TX0+: J1.G35 (UPHY_TX3_P)
PCIe_{C1x1}.TX0-: J1.G34 (UPHY_TX3_N)
PCIe_{C1x1}.~CLKREQ: J1.B37 (PEX_C1_CLKREQ_N)
PCIe_{C1x1}.~RST: J1.B36 (PEX_C1_RST_N)
PCIe_{C2x1}.CLK+: R201.1
PCIe_{C2x1}.CLK-: R202.1
PCIe_{C2x1}.RX0+: J1.B21 (UPHY_RX4_P)
PCIe_{C2x1}.RX0-: J1.B20 (UPHY_RX4_N)
PCIe_{C2x1}.TX0+: J1.K21 (UPHY_TX4_P)
PCIe_{C2x1}.TX0-: J1.K20 (UPHY_TX4_N)
PCIe_{C2x1}.~CLKREQ: J1.E11 (PEX_C2_CLKREQ_N)
PCIe_{C2x1}.~RST: J1.D10 (PEX_C2_RST_N)
PCIe_{C2x1}R_CLK+: J1.E15 (UPHY_REFCLK5_P), R196.2, R201.2
PCIe_{C2x1}R_CLK-: J1.E14 (UPHY_REFCLK5_N), R195.2, R202.2
PCIe_{C3x2}.CLK+: J1.E23 (UPHY_REFCLK4_P)
PCIe_{C3x2}.CLK-: J1.E22 (UPHY_REFCLK4_N)
PCIe_{C3x2}.RX0+: J1.B12 (UPHY_RX6_P)
PCIe_{C3x2}.RX0-: J1.B13 (UPHY_RX6_N)
PCIe_{C3x2}.RX1+: J1.D12 (UPHY_RX7_P)
PCIe_{C3x2}.RX1-: J1.D13 (UPHY_RX7_N)
PCIe_{C3x2}.TX0+: J1.K13 (UPHY_TX6_P)
PCIe_{C3x2}.TX0-: J1.K12 (UPHY_TX6_N)
PCIe_{C3x2}.TX1+: J1.H12 (UPHY_TX7_P)
PCIe_{C3x2}.TX1-: J1.H13 (UPHY_TX7_N)
PCIe_{C3x2}.~CLKREQ: J1.G8 (PEX_C3_CLKREQ_N)
PCIe_{C3x2}.~RST: J1.J9 (PEX_C3_RST_N)
PCIe_{C5x4}.CLK+: J1.F32 (UPHY_REFCLK3_P)
PCIe_{C5x4}.CLK-: J1.F33 (UPHY_REFCLK3_N)
PCIe_{C5x4}.RX0+: J1.D24 (UPHY_RX8_P)
PCIe_{C5x4}.RX0-: J1.D25 (UPHY_RX8_N)
PCIe_{C5x4}.RX1+: J1.B25 (UPHY_RX9_P)
PCIe_{C5x4}.RX1-: J1.B24 (UPHY_RX9_N)
PCIe_{C5x4}.RX2+: J1.C27 (UPHY_RX10_P)
PCIe_{C5x4}.RX2-: J1.C26 (UPHY_RX10_N)
PCIe_{C5x4}.RX3+: J1.A26 (UPHY_RX11_P)
PCIe_{C5x4}.RX3-: J1.A27 (UPHY_RX11_N)
PCIe_{C5x4}.TX0+: J1.H24 (UPHY_TX8_P)
PCIe_{C5x4}.TX0-: J1.H25 (UPHY_TX8_N)
PCIe_{C5x4}.TX1+: J1.K25 (UPHY_TX9_P)
PCIe_{C5x4}.TX1-: J1.K24 (UPHY_TX9_N)
PCIe_{C5x4}.TX2+: J1.G27 (UPHY_TX10_P)
PCIe_{C5x4}.TX2-: J1.G26 (UPHY_TX10_N)
PCIe_{C5x4}.TX3+: J1.J26 (UPHY_TX11_P)
PCIe_{C5x4}.TX3-: J1.J27 (UPHY_TX11_N)
PCIe_{C5x4}.~CLKREQ: J1.L19 (PEX_C5_CLKREQ_N)
PCIe_{C5x4}.~RST: J1.L18 (PEX_C5_RST_N)
SFI.RX+: J1.D28 (UPHY_RX12_P)
SFI.RX-: J1.D29 (UPHY_RX12_N)
SFI.TX+: J1.H28 (UPHY_TX12_P)
SFI.TX-: J1.H29 (UPHY_TX12_N)
SFI_CLK+: R2.1, Y5.4 (OUT+)
SFI_CLK-: R3.1, Y5.5 (OUT-)
SFI_REFCLK+: J1.F29 (UPHY_REFCLK2_N), R2.2, R5.2
SFI_REFCLK-: J1.F28 (UPHY_REFCLK2_P), R3.2, R4.2
TC_JTAG_TCK: J20.4, U59.4 (A3)
TC_JTAG_TDI: J20.8, U59.3 (A2)
TC_JTAG_TDO: J20.6, U59.5 (A4Y)
TC_JTAG_TMS: J20.2, U59.2 (A1)
TC_JTAG_TRST_N: J20.10, Q36.1 (G), R342.1
TC_VCC: C237.2, J20.1, R341.1, R342.2, U59.1 (VCCA)
USB0.D+: J1.F12 (USB0_P)
USB0.D-: J1.F13 (USB0_N)
USB1.D+: J1.C11 (USB1_P)
USB1.D-: J1.C10 (USB1_N)
USB2.D+: J1.A10 (USB2_P)
USB2.D-: J1.A11 (USB2_N)
USB3.D+: J1.G11 (USB3_P)
USB3.D-: J1.G10 (USB3_N)
USBSS0.RX+: J1.C34 (UPHY_RX0_P)
USBSS0.RX-: J1.C35 (UPHY_RX0_N)
USBSS0.TX+: J1.K32 (UPHY_TX0_P)
USBSS0.TX-: J1.K33 (UPHY_TX0_N)
USBSS1.RX+: J1.A22 (UPHY_RX1_P)
USBSS1.RX-: J1.A23 (UPHY_RX1_N)
USBSS1.TX+: J1.J22 (UPHY_TX1_P)
USBSS1.TX-: J1.J23 (UPHY_TX1_N)
USBSS2.RX+: J1.C23 (UPHY_RX2_P)
USBSS2.RX-: J1.C22 (UPHY_RX2_N)
USBSS2.TX+: J1.G23 (UPHY_TX2_P)
USBSS2.TX-: J1.G22 (UPHY_TX2_N)
~PEX_WAKE: J1.A8 (PEX_WAKE_N)

Notes on the sheet:
Switch between RP and EP configuration
DP and CSI SOM connections
Reference clocks
PCIe and USB3.0 SOM connections
JTAG Debug
