phuongnamzz/jetson-agx-thor-baseboard/jetson-agx-thor-baseboard_full3D/som_io.kicad_sch

## KiCad design jetson-agx-thor-baseboard_full3D/som_io.kicad_sch (2026-10-11)

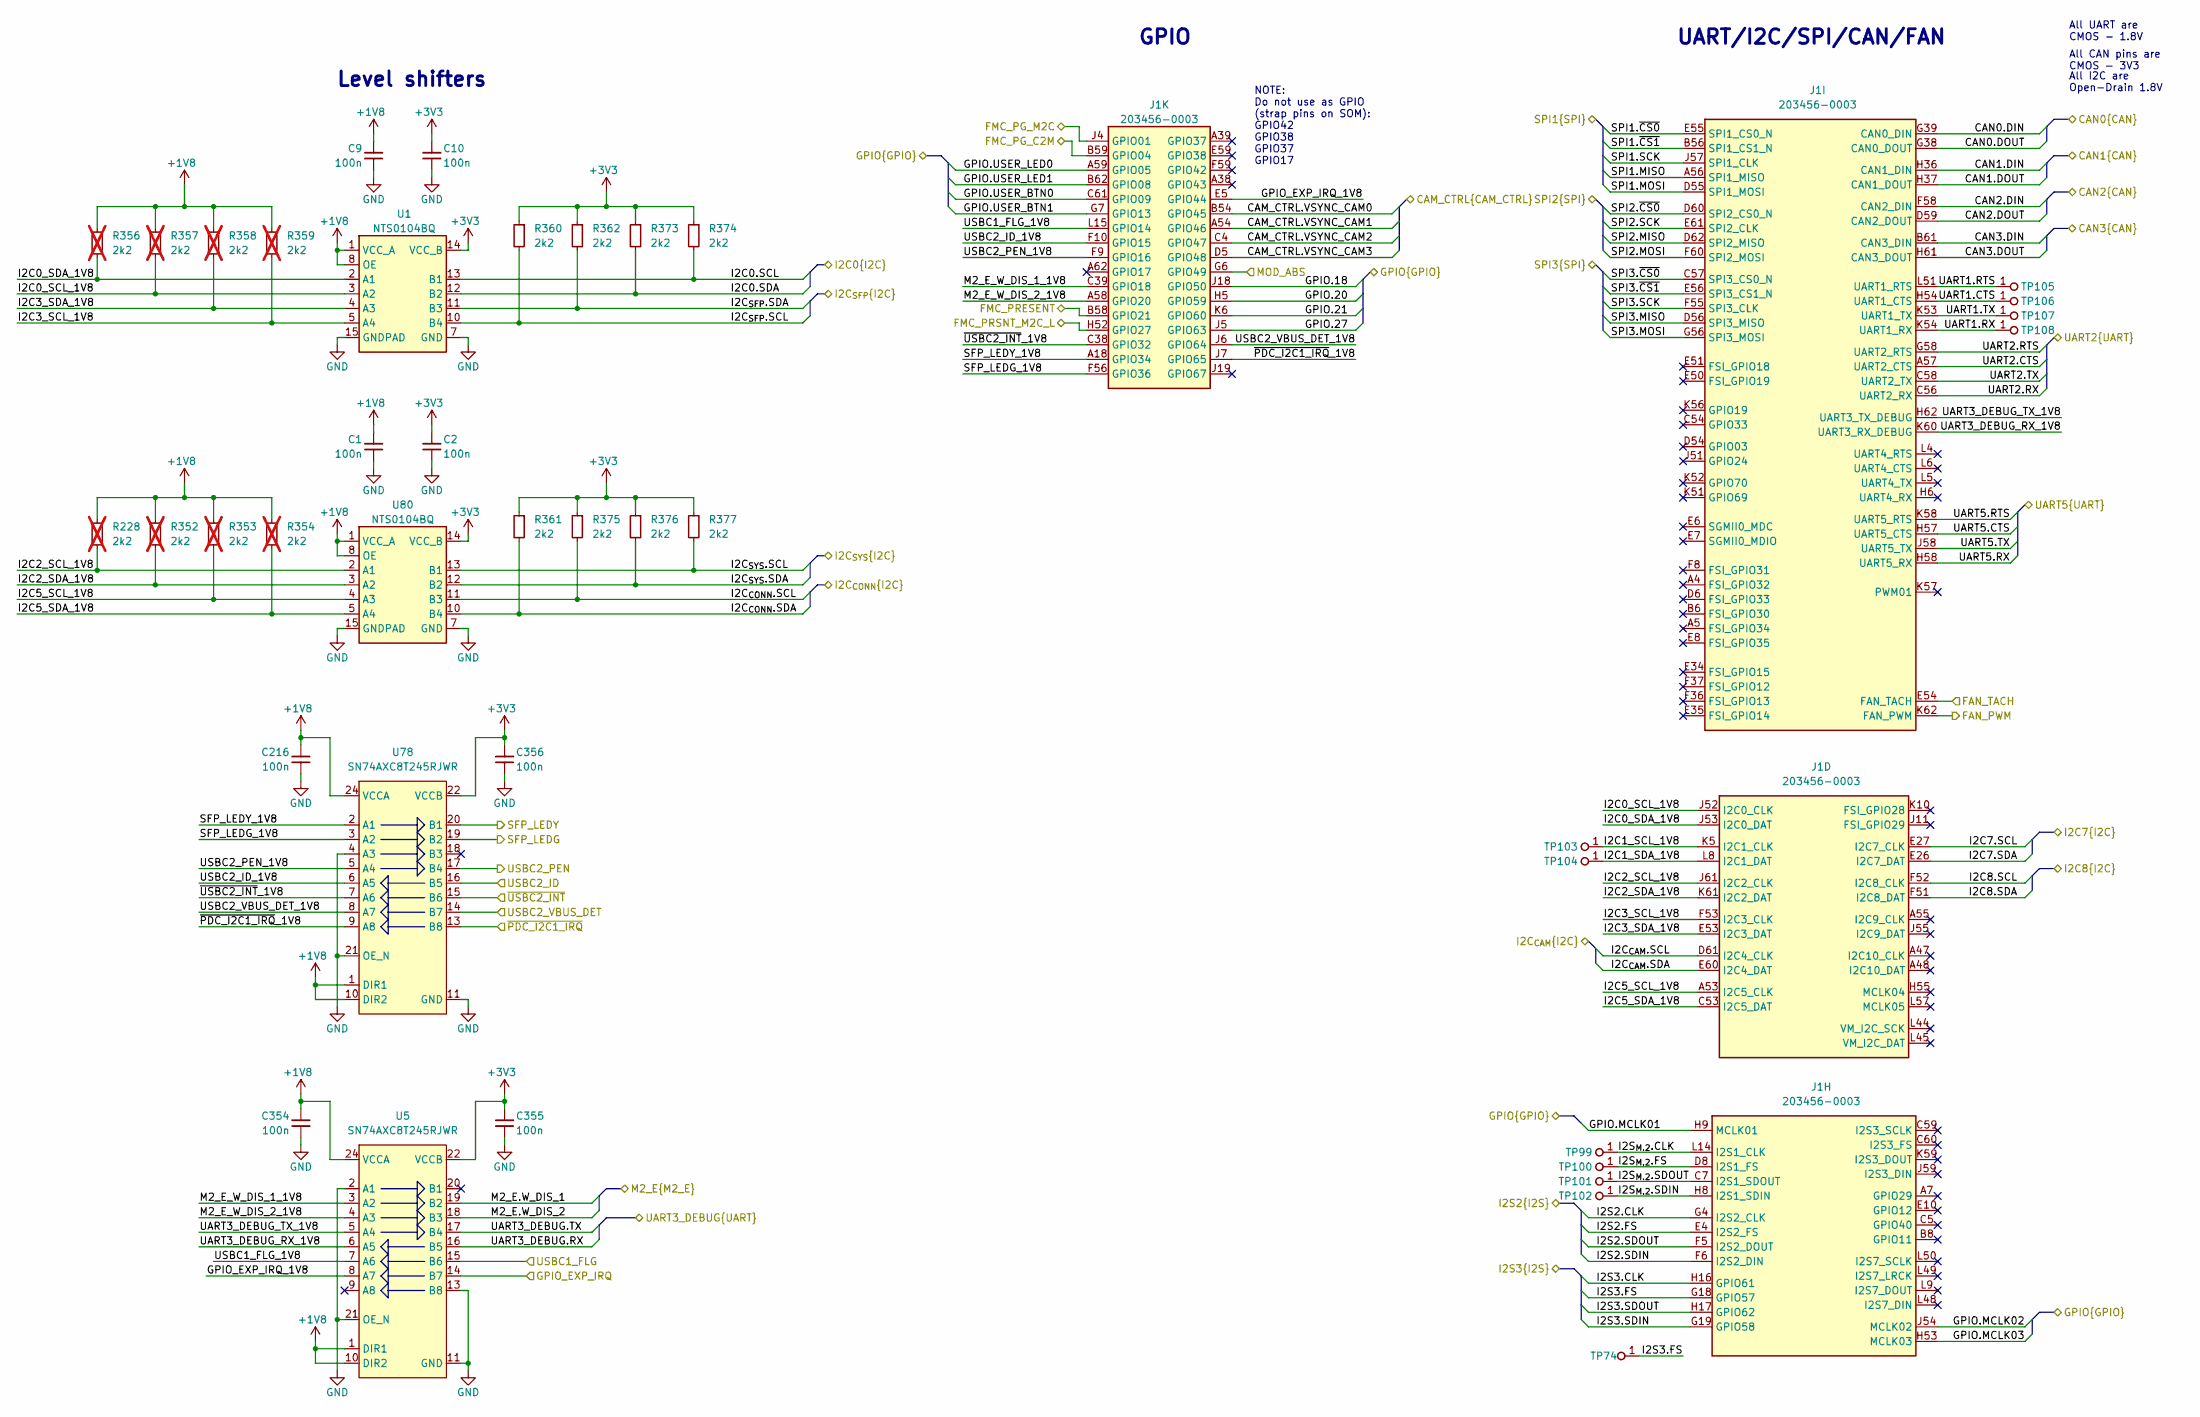
[picture p70: schematic som_io.kicad_sch]

Parts:
C1, C2, C9, C10, C216, C354, C355, C356: C_100n_0402; C_0402_1005Metric; Voltage 50V; MPN GRM155R61H104KE14D
J1: Hermaphroditic_Molex_203456-0003_CUSTOM_Jetson_AG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; Conn_Hermaphroditic_Molex_203456-0003_mirrored; MPN 203456-0003
R228, R352, R353, R354, R356, R357, R358, R359: R_2k2_0402; R_0402_1005Metric; Tolerance 1%; MPN CR0402-FX-2201GLF; not fitted
R360, R361, R362, R373, R374, R375, R376, R377: R_2k2_0402; R_0402_1005Metric; Tolerance 1%; MPN CR0402-FX-2201GLF
TP74, TP99, TP100, TP101, TP102, TP103, TP104, TP105, TP106, TP107, TP108: TP_0.75mm_SMD; TP_SMD_0.75mm
U1, U80: NTS0104_DHVQFN; DHVQFN-14-1EP_2.5x3mm; MPN NTS0104BQ
U5, U78: SN74AXC8T245_UQFN; UQFN-24_2x4mm_P0.4mm_Texas_RJW0024A; MPN SN74AXC8T245RJWR

Connections:
+1V8: C1.2, C9.2, C216.2, C354.2, R228.1, R352.1, R353.1, R354.1, R356.1, R357.1, R358.1, R359.1, U1.1 (VCC_A), U1.8 (OE), U5.1 (DIR1), U5.10 (DIR2), U5.24 (VCCA), U78.1 (DIR1), U78.10 (DIR2), U78.24 (VCCA), U80.1 (VCC_A), U80.8 (OE)
+3V3: C2.2, C10.2, C355.2, C356.2, R360.1, R361.1, R362.1, R373.1, R374.1, R375.1, R376.1, R377.1, U1.14 (VCC_B), U5.22 (VCCB), U5.23 (VCCB), U78.22 (VCCB), U78.23 (VCCB), U80.14 (VCC_B)
CAM_CTRL.VSYNC_CAM0: J1.B54 (GPIO45)
CAM_CTRL.VSYNC_CAM1: J1.A54 (GPIO46)
CAM_CTRL.VSYNC_CAM2: J1.C4 (GPIO47)
CAM_CTRL.VSYNC_CAM3: J1.D5 (GPIO48)
CAN0.DIN: J1.G39 (FSI_GPIO08)
CAN0.DOUT: J1.G38 (FSI_GPIO07)
CAN1.DIN: J1.H36 (FSI_GPIO10)
CAN1.DOUT: J1.H37 (FSI_GPIO09)
CAN2.DIN: J1.F58 (CAN2_DIN)
CAN2.DOUT: J1.D59 (CAN2_DOUT)
CAN3.DIN: J1.B61 (CAN3_DIN)
CAN3.DOUT: J1.H61 (CAN3_DOUT)
FAN_PWM: J1.K62 (FAN_PWM)
FAN_TACH: J1.E54 (FAN_TACH)
FMC_PG_C2M: J1.B59 (GPIO04)
FMC_PG_M2C: J1.J4 (GPIO01)
FMC_PRESENT: J1.B58 (GPIO21)
FMC_PRSNT_M2C_L: J1.H52 (GPIO27)
GND: C1.1, C2.1, C9.1, C10.1, C216.1, C354.1, C355.1, C356.1, U1.7 (GND), U1.15 (GNDPAD), U5.2 (A1), U5.11 (GND), U5.12 (GND), U5.13 (B8), U5.21 (OE_N), U78.4 (A3), U78.11 (GND), U78.12 (GND), U78.21 (OE_N), U80.7 (GND), U80.15 (GNDPAD)
GPIO.18: J1.J18 (GPIO50)
GPIO.20: J1.H5 (GPIO59)
GPIO.21: J1.K6 (GPIO60)
GPIO.27: J1.J5 (GPIO63)
GPIO.MCLK01: J1.H9 (MCLK01)
GPIO.MCLK02: J1.J54 (MCLK02)
GPIO.MCLK03: J1.H53 (MCLK03)
GPIO.USER_BTN0: J1.C61 (GPIO09)
GPIO.USER_BTN1: J1.G7 (GPIO13)
GPIO.USER_LED0: J1.A59 (GPIO05)
GPIO.USER_LED1: J1.B62 (GPIO08)
GPIO_EXP_IRQ: U5.14 (B7)
GPIO_EXP_IRQ_1V8: J1.E5 (GPIO44), U5.8 (A7)
I2C0.SCL: R374.2, U1.13 (B1)
I2C0.SDA: R373.2, U1.12 (B2)
I2C0_SCL_1V8: J1.J52 (I2C0_CLK), R357.2, U1.3 (A2)
I2C0_SDA_1V8: J1.J53 (I2C0_DAT), R356.2, U1.2 (A1)
I2C1_SCL_1V8: J1.K5 (I2C1_CLK), TP103.1
I2C1_SDA_1V8: J1.L8 (I2C1_DAT), TP104.1
I2C2_SCL_1V8: J1.J61 (I2C2_CLK), R228.2, U80.2 (A1)
I2C2_SDA_1V8: J1.K61 (I2C2_DAT), R352.2, U80.3 (A2)
I2C3_SCL_1V8: J1.F53 (I2C3_CLK), R359.2, U1.5 (A4)
I2C3_SDA_1V8: J1.E53 (I2C3_DAT), R358.2, U1.4 (A3)
I2C5_SCL_1V8: J1.A53 (I2C5_CLK), R353.2, U80.4 (A3)
I2C5_SDA_1V8: J1.C53 (I2C5_DAT), R354.2, U80.5 (A4)
I2C7.SCL: J1.E27 (I2C7_CLK)
I2C7.SDA: J1.E26 (I2C7_DAT)
I2C8.SCL: J1.F52 (I2C8_CLK)
I2C8.SDA: J1.F51 (I2C8_DAT)
I2C_{CAM}.SCL: J1.D61 (I2C4_CLK)
I2C_{CAM}.SDA: J1.E60 (I2C4_DAT)
I2C_{CONN}.SCL: R375.2, U80.11 (B3)
I2C_{CONN}.SDA: R361.2, U80.10 (B4)
I2C_{SFP}.SCL: R360.2, U1.10 (B4)
I2C_{SFP}.SDA: R362.2, U1.11 (B3)
I2C_{SYS}.SCL: R377.2, U80.13 (B1)
I2C_{SYS}.SDA: R376.2, U80.12 (B2)
I2S2.CLK: J1.G4 (I2S2_CLK)
I2S2.FS: J1.E4 (I2S2_FS)
I2S2.SDIN: J1.F6 (I2S2_DIN)
I2S2.SDOUT: J1.F5 (I2S2_DOUT)
I2S3.CLK: J1.H16 (GPIO61)
I2S3.FS: J1.G18 (GPIO57), TP74.1
I2S3.SDIN: J1.G19 (GPIO58)
I2S3.SDOUT: J1.H17 (GPIO62)
I2S_{M.2}.CLK: J1.L14 (I2S1_CLK), TP99.1
I2S_{M.2}.FS: J1.D8 (I2S1_FS), TP100.1
I2S_{M.2}.SDIN: J1.H8 (I2S1_SDIN), TP102.1
I2S_{M.2}.SDOUT: J1.C7 (I2S1_SDOUT), TP101.1
M2_E.W_DIS_1: U5.19 (B2)
M2_E.W_DIS_2: U5.18 (B3)
M2_E_W_DIS_1_1V8: J1.C39 (GPIO18), U5.3 (A2)
M2_E_W_DIS_2_1V8: J1.A58 (GPIO20), U5.4 (A3)
MOD_ABS: J1.G6 (GPIO49)
SFP_LEDG: U78.19 (B2)
SFP_LEDG_1V8: J1.F56 (GPIO36), U78.3 (A2)
SFP_LEDY: U78.20 (B1)
SFP_LEDY_1V8: J1.A18 (GPIO34), U78.2 (A1)
SPI1.MISO: J1.A56 (SPI1_MISO)
SPI1.MOSI: J1.D55 (SPI1_MOSI)
SPI1.SCK: J1.J57 (SPI1_CLK)
SPI1.~CS0: J1.E55 (SPI1_CS0_N)
SPI1.~CS1: J1.B56 (SPI1_CS1_N)
SPI2.MISO: J1.D62 (SPI2_MISO)
SPI2.MOSI: J1.F60 (SPI2_MOSI)
SPI2.SCK: J1.E61 (SPI2_CLK)
SPI2.~CS0: J1.D60 (SPI2_CS0_N)
SPI3.MISO: J1.D56 (SPI3_MISO)
SPI3.MOSI: J1.G56 (SPI3_MOSI)
SPI3.SCK: J1.F55 (SPI3_CLK)
SPI3.~CS0: J1.C57 (SPI3_CS0_N)
SPI3.~CS1: J1.E56 (SPI3_CS1_N)
UART1.CTS: J1.H54 (UART1_CTS), TP106.1
UART1.RTS: J1.L51 (UART1_RTS), TP105.1
UART1.RX: J1.K54 (UART1_RX), TP108.1
UART1.TX: J1.K53 (UART1_TX), TP107.1
UART2.CTS: J1.A57 (UART2_CTS)
UART2.RTS: J1.G58 (UART2_RTS)
UART2.RX: J1.C56 (UART2_RX)
UART2.TX: J1.C58 (UART2_TX)
UART3_DEBUG.RX: U5.16 (B5)
UART3_DEBUG.TX: U5.17 (B4)
UART3_DEBUG_RX_1V8: J1.K60 (UART3_RX_DEBUG), U5.6 (A5)
UART3_DEBUG_TX_1V8: J1.H62 (UART3_TX_DEBUG), U5.5 (A4)
UART5.CTS: J1.H57 (UART5_CTS)
UART5.RTS: J1.K58 (UART5_RTS)
UART5.RX: J1.H58 (UART5_RX)
UART5.TX: J1.J58 (UART5_TX)
USBC1_FLG: U5.15 (B6)
USBC1_FLG_1V8: J1.L15 (GPIO14), U5.7 (A6)
USBC2_ID: U78.16 (B5)
USBC2_ID_1V8: J1.F10 (GPIO15), U78.6 (A5)
USBC2_PEN: U78.17 (B4)
USBC2_PEN_1V8: J1.F9 (GPIO16), U78.5 (A4)
USBC2_VBUS_DET: U78.14 (B7)
USBC2_VBUS_DET_1V8: J1.J6 (GPIO64), U78.8 (A7)
~PDC_I2C1_IRQ: U78.13 (B8)
~PDC_I2C1_IRQ_1V8: J1.J7 (GPIO65), U78.9 (A8)
~USBC2_INT: U78.15 (B6)
~USBC2_INT_1V8: J1.C38 (GPIO32), U78.7 (A6)

Notes on the sheet:
NOTE: Do not use as GPIO (strap pins on SOM): GPIO42 GPIO38 GPIO37 GPIO17
All I2C are Open-Drain 1.8V
All UART are CMOS - 1.8V
All CAN pins are CMOS - 3V3
Level shifters
GPIO
UART/I2C/SPI/CAN/FAN
