phuongnamzz/jetson-agx-thor-baseboard/jetson-agx-thor-baseboard_full3D/som_power.kicad_sch

## KiCad design jetson-agx-thor-baseboard_full3D/som_power.kicad_sch (2026-10-11)

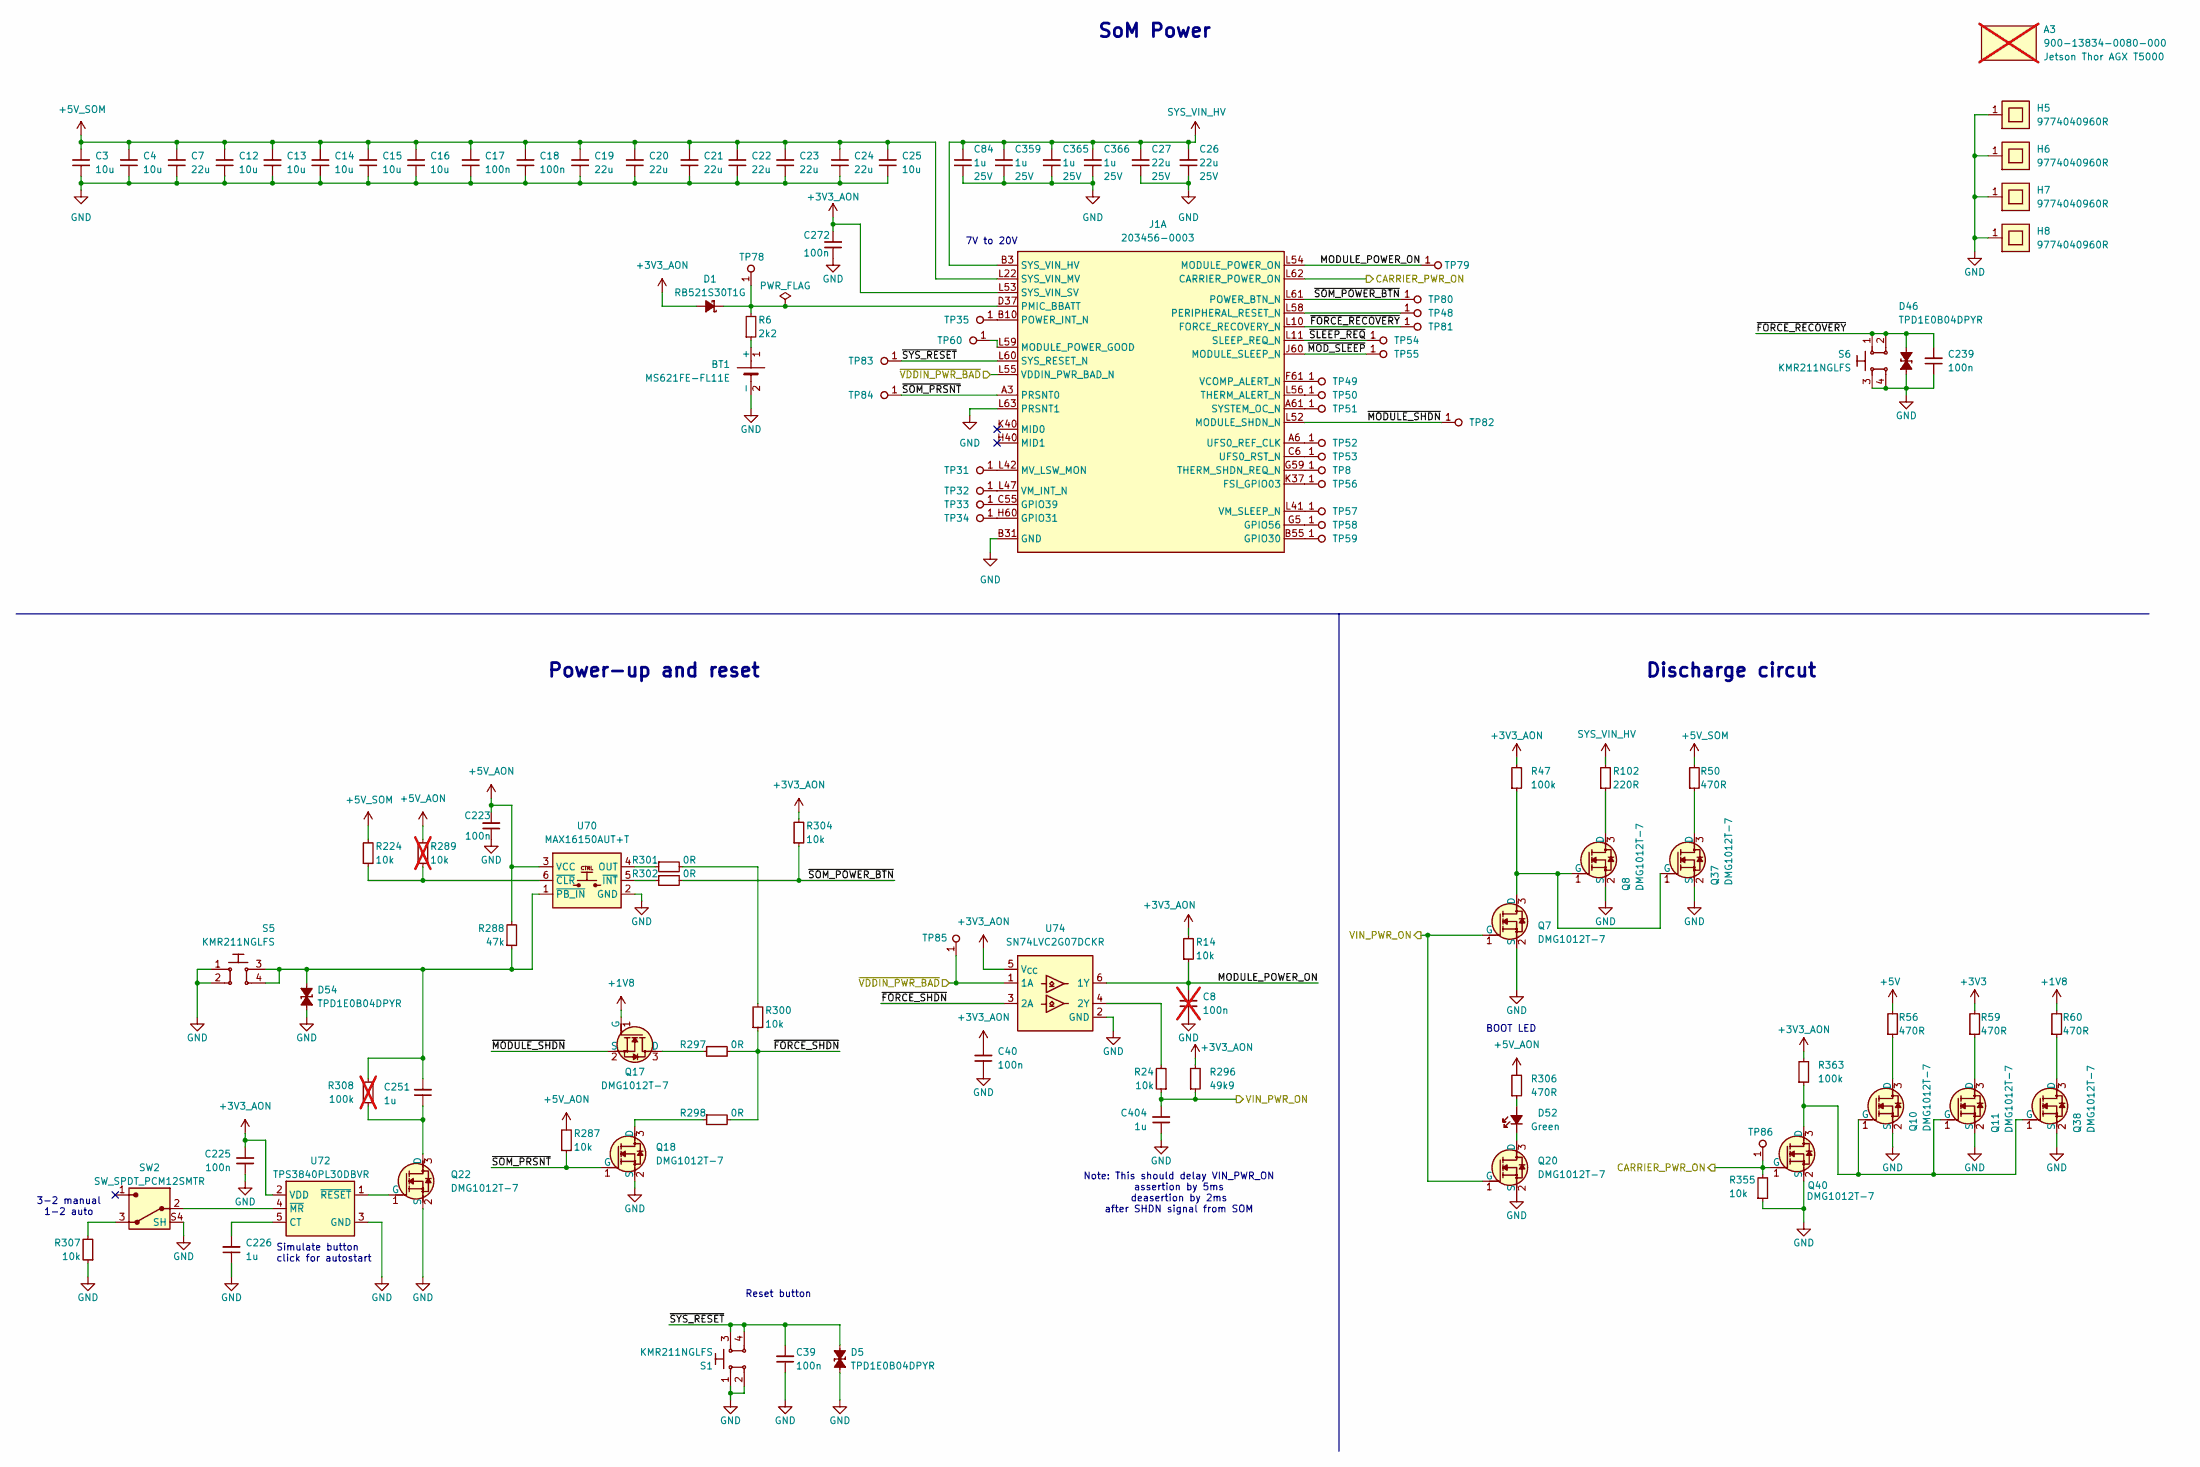
[picture p71: schematic som_power.kicad_sch]

Parts:
A3: Jetson-Thor-AGX-T5000; Module_Jetson-Thor-AGX-T5000; MPN 900-13834-0080-000; not fitted
BT1: Battery_Holder_MS621FE-FL11E; MS621FE-FL11E; MPN MS621FE-FL11E
C3, C4, C12, C13, C14, C15, C16, C25: C_10u_0402; C_0402_1005Metric; MPN CC0402MRX5R5BB106
C7, C19, C20, C21, C22, C23, C24: C_22u_16V_0603; C_0603_1608Metric_EIA; Voltage 16V; MPN CL10A226MO7JZNC
C8: C_100n_0402; C_0402_1005Metric; Voltage 50V; MPN GRM155R61H104KE14D; not fitted
C17, C18, C39, C40, C223, C225, C239, C272: C_100n_0402; C_0402_1005Metric; Voltage 50V; MPN GRM155R61H104KE14D
C26, C27: C_22u_25V_0805; C_0805_2012Metric; Voltage 25V; MPN CL21A226MAYNNNE
C84, C226, C251, C359, C365, C366, C404: C_1u_25V_0402; C_0402_1005Metric; Voltage 25V; MPN GRM155R61E105KE11J
D1: RB521S30T1G; SOD-523; MPN RB521S30T1G
D5, D46, D54: TPD1E0B04_XDFN-2; XDFN-2_1x0.60mm; MPN TPD1E0B04DPYR
D52: LED_G_0603_LTST-C190GKT; LED_0603_1608Metric_G; MPN LTST-C190GKT
H5, H6, H7, H8: Spacer_Drill4.45mm_H4mm_9774040960R; MPN 9774040960R
J1: Hermaphroditic_Molex_203456-0003_CUSTOM_Jetson_AG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; Conn_Hermaphroditic_Molex_203456-0003_mirrored; MPN 203456-0003
Q7, Q8, Q10, Q11, Q17, Q18, Q20, Q22, Q37, Q38, Q40: DMG1012T-7; SOT-523; MPN DMG1012T-7
R6: R_2k2_0402; R_0402_1005Metric; Tolerance 1%; MPN CR0402-FX-2201GLF
R14, R24, R224, R287, R300, R304, R307, R355: R_10k_0402; R_0402_1005Metric; Tolerance 1%; MPN CR0402-FX-1002GLF
R47, R363: R_100k_0402; R_0402_1005Metric; Tolerance 1%; MPN CR0402-FX-1003GLF
R50, R56, R59, R60, R306: R_470R_0402; R_0402_1005Metric; Tolerance 1%; MPN CR0402-FX-4700GLF
R102: R_220R_1206; R_1206_3216Metric; Tolerance 1%; MPN CR1206-FX-2200ELF
R288: R_47k_0402; R_0402_1005Metric; Tolerance 1%; MPN CR0402-FX-4702GLF
R289: R_10k_0402; R_0402_1005Metric; Tolerance 1%; MPN CR0402-FX-1002GLF; not fitted
R296: R_49k9_0402; R_0402_1005Metric; Tolerance 1%; MPN CR0402-FX-4992GLF
R297, R298, R301, R302: R_0R_0402; R_0402_1005Metric; MPN ERJ2GE0R00X
R308: R_100k_0402; R_0402_1005Metric; Tolerance 1%; MPN CR0402-FX-1003GLF; not fitted
S1, S5, S6: SW_KMR211NGLFS_SMD; MPN KMR211NGLFS
SW2: SW_SPDT_PCM12SMTR; PCM12SMTR; MPN PCM12SMTR
TP8, TP31, TP32, TP33, TP34, TP35, TP48, TP49, TP50, TP51, TP52, TP53, TP54, TP55, TP56, TP57, TP58, TP59, TP60, TP78, TP79, TP80, TP81, TP82, TP83, TP84, TP85, TP86: TP_0.75mm_SMD; TP_SMD_0.75mm
U70: MAX16150A_SOT; SOT-23-6; MPN MAX16150AUT+T
U72: TPS3840PL30DBVR; SOT-23-5; MPN TPS3840PL30DBVR
U74: SN74LVC2G07DCKR; SC-70-6; MPN SN74LVC2G07DCKR

Connections:
+1V8: Q17.1 (G), R60.2
+3V3: R59.2
+3V3_AON: C40.2, C225.2, C272.2, D1.2 (A), J1.L53 (SYS_VIN_SV), R14.2, R47.2, R296.2, R304.2, R363.2, U72.2 (VDD), U74.5 (V_{CC})
+5V: R56.2
+5V_AON: C223.2, R287.2, R288.2, R289.2, R306.2, U70.3 (VCC)
+5V_SOM: C3.2, C4.2, C7.2, C12.2, C13.2, C14.2, C15.2, C16.2, C17.2, C18.2, C19.2, C20.2, C21.2, C22.2, C23.2, C24.2, C25.2, J1.L22 (SYS_VIN_MV), J1.L23 (SYS_VIN_MV), J1.L26 (SYS_VIN_MV), J1.L27 (SYS_VIN_MV), J1.L30 (SYS_VIN_MV), J1.L31 (SYS_VIN_MV), J1.L34 (SYS_VIN_MV), J1.L35 (SYS_VIN_MV), J1.L38 (SYS_VIN_MV), J1.L39 (SYS_VIN_MV), R50.2, R224.2
CARRIER_PWR_ON: J1.L62 (CARRIER_POWER_ON), Q40.1 (G), R355.2, TP86.1
GND: BT1.2 (-), C3.1, C4.1, C7.1, C8.1, C12.1, C13.1, C14.1, C15.1, C16.1, C17.1, C18.1, C19.1, C20.1, C21.1, C22.1, C23.1, C24.1, C25.1, C26.1, C27.1, C39.1, C40.1, C84.1, C223.1, C225.1, C226.1, C239.1, C272.1, C359.1, C365.1, C366.1, C404.1, D5.1 (C), D46.1 (C), D54.1 (C), H5.1, H6.1, H7.1, H8.1, J1.A9 (GND), J1.A12 (GND), J1.A13 (GND), J1.A16 (GND), J1.A17 (GND), J1.A20 (GND), J1.A21 (GND), J1.A24 (GND), J1.A25 (GND), J1.A28 (GND), J1.A29 (GND), J1.A32 (GND), J1.A33 (GND), J1.A36 (GND), J1.A37 (GND), J1.A40 (GND), J1.A43 (GND), J1.A46 (GND), J1.A49 (GND), J1.A52 (GND), J1.A63 (GND), J1.B4 (GND), J1.B7 (GND), J1.B11 (GND), J1.B14 (GND), J1.B15 (GND), J1.B18 (GND), J1.B19 (GND), J1.B22 (GND), J1.B23 (GND), J1.B26 (GND), J1.B27 (GND), J1.B30 (GND), J1.B31 (GND), J1.B34 (GND), J1.B35 (GND), J1.B38 (GND), J1.B39 (GND), J1.B41 (GND), J1.B44 (GND), J1.B47 (GND), J1.B50 (GND), J1.B53 (GND), J1.B57 (GND), J1.C3 (GND), J1.C9 (GND), J1.C12 (GND), J1.C13 (GND), J1.C16 (GND), J1.C17 (GND), J1.C20 (GND), J1.C21 (GND), J1.C24 (GND), J1.C25 (GND), J1.C28 (GND), J1.C29 (GND), J1.C32 (GND), J1.C33 (GND), J1.C36 (GND), J1.C37 (GND), J1.C40 (GND), J1.C43 (GND), J1.C46 (GND), J1.C49 (GND), J1.C52 (GND), J1.C62 (GND), J1.D4 (GND), J1.D7 (GND), J1.D11 (GND), J1.D14 (GND), J1.D15 (GND), J1.D18 (GND), J1.D19 (GND), J1.D22 (GND), J1.D23 (GND), J1.D26 (GND), J1.D27 (GND), J1.D30 (GND), J1.D31 (GND), J1.D34 (GND), J1.D35 (GND), J1.D38 (GND), J1.D39 (GND), J1.D41 (GND), J1.D44 (GND), J1.D47 (GND), J1.D50 (GND), J1.D53 (GND), J1.D57 (GND), J1.D63 (GND), J1.E3 (GND), J1.E9 (GND), J1.E12 (GND), J1.E13 (GND), J1.E16 (GND), J1.E17 (GND), J1.E20 (GND), J1.E21 (GND), J1.E24 (GND), J1.E25 (GND), J1.E28 (GND), J1.E29 (GND), J1.E32 (GND), J1.E33 (GND), J1.E36 (GND), J1.E37 (GND), J1.E40 (GND), J1.E43 (GND), J1.E46 (GND), J1.E49 (GND), J1.E52 (GND), J1.E57 (GND), J1.E62 (GND), J1.F4 (GND), J1.F7 (GND), J1.F11 (GND), J1.F14 (GND), J1.F15 (GND), J1.F18 (GND), J1.F19 (GND), J1.F22 (GND), J1.F23 (GND), J1.F26 (GND), J1.F27 (GND), J1.F30 (GND), J1.F31 (GND), J1.F34 (GND), J1.F35 (GND), J1.F38 (GND), J1.F39 (GND), J1.F41 (GND), J1.F44 (GND), J1.F47 (GND), J1.F50 (GND), J1.F57 (GND), J1.F62 (GND), J1.G3 (GND), J1.G9 (GND), J1.G12 (GND), J1.G13 (GND), J1.G16 (GND), J1.G17 (GND), J1.G20 (GND), J1.G21 (GND), J1.G24 (GND), J1.G25 (GND), J1.G28 (GND), J1.G29 (GND), J1.G32 (GND), J1.G33 (GND), J1.G36 (GND), J1.G37 (GND), J1.G40 (GND), J1.G43 (GND), J1.G46 (GND), J1.G49 (GND), J1.G52 (GND), J1.G57 (GND), J1.G62 (GND), J1.H4 (GND), J1.H7 (GND), J1.H11 (GND), J1.H14 (GND), J1.H15 (GND), J1.H18 (GND), J1.H19 (GND), J1.H22 (GND), J1.H23 (GND), J1.H26 (GND), J1.H27 (GND), J1.H30 (GND), J1.H31 (GND), J1.H34 (GND), J1.H35 (GND), J1.H38 (GND), J1.H39 (GND), J1.H41 (GND), J1.H44 (GND), J1.H47 (GND), J1.H50 (GND), J1.H56 (GND), J1.H63 (GND), J1.J3 (GND), J1.J8 (GND), J1.J12 (GND), J1.J13 (GND), J1.J16 (GND), J1.J17 (GND), J1.J20 (GND), J1.J21 (GND), J1.J24 (GND), J1.J25 (GND), J1.J28 (GND), J1.J29 (GND), J1.J32 (GND), J1.J33 (GND), J1.J36 (GND), J1.J37 (GND), J1.J40 (GND), J1.J43 (GND), J1.J46 (GND), J1.J49 (GND), J1.J56 (GND), J1.J62 (GND), J1.K4 (GND), J1.K8 (GND), J1.K11 (GND), J1.K14 (GND), J1.K15 (GND), J1.K18 (GND), J1.K19 (GND), J1.K22 (GND), J1.K23 (GND), J1.K26 (GND), J1.K27 (GND), J1.K30 (GND), J1.K31 (GND), J1.K34 (GND), J1.K35 (GND), J1.K38 (GND), J1.K39 (GND), J1.K41 (GND), J1.K42 (GND), J1.K45 (GND), J1.K48 (GND), J1.K55 (GND), J1.K63 (GND), J1.L3 (GND), J1.L7 (GND), J1.L12 (GND), J1.L13 (GND), J1.L16 (GND), J1.L17 (GND), J1.L20 (GND), J1.L21 (GND), J1.L24 (GND), J1.L25 (GND), J1.L28 (GND), J1.L29 (GND), J1.L32 (GND), J1.L33 (GND), J1.L36 (GND), J1.L37 (GND), J1.L40 (GND), J1.L43 (GND), J1.L46 (GND), J1.L63 (PRSNT1), Q7.2 (S), Q8.2 (S), Q10.2 (S), Q11.2 (S), Q18.2 (S), Q20.2 (S), Q22.2 (S), Q37.2 (S), Q38.2 (S), Q40.2 (S), R307.1, R355.1, S1.1, S1.2, S5.1, S5.2, S6.3, S6.4, SW2.S1 (SH), SW2.S2 (SH), SW2.S3 (SH), SW2.S4 (SH), U70.2 (GND), U72.3 (GND), U74.2 (GND)
MODULE_POWER_ON: C8.2, J1.L54 (MODULE_POWER_ON), R14.1, TP79.1, U74.6 (1Y)
unnamed: BT1.1 (+), R6.1
unnamed: C226.2, U72.5 (CT)
unnamed: C251.1, Q22.3 (D), R308.1
unnamed: C251.2, D54.2 (A), R288.1, R308.2, S5.3, S5.4, U70.1 (~PB_IN)
unnamed: D1.1 (C), J1.D37 (PMIC_BBATT), R6.2, TP78.1
unnamed: D52.1 (C), Q20.3 (D)
unnamed: D52.2 (A), R306.1
unnamed: J1.A6 (UFS0_REF_CLK), TP52.1
unnamed: J1.A61 (SYSTEM_OC_N), TP51.1
unnamed: J1.B10 (POWER_INT_N), TP35.1
unnamed: J1.B55 (GPIO30), TP59.1
unnamed: J1.C6 (UFS0_RST_N), TP53.1
unnamed: J1.C55 (GPIO39), TP33.1
unnamed: J1.F61 (VCOMP_ALERT_N), TP49.1
unnamed: J1.G5 (GPIO56), TP58.1
unnamed: J1.G59 (THERM_SHDN_REQ_N), TP8.1
unnamed: J1.H60 (GPIO31), TP34.1
unnamed: J1.K37 (FSI_GPIO03), TP56.1
unnamed: J1.L41 (VM_SLEEP_N), TP57.1
unnamed: J1.L42 (MV_LSW_MON), TP31.1
unnamed: J1.L47 (VM_INT_N), TP32.1
unnamed: J1.L56 (THERM_ALERT_N), TP50.1
unnamed: J1.L58 (PERIPHERAL_RESET_N), TP48.1
unnamed: J1.L59 (MODULE_POWER_GOOD), TP60.1
unnamed: Q8.3 (D), R102.1
unnamed: Q10.1 (G), Q11.1 (G), Q38.1 (G), Q40.3 (D), R363.1
unnamed: Q10.3 (D), R56.1
unnamed: Q11.3 (D), R59.1
unnamed: Q17.3 (D), R297.1
unnamed: Q18.3 (D), R298.1
unnamed: Q22.1 (G), U72.1 (~RESET)
unnamed: Q7.3 (D), Q8.1 (G), Q37.1 (G), R47.1
unnamed: Q37.3 (D), R50.1
unnamed: Q38.3 (D), R60.1
unnamed: R24.2, U74.4 (2Y)
unnamed: R224.1, R289.1, U70.6 (~CLR)
unnamed: R300.2, R301.2
unnamed: R301.1, U70.4 (OUT)
unnamed: R302.1, U70.5 (~INT)
unnamed: R307.2, SW2.3
unnamed: SW2.2, U72.4 (~MR)
SYS_VIN_HV: C26.2, C27.2, C84.2, C359.2, C365.2, C366.2, J1.B3 (SYS_VIN_HV), J1.B63 (SYS_VIN_HV), J1.C1 (SYS_VIN_HV), J1.C2 (SYS_VIN_HV), J1.C63 (SYS_VIN_HV), J1.C64 (SYS_VIN_HV), J1.C65 (SYS_VIN_HV), J1.D1 (SYS_VIN_HV), J1.D2 (SYS_VIN_HV), J1.D3 (SYS_VIN_HV), J1.D64 (SYS_VIN_HV), J1.D65 (SYS_VIN_HV), J1.E1 (SYS_VIN_HV), J1.E2 (SYS_VIN_HV), J1.E63 (SYS_VIN_HV), J1.E64 (SYS_VIN_HV), J1.E65 (SYS_VIN_HV), J1.F1 (SYS_VIN_HV), J1.F2 (SYS_VIN_HV), J1.F3 (SYS_VIN_HV), J1.F63 (SYS_VIN_HV), J1.F64 (SYS_VIN_HV), J1.F65 (SYS_VIN_HV), J1.G1 (SYS_VIN_HV), J1.G2 (SYS_VIN_HV), J1.G63 (SYS_VIN_HV), J1.G64 (SYS_VIN_HV), J1.G65 (SYS_VIN_HV), J1.H1 (SYS_VIN_HV), J1.H2 (SYS_VIN_HV), J1.H3 (SYS_VIN_HV), J1.H64 (SYS_VIN_HV), J1.H65 (SYS_VIN_HV), J1.J1 (SYS_VIN_HV), J1.J2 (SYS_VIN_HV), J1.J63 (SYS_VIN_HV), J1.J64 (SYS_VIN_HV), J1.J65 (SYS_VIN_HV), J1.K3 (SYS_VIN_HV), R102.2
VIN_PWR_ON: C404.2, Q7.1 (G), Q20.1 (G), R24.1, R296.1
~FORCE_RECOVERY: C239.2, D46.2 (A), J1.L10 (FORCE_RECOVERY_N), S6.1, S6.2, TP81.1
~FORCE_SHDN: R297.2, R298.2, R300.1, U74.3 (2A)
~MODULE_SHDN: J1.L52 (MODULE_SHDN_N), Q17.2 (S), TP82.1
~MOD_SLEEP: J1.J60 (MODULE_SLEEP_N), TP55.1
~SLEEP_REQ: J1.L11 (SLEEP_REQ_N), TP54.1
~SOM_POWER_BTN: J1.L61 (POWER_BTN_N), R302.2, R304.1, TP80.1
~SOM_PRSNT: J1.A3 (PRSNT0), Q18.1 (G), R287.1, TP84.1
~SYS_RESET: C39.2, D5.2 (A), J1.L60 (SYS_RESET_N), S1.3, S1.4, TP83.1
~VDDIN_PWR_BAD: J1.L55 (VDDIN_PWR_BAD_N), TP85.1, U74.1 (1A)

Notes on the sheet:
7V to 20V
BOOT LED
Simulate button click for autostart
Power-up and reset
Note: This should delay VIN_PWR_ON assertion by 5ms deasertion by 2ms after SHDN signal from SOM
Reset button
SoM Power
Discharge circut
3-2 manual 1-2 auto
