phuongnamzz/jetson-agx-thor-baseboard/jetson-agx-thor-baseboard_full3D/usb.kicad_sch

## KiCad design jetson-agx-thor-baseboard_full3D/usb.kicad_sch (2026-10-11)

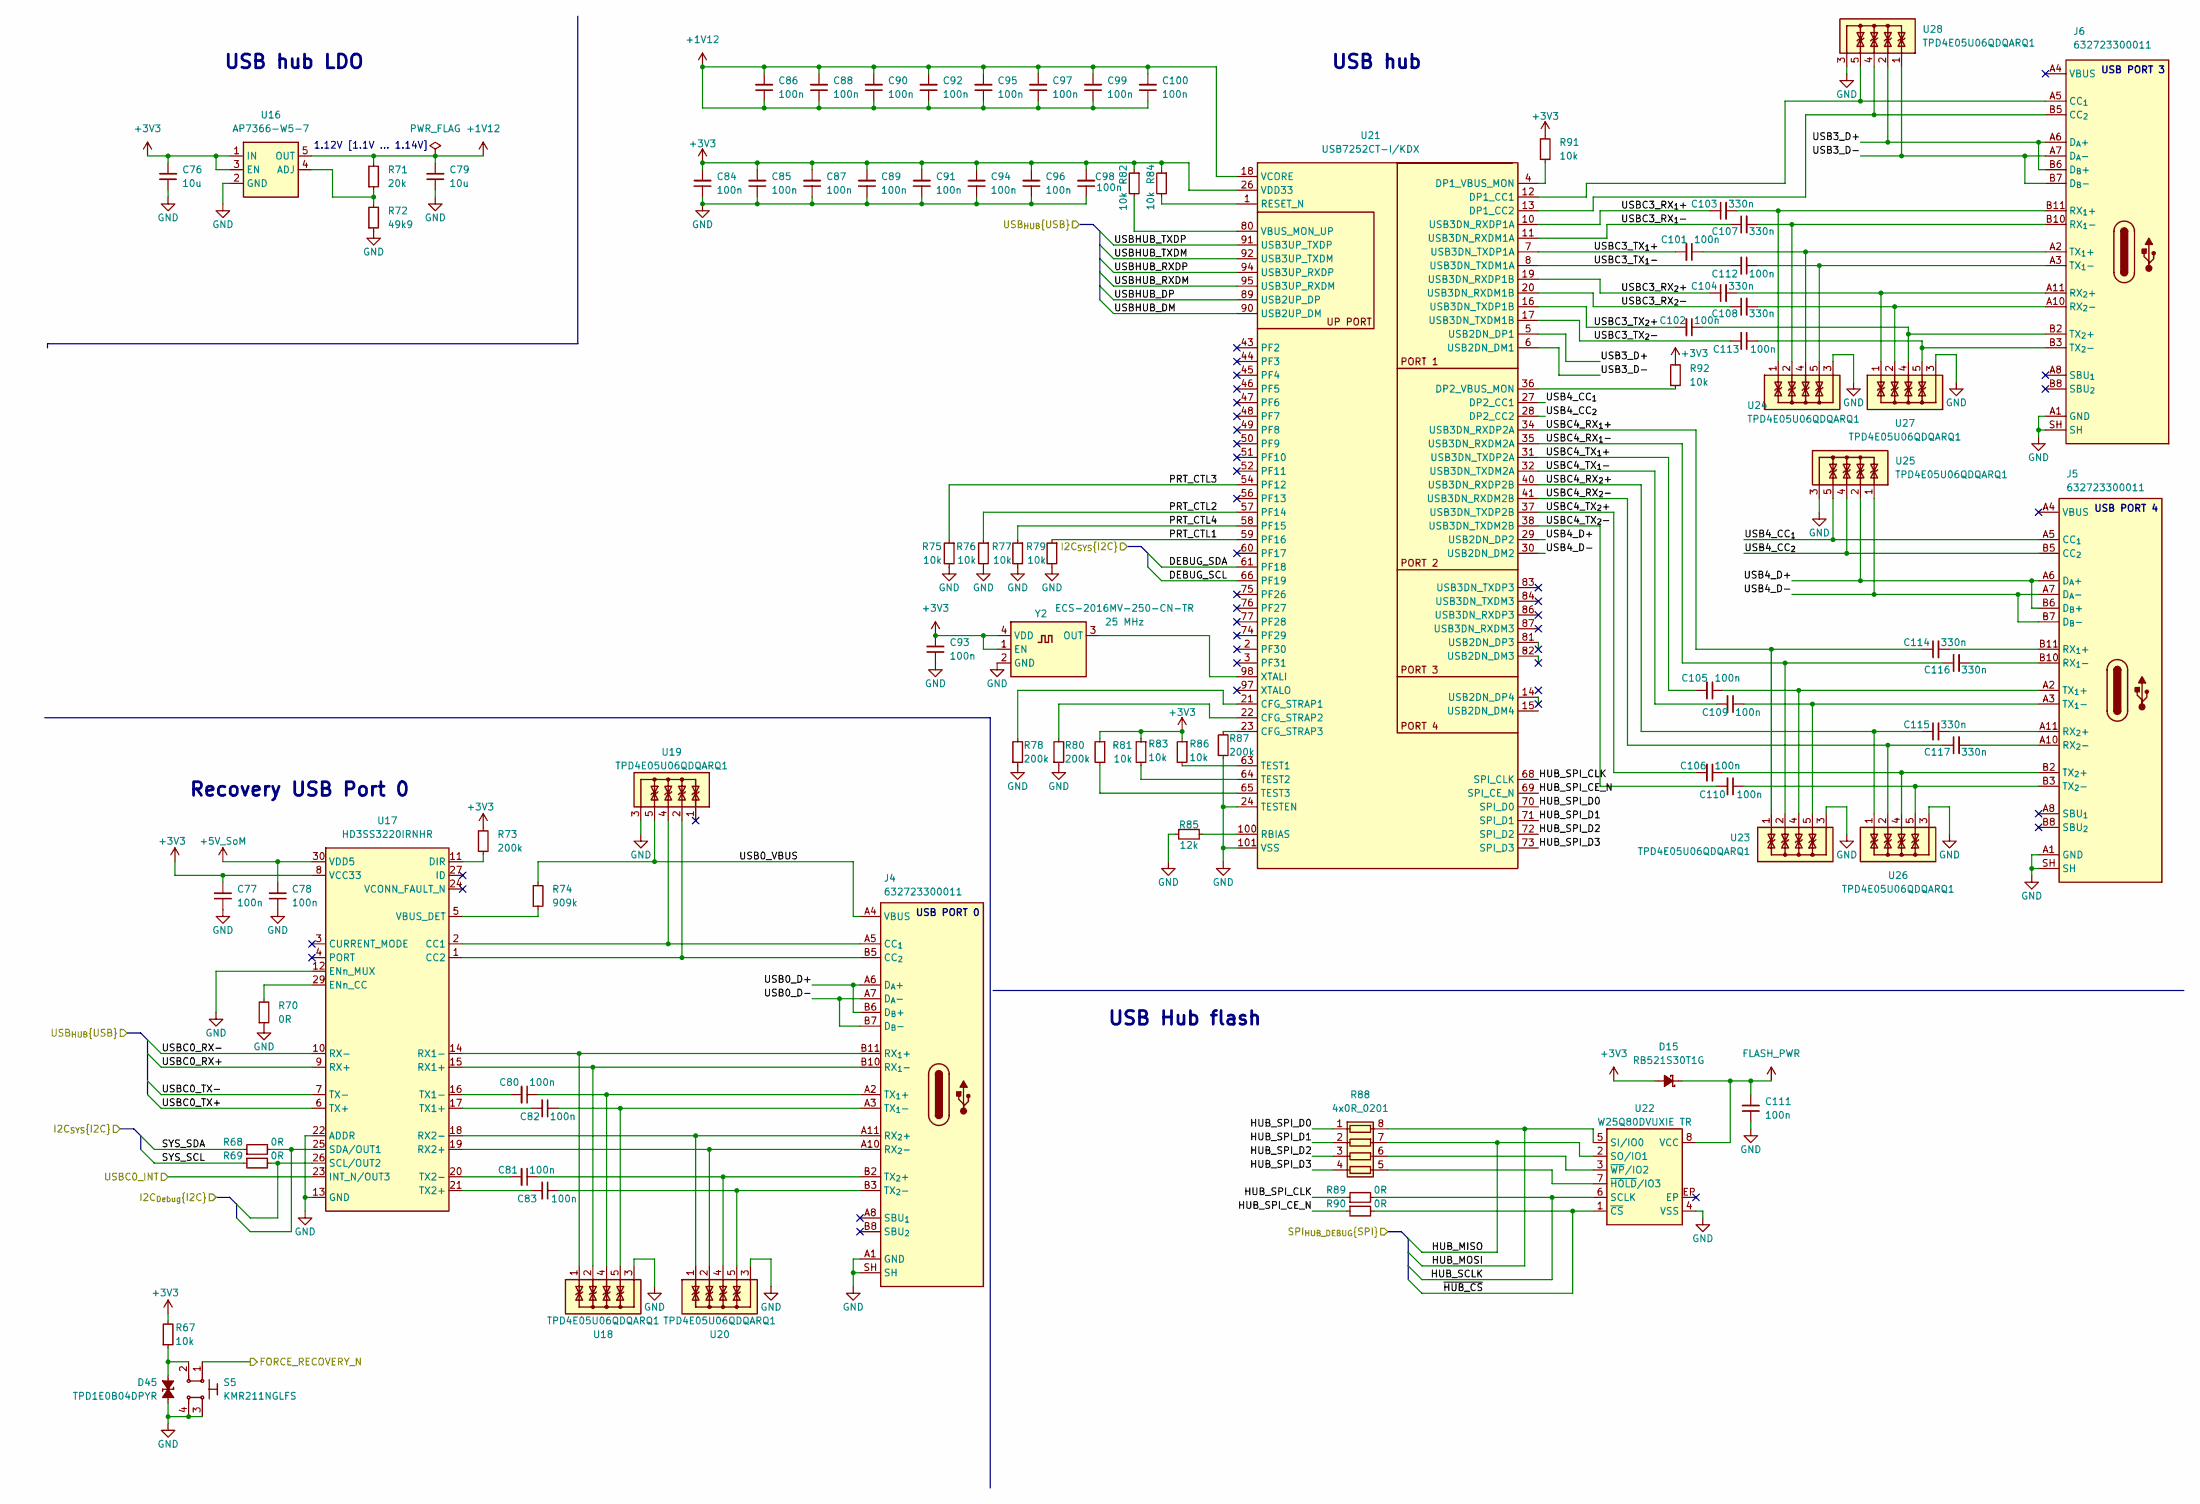
[picture p72: schematic usb.kicad_sch]

Parts:
C76, C79: C_10u_0402; C_0402_1005Metric; MPN CC0402MRX5R5BB106
C77, C78, C93: C_100n_50V_X8L_0402; C_0402_1005Metric; Voltage 50V; MPN GCM155L8EH104KE07D
C80, C81, C82, C83, C101, C102, C105, C106, C109, C110, C112, C113: C_100n_0201; C_0201; MPN CC0201KRX6S5BB104
C84, C85, C86, C87, C88, C89, C90, C91, C92, C94, C95, C96, C97, C98, C99, C100: C_100n_16V_X7R_0402; C_0402_1005Metric; Voltage 16V; MPN C0402C104J4RAC7411
C103, C104, C107, C108, C114, C115, C116, C117: C_330n_0402; C_0402_1005Metric; Voltage 63V; MPN GRM155R61J334KE01J
C111: C_100n_0402; C_0402_1005Metric; Voltage 50V; MPN GRM155R61H104KE14D
D15: RB521S30T1G; SOD-523; MPN RB521S30T1G
D45: TPD1E0B04_XDFN-2; XDFN-2_1x0.60mm; MPN TPD1E0B04DPYR
J4, J5, J6: USB-C_WE_632723300011; USB-C_Receptacle_WE_632723300011; MPN 632723300011
R67, R75, R76, R77, R79, R81, R82, R83, R84, R86, R91, R92: R_10k_0402; R_0402_1005Metric; Tolerance 1%; MPN CR0402-FX-1002GLF
R68, R69, R70, R89, R90: R_0R_0402; R_0402_1005Metric; MPN ERJ2GE0R00X
R71: R_20k_0402; R_0402_1005Metric; Tolerance 1%; MPN CR0402-FX-2002GLF
R72: R_49k9_0402; R_0402_1005Metric; Tolerance 1%; MPN CR0402-FX-4992GLF
R73, R78, R80, R87: R_200k_0402; R_0402_1005Metric; Tolerance 1%; MPN CR0402-FX-2003GLF
R74: R_909k_0402; R_0402_1005Metric; Tolerance 1%; MPN CR0402-FX-9093GLF
R85: R_12k_0402; R_0402_1005Metric; Tolerance 1%; MPN CR0402-FX-1202GLF
R88: R_4x0R_0201_array; R_Array_4x0201_Panasonic_EXB18V; MPN EXB-18VR000X
S5: SW_KMR211NGLFS_SMD; MPN KMR211NGLFS
U16: AP7366_SOT; SOT-23-5; MPN AP7366-W5-7
U17: HD3SS3220IRNHR; WQFN-30-1EP_4.6x2.6mm_P0.4mm; MPN HD3SS3220IRNHR
U18, U19, U20, U23, U24, U25, U26, U27, U28: TPD4E05U06QDQARQ1; USON-10_2.5x1mm_P0.5mm; MPN TPD4E05U06QDQARQ1
U21: USB7252C; VQFN-100-1EP_12x12x0.85mm_P0.4mm; MPN USB7252CT-I/KDX
U22: W25Q80DV_USON; USON-8_2x3mm_P0.5mm; MPN W25Q80DVUXIE TR
Y2: Oscillator_25MHz_ESC_2016MV; Oscillator_SMD_ECS_2016MV_2x1.6x0.85mm; MPN ECS-2016MV-250-CN-TR

Connections:
+1V12: C79.2, C86.1, C86.2, C88.1, C88.2, C90.1, C90.2, C92.1, C92.2, C95.1, C95.2, C97.1, C97.2, C99.1, C99.2, C100.1, C100.2, R71.2, U16.5 (OUT), U21.9 (VCORE), U21.18 (VCORE), U21.25 (VCORE), U21.33 (VCORE), U21.39 (VCORE), U21.55 (VCORE), U21.78 (VCORE), U21.85 (VCORE), U21.93 (VCORE)
+3V3: C76.2, C77.2, C84.2, C85.2, C87.2, C89.2, C91.2, C93.2, C94.2, C96.2, C98.2, D15.2 (A), R67.2, R73.2, R81.1, R82.1, R83.1, R84.1, R86.1, R91.2, R92.2, U16.1 (IN), U16.3 (EN), U17.8 (VCC33), U21.26 (VDD33), U21.42 (VDD33), U21.53 (VDD33), U21.62 (VDD33), U21.67 (VDD33), U21.79 (VDD33), U21.88 (VDD33), U21.99 (VDD33), Y2.1 (EN), Y2.4 (VDD)
+5V_SoM: C78.2, U17.30 (VDD5)
DEBUG_SCL: U21.66 (PF19)
DEBUG_SDA: U21.61 (PF18)
FLASH_PWR: C111.2, D15.1 (C), U22.8 (VCC)
FORCE_RECOVERY_N: S5.1
GND: C76.1, C77.1, C78.1, C79.1, C84.1, C85.1, C87.1, C89.1, C91.1, C93.1, C94.1, C96.1, C98.1, C111.1, D45.1 (C), J4.A1 (GND), J4.A12 (GND), J4.B1 (GND), J4.B12 (GND), J4.SH, J5.A1 (GND), J5.A12 (GND), J5.B1 (GND), J5.B12 (GND), J5.SH, J6.A1 (GND), J6.A12 (GND), J6.B1 (GND), J6.B12 (GND), J6.SH, R70.1, R72.1, R75.2, R76.2, R77.2, R78.1, R79.2, R80.1, R85.1, R87.1, S5.3, S5.4, U16.2 (GND), U17.12 (ENn_MUX), U17.13 (GND), U17.22 (ADDR), U17.28 (GND), U17.31 (GND), U18.3, U18.8, U19.3, U19.8, U20.3, U20.8, U21.24 (TESTEN), U21.101 (VSS), U22.4 (VSS), U23.3, U23.8, U24.3, U24.8, U25.3, U25.8, U26.3, U26.8, U27.3, U27.8, U28.3, U28.8, Y2.2 (GND)
HUB_MISO: R88.7 (R2.2), U22.2 (SO/IO1)
HUB_MOSI: R88.8 (R1.2), U22.5 (SI/IO0)
HUB_SCLK: R89.2, U22.6 (SCLK)
HUB_SPI_CE_N: R90.1, U21.69 (SPI_CE_N)
HUB_SPI_CLK: R89.1, U21.68 (SPI_CLK)
HUB_SPI_D0: R88.1 (R1.1), U21.70 (SPI_D0)
HUB_SPI_D1: R88.2 (R2.1), U21.71 (SPI_D1)
HUB_SPI_D2: R88.3 (R3.1), U21.72 (SPI_D2)
HUB_SPI_D3: R88.4 (R4.1), U21.73 (SPI_D3)
unnamed: C80.1, J4.A2 (TX_{1}+), U18.4, U18.7
unnamed: C80.2, U17.16 (TX1-)
unnamed: C81.1, J4.B2 (TX_{2}+), U20.4, U20.7
unnamed: C81.2, U17.20 (TX2-)
unnamed: C82.1, J4.A3 (TX_{1}-), U18.5, U18.6
unnamed: C82.2, U17.17 (TX1+)
unnamed: C83.1, J4.B3 (TX_{2}-), U20.5, U20.6
unnamed: C83.2, U17.21 (TX2+)
unnamed: C101.1, J6.A2 (TX_{1}+), U24.4, U24.7
unnamed: C102.1, J6.B2 (TX_{2}+), U27.4, U27.7
unnamed: C103.2, J6.B11 (RX_{1}+), U24.1, U24.10
unnamed: C104.2, J6.A11 (RX_{2}+), U27.1, U27.10
unnamed: C105.1, J5.A2 (TX_{1}+), U23.4, U23.7
unnamed: C106.1, J5.B2 (TX_{2}+), U26.4, U26.7
unnamed: C107.2, J6.B10 (RX_{1}-), U24.2, U24.9
unnamed: C108.2, J6.A10 (RX_{2}-), U27.2, U27.9
unnamed: C109.1, J5.A3 (TX_{1}-), U23.5, U23.6
unnamed: C110.1, J5.B3 (TX_{2}-), U26.5, U26.6
unnamed: C112.1, J6.A3 (TX_{1}-), U24.5, U24.6
unnamed: C113.1, J6.B3 (TX_{2}-), U27.5, U27.6
unnamed: C114.2, J5.B11 (RX_{1}+)
unnamed: C115.2, J5.A11 (RX_{2}+)
unnamed: C116.2, J5.B10 (RX_{1}-)
unnamed: C117.2, J5.A10 (RX_{2}-)
unnamed: D45.2 (A), R67.1, S5.2
unnamed: J4.A5 (CC_{1}), U17.2 (CC1), U19.4, U19.7
unnamed: J4.A10 (RX_{2}-), U17.19 (RX2+), U20.2, U20.9
unnamed: J4.A11 (RX_{2}+), U17.18 (RX2-), U20.1, U20.10
unnamed: J4.B5 (CC_{2}), U17.1 (CC2), U19.2, U19.9
unnamed: J4.B10 (RX_{1}-), U17.15 (RX1+), U18.2, U18.9
unnamed: J4.B11 (RX_{1}+), U17.14 (RX1-), U18.1, U18.10
unnamed: J5.A4 (VBUS), J5.A9 (VBUS), J5.B4 (VBUS), J5.B9 (VBUS)
unnamed: J6.A4 (VBUS), J6.A9 (VBUS), J6.B4 (VBUS), J6.B9 (VBUS)
unnamed: J6.A5 (CC_{1}), U21.12 (DP1_CC1), U28.5, U28.6
unnamed: J6.B5 (CC_{2}), U21.13 (DP1_CC2), U28.4, U28.7
unnamed: R68.2, U17.25 (SDA/OUT1)
unnamed: R69.2, U17.26 (SCL/OUT2)
unnamed: R70.2, U17.29 (ENn_CC)
unnamed: R71.1, R72.2, U16.4 (ADJ)
unnamed: R73.1, U17.11 (DIR)
unnamed: R74.1, U17.5 (VBUS_DET)
unnamed: R78.2, U21.21 (CFG_STRAP1)
unnamed: R80.2, U21.22 (CFG_STRAP2)
unnamed: R81.2, U21.65 (TEST3)
unnamed: R82.2, U21.80 (VBUS_MON_UP)
unnamed: R83.2, U21.64 (TEST2)
unnamed: R84.2, U21.1 (RESET_N)
unnamed: R85.2, U21.100 (RBIAS)
unnamed: R86.2, U21.63 (TEST1)
unnamed: R87.2, U21.23 (CFG_STRAP3)
unnamed: R88.5 (R4.2), U22.7 (~HOLD/IO3)
unnamed: R88.6 (R3.2), U22.3 (~WP/IO2)
unnamed: R91.1, U21.4 (DP1_VBUS_MON)
unnamed: R92.1, U21.36 (DP2_VBUS_MON)
unnamed: U19.1, U19.10
unnamed: U21.98 (XTALI), Y2.3 (OUT)
PRT_CTL1: R79.1, U21.59 (PF16)
PRT_CTL2: R76.1, U21.57 (PF14)
PRT_CTL3: R75.1, U21.54 (PF12)
PRT_CTL4: R77.1, U21.58 (PF15)
SYS_SCL: R69.1
SYS_SDA: R68.1
USB0_D+: J4.A6 (D_{A}+), J4.B6 (D_{B}+)
USB0_D-: J4.A7 (D_{A}-), J4.B7 (D_{B}-)
USB0_VBUS: J4.A4 (VBUS), J4.A9 (VBUS), J4.B4 (VBUS), J4.B9 (VBUS), R74.2, U19.5, U19.6
USB3_D+: J6.A6 (D_{A}+), J6.B6 (D_{B}+), U21.5 (USB2DN_DP1), U28.2, U28.9
USB3_D-: J6.A7 (D_{A}-), J6.B7 (D_{B}-), U21.6 (USB2DN_DM1), U28.1, U28.10
USB4_CC_{1}: J5.A5 (CC_{1}), U21.27 (DP2_CC1), U25.5, U25.6
USB4_CC_{2}: J5.B5 (CC_{2}), U21.28 (DP2_CC2), U25.4, U25.7
USB4_D+: J5.A6 (D_{A}+), J5.B6 (D_{B}+), U21.29 (USB2DN_DP2), U25.2, U25.9
USB4_D-: J5.A7 (D_{A}-), J5.B7 (D_{B}-), U21.30 (USB2DN_DM2), U25.1, U25.10
USBC0_INT: U17.23 (INT_N/OUT3)
USBC0_RX+: U17.9 (RX+)
USBC0_RX-: U17.10 (RX-)
USBC0_TX+: U17.6 (TX+)
USBC0_TX-: U17.7 (TX-)
USBC3_RX_{1}+: C103.1, U21.10 (USB3DN_RXDP1A)
USBC3_RX_{1}-: C107.1, U21.11 (USB3DN_RXDM1A)
USBC3_RX_{2}+: C104.1, U21.19 (USB3DN_RXDP1B)
USBC3_RX_{2}-: C108.1, U21.20 (USB3DN_RXDM1B)
USBC3_TX_{1}+: C101.2, U21.7 (USB3DN_TXDP1A)
USBC3_TX_{1}-: C112.2, U21.8 (USB3DN_TXDM1A)
USBC3_TX_{2}+: C102.2, U21.16 (USB3DN_TXDP1B)
USBC3_TX_{2}-: C113.2, U21.17 (USB3DN_TXDM1B)
USBC4_RX_{1}+: C114.1, U21.34 (USB3DN_RXDP2A), U23.1, U23.10
USBC4_RX_{1}-: C116.1, U21.35 (USB3DN_RXDM2A), U23.2, U23.9
USBC4_RX_{2}+: C115.1, U21.40 (USB3DN_RXDP2B), U26.1, U26.10
USBC4_RX_{2}-: C117.1, U21.41 (USB3DN_RXDM2B), U26.2, U26.9
USBC4_TX_{1}+: C105.2, U21.31 (USB3DN_TXDP2A)
USBC4_TX_{1}-: C109.2, U21.32 (USB3DN_TXDM2A)
USBC4_TX_{2}+: C106.2, U21.37 (USB3DN_TXDP2B)
USBC4_TX_{2}-: C110.2, U21.38 (USB3DN_TXDM2B)
USBHUB_DM: U21.90 (USB2UP_DM)
USBHUB_DP: U21.89 (USB2UP_DP)
USBHUB_RXDM: U21.95 (USB3UP_RXDM)
USBHUB_RXDP: U21.94 (USB3UP_RXDP)
USBHUB_TXDM: U21.92 (USB3UP_TXDM)
USBHUB_TXDP: U21.91 (USB3UP_TXDP)
~HUB_CS: R90.2, U22.1 (~CS)

Notes on the sheet:
USB PORT 4
USB hub
Recovery USB Port 0
USB PORT 0
1.12V [1.1V ... 1.14V]
USB PORT 3
USB hub LDO
USB Hub flash
