phuongnamzz/jetson-agx-thor-baseboard/jetson-agx-thor-baseboard_full3D/usb_hub.kicad_sch

## KiCad design jetson-agx-thor-baseboard_full3D/usb_hub.kicad_sch (2026-10-11)

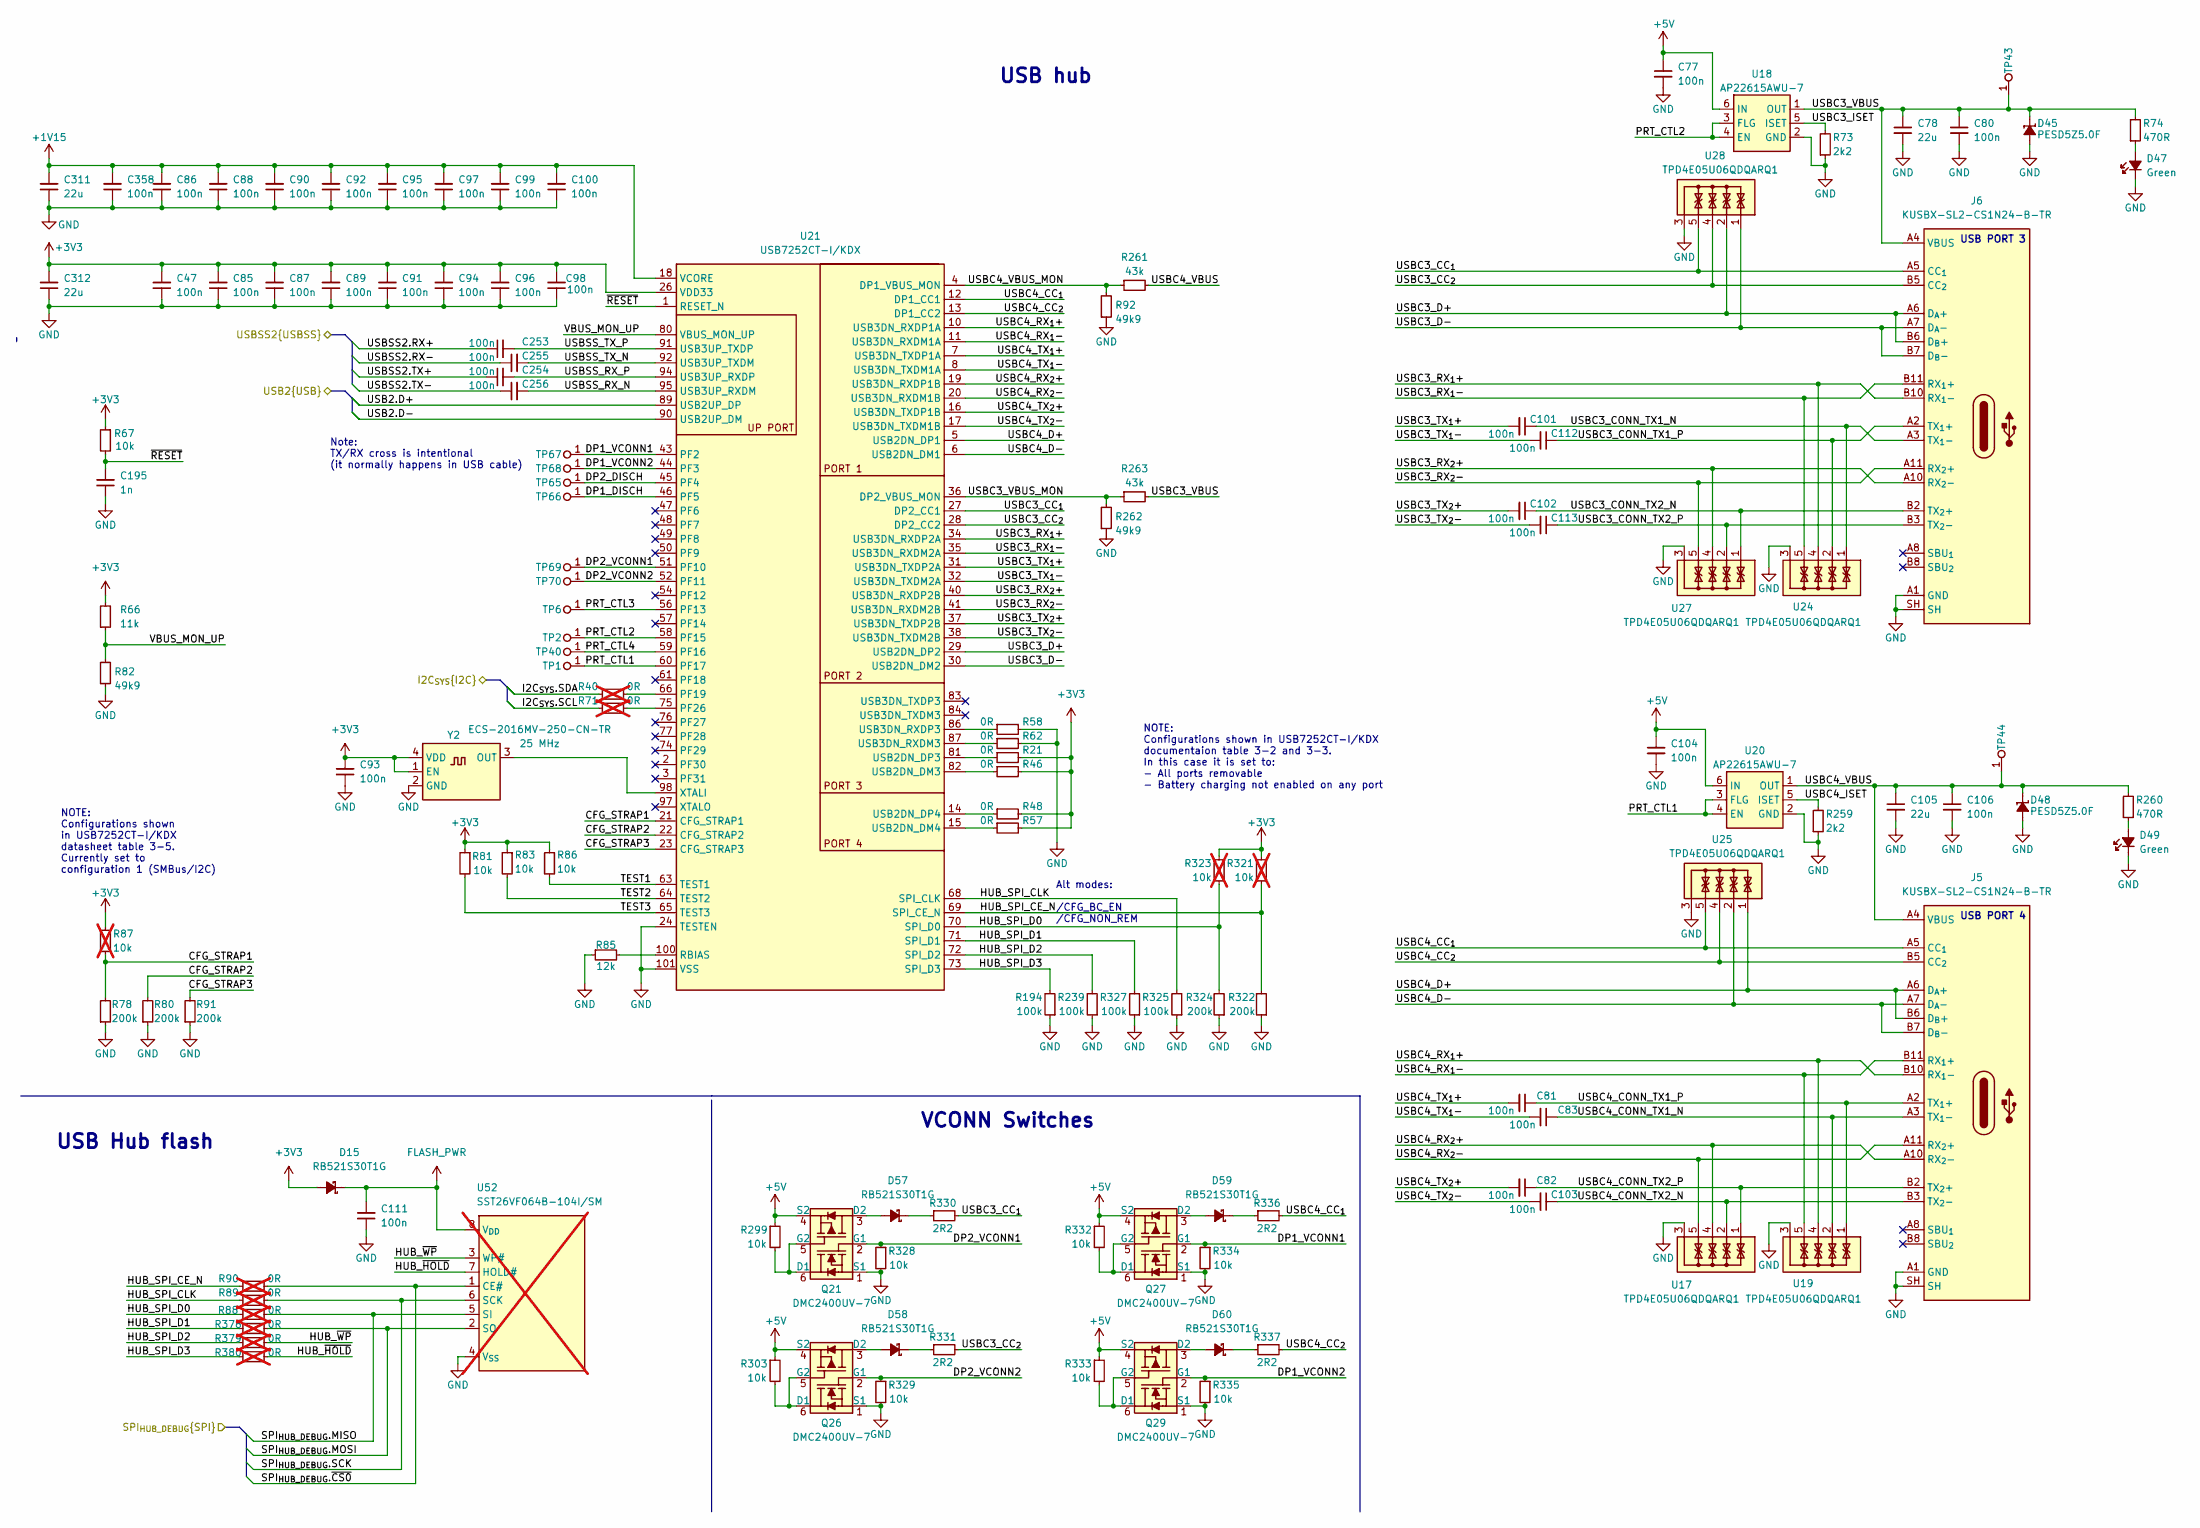
[picture p75: schematic usb_hub.kicad_sch]

Parts:
C47, C77, C80, C81, C82, C83, C85, C86, C87, C88, C89, C90, C91, C92, C93, C94, C95, C96, C97, C98, C99, C100, C101, C102, C103, C104, C106, C111, C112, C113, C253, C254, C255, C256, C358: C_100n_0402; C_0402_1005Metric; Voltage 50V; MPN GRM155R61H104KE14D
C78, C105: C_22u_25V_0805; C_0805_2012Metric; Voltage 25V; MPN CL21A226MAYNNNE
C195: C_1n_0402; C_0402_1005Metric; Voltage 50V; MPN GRM1555C1H102JA01D
C311, C312: C_22u_16V_0603; C_0603_1608Metric_EIA; Voltage 16V; MPN CL10A226MO7JZNC
D15, D57, D58, D59, D60: RB521S30T1G; SOD-523; MPN RB521S30T1G
D45, D48: PESD5Z5.0F; SOD-523; MPN PESD5Z5.0F
D47, D49: LED_G_0603_LTST-C190GKT; LED_0603_1608Metric_G; MPN LTST-C190GKT
J5, J6: USB-C_Kycon_KUSBX-SL2-CS1N24-B-TR; USB-C_Receptacle_Kycon_KUSBX-SL2-CS1N24-B-TR; MPN KUSBX-SL2-CS1N24-B-TR
Q21, Q26, Q27, Q29: DMC2400UV-7; SOT-563; MPN DMC2400UV-7
R21, R46, R48, R57, R58, R62: R_0R_0402; R_0402_1005Metric; MPN ERJ2GE0R00X
R40, R71, R88, R89, R90, R378, R379, R380: R_0R_0402; R_0402_1005Metric; MPN ERJ2GE0R00X; not fitted
R66: R_11k_0402; R_0402_1005Metric; Tolerance 1%; MPN CR0402-FX-1102GLF
R67, R81, R83, R86, R299, R303, R328, R329, R332, R333, R334, R335: R_10k_0402; R_0402_1005Metric; Tolerance 1%; MPN CR0402-FX-1002GLF
R73, R259: R_2k2_0402; R_0402_1005Metric; Tolerance 1%; MPN CR0402-FX-2201GLF
R74, R260: R_470R_0402; R_0402_1005Metric; Tolerance 1%; MPN CR0402-FX-4700GLF
R78, R80, R91, R322, R324: R_200k_0402; R_0402_1005Metric; Tolerance 1%; MPN CR0402-FX-2003GLF
R82, R92, R262: R_49k9_0402; R_0402_1005Metric; Tolerance 1%; MPN CR0402-FX-4992GLF
R85: R_12k_0402; R_0402_1005Metric; Tolerance 1%; MPN CR0402-FX-1202GLF
R87, R321, R323: R_10k_0402; R_0402_1005Metric; Tolerance 1%; MPN CR0402-FX-1002GLF; not fitted
R194, R239, R325, R327: R_100k_0402; R_0402_1005Metric; Tolerance 1%; MPN CR0402-FX-1003GLF
R261, R263: R_43k_0402; R_0402_1005Metric; Tolerance 1%; MPN CR0402-FX-4302GLF
R330, R331, R336, R337: R_2R2_0402; R_0402_1005Metric; Tolerance 1%; MPN CR0402-FX-2R20GLF
TP1, TP2, TP6, TP40, TP43, TP44, TP65, TP66, TP67, TP68, TP69, TP70: TP_0.75mm_SMD; TP_SMD_0.75mm
U17, U19, U24, U25, U27, U28: TPD4E05U06QDQARQ1; USON-10_2.5x1mm_P0.5mm; MPN TPD4E05U06QDQARQ1
U18, U20: AP22615A_TSOT26; TSOT23-6; MPN AP22615AWU-7
U21: USB7252C; VQFN-100-1EP_12x12x0.85mm_P0.4mm; MPN USB7252CT-I/KDX
U52: SST26VF064B; SOIJ-8_5.28x5.28x2.0mm_P1.27mm; MPN SST26VF064B-104I/SM; not fitted
Y2: Oscillator_25MHz_ESC_2016MV; Oscillator_SMD_ECS_2016MV_2x1.6x0.85mm; MPN ECS-2016MV-250-CN-TR

Connections:
+1V15: C86.2, C88.2, C90.2, C92.2, C95.2, C97.2, C99.2, C100.2, C311.2, C358.2, U21.9 (VCORE), U21.18 (VCORE), U21.25 (VCORE), U21.33 (VCORE), U21.39 (VCORE), U21.55 (VCORE), U21.78 (VCORE), U21.85 (VCORE), U21.93 (VCORE)
+3V3: C47.2, C85.2, C87.2, C89.2, C91.2, C93.2, C94.2, C96.2, C98.2, C312.2, D15.2 (A), R21.2, R46.2, R48.2, R57.2, R66.2, R67.1, R81.1, R83.1, R86.1, R87.2, R321.2, R323.2, U21.26 (VDD33), U21.42 (VDD33), U21.53 (VDD33), U21.62 (VDD33), U21.67 (VDD33), U21.79 (VDD33), U21.88 (VDD33), U21.99 (VDD33), Y2.1 (EN), Y2.4 (VDD)
+5V: C77.1, C104.1, Q21.4 (S2), Q26.4 (S2), Q27.4 (S2), Q29.4 (S2), R299.1, R303.1, R332.1, R333.1, U18.6 (IN), U20.6 (IN)
CFG_STRAP1: R78.2, R87.1, U21.21 (CFG_STRAP1)
CFG_STRAP2: R80.2, U21.22 (CFG_STRAP2)
CFG_STRAP3: R91.2, U21.23 (CFG_STRAP3)
DP1_DISCH: TP66.1, U21.46 (PF5)
DP1_VCONN1: Q27.2 (G1), R334.1, TP67.1, U21.43 (PF2)
DP1_VCONN2: Q29.2 (G1), R335.1, TP68.1, U21.44 (PF3)
DP2_DISCH: TP65.1, U21.45 (PF4)
DP2_VCONN1: Q21.2 (G1), R328.1, TP69.1, U21.51 (PF10)
DP2_VCONN2: Q26.2 (G1), R329.1, TP70.1, U21.52 (PF11)
FLASH_PWR: C111.2, D15.1 (C), U52.8 (V_{DD})
GND: C47.1, C77.2, C78.2, C80.2, C85.1, C86.1, C87.1, C88.1, C89.1, C90.1, C91.1, C92.1, C93.1, C94.1, C95.1, C96.1, C97.1, C98.1, C99.1, C100.1, C104.2, C105.2, C106.2, C111.1, C195.1, C311.1, C312.1, C358.1, D45.2 (A), D47.1 (C), D48.2 (A), D49.1 (C), J5.A1 (GND), J5.A12 (GND), J5.B1 (GND), J5.B12 (GND), J5.SH, J6.A1 (GND), J6.A12 (GND), J6.B1 (GND), J6.B12 (GND), J6.SH, Q21.1 (S1), Q26.1 (S1), Q27.1 (S1), Q29.1 (S1), R58.2, R62.2, R73.1, R78.1, R80.1, R82.1, R85.1, R91.1, R92.1, R194.1, R239.1, R259.1, R262.1, R322.1, R324.1, R325.1, R327.1, R328.2, R329.2, R334.2, R335.2, U17.3, U17.8, U18.2 (GND), U19.3, U19.8, U20.2 (GND), U21.24 (TESTEN), U21.101 (VSS), U24.3, U24.8, U25.3, U25.8, U27.3, U27.8, U28.3, U28.8, U52.4 (V_{SS}), Y2.2 (GND)
HUB_SPI_CE_N: R90.1, R321.1, R322.2, U21.69 (SPI_CE_N)
HUB_SPI_CLK: R89.1, R325.2, U21.68 (SPI_CLK)
HUB_SPI_D0: R88.1, R323.1, R324.2, U21.70 (SPI_D0)
HUB_SPI_D1: R327.2, R378.1, U21.71 (SPI_D1)
HUB_SPI_D2: R239.2, R379.1, U21.72 (SPI_D2)
HUB_SPI_D3: R194.2, R380.1, U21.73 (SPI_D3)
HUB_~HOLD: R380.2, U52.7 (HOLD#)
HUB_~WP: R379.2, U52.3 (WP#)
I2C_{SYS}.SCL: R71.1
I2C_{SYS}.SDA: R40.1
unnamed: D47.2 (A), R74.1
unnamed: D49.2 (A), R260.1
unnamed: D57.1 (C), R330.1
unnamed: D57.2 (A), Q21.3 (D2)
unnamed: D58.1 (C), R331.1
unnamed: D58.2 (A), Q26.3 (D2)
unnamed: D59.1 (C), R336.1
unnamed: D59.2 (A), Q27.3 (D2)
unnamed: D60.1 (C), R337.1
unnamed: D60.2 (A), Q29.3 (D2)
unnamed: Q21.5 (G2), Q21.6 (D1), R299.2
unnamed: Q26.5 (G2), Q26.6 (D1), R303.2
unnamed: Q27.5 (G2), Q27.6 (D1), R332.2
unnamed: Q29.5 (G2), Q29.6 (D1), R333.2
unnamed: R21.1, U21.81 (USB2DN_DP3)
unnamed: R40.2, U21.66 (PF19)
unnamed: R46.1, U21.82 (USB2DN_DM3)
unnamed: R48.1, U21.14 (USB2DN_DP4)
unnamed: R57.1, U21.15 (USB2DN_DM4)
unnamed: R58.1, U21.86 (USB3DN_RXDP3)
unnamed: R62.1, U21.87 (USB3DN_RXDM3)
unnamed: R71.2, U21.75 (PF26)
unnamed: R85.2, U21.100 (RBIAS)
unnamed: U21.98 (XTALI), Y2.3 (OUT)
PRT_CTL1: TP1.1, U20.3 (FLG), U20.4 (EN), U21.60 (PF17)
PRT_CTL2: TP2.1, U18.3 (FLG), U18.4 (EN), U21.58 (PF15)
PRT_CTL3: TP6.1, U21.56 (PF13)
PRT_CTL4: TP40.1, U21.59 (PF16)
SPI_{HUB_DEBUG}.MISO: R88.2, U52.5 (SI)
SPI_{HUB_DEBUG}.MOSI: R378.2, U52.2 (SO)
SPI_{HUB_DEBUG}.SCK: R89.2, U52.6 (SCK)
SPI_{HUB_DEBUG}.~CS0: R90.2, U52.1 (CE#)
TEST1: R86.2, U21.63 (TEST1)
TEST2: R83.2, U21.64 (TEST2)
TEST3: R81.2, U21.65 (TEST3)
USB2.D+: U21.89 (USB2UP_DP)
USB2.D-: U21.90 (USB2UP_DM)
USBC3_CC_{1}: J6.A5 (CC_{1}), R330.2, U21.27 (DP2_CC1), U28.5, U28.6
USBC3_CC_{2}: J6.B5 (CC_{2}), R331.2, U21.28 (DP2_CC2), U28.4, U28.7
USBC3_CONN_TX1_N: C101.1, J6.A3 (TX_{1}-), U24.1, U24.10
USBC3_CONN_TX1_P: C112.1, J6.A2 (TX_{1}+), U24.2, U24.9
USBC3_CONN_TX2_N: C102.1, J6.B2 (TX_{2}+), U27.1, U27.10
USBC3_CONN_TX2_P: C113.1, J6.B3 (TX_{2}-), U27.2, U27.9
USBC3_D+: J6.A6 (D_{A}+), J6.B6 (D_{B}+), U21.29 (USB2DN_DP2), U28.2, U28.9
USBC3_D-: J6.A7 (D_{A}-), J6.B7 (D_{B}-), U21.30 (USB2DN_DM2), U28.1, U28.10
USBC3_ISET: R73.2, U18.5 (ISET)
USBC3_RX_{1}+: J6.B10 (RX_{1}-), U21.34 (USB3DN_RXDP2A), U24.4, U24.7
USBC3_RX_{1}-: J6.B11 (RX_{1}+), U21.35 (USB3DN_RXDM2A), U24.5, U24.6
USBC3_RX_{2}+: J6.A10 (RX_{2}-), U21.40 (USB3DN_RXDP2B), U27.4, U27.7
USBC3_RX_{2}-: J6.A11 (RX_{2}+), U21.41 (USB3DN_RXDM2B), U27.5, U27.6
USBC3_TX_{1}+: C101.2, U21.31 (USB3DN_TXDP2A)
USBC3_TX_{1}-: C112.2, U21.32 (USB3DN_TXDM2A)
USBC3_TX_{2}+: C102.2, U21.37 (USB3DN_TXDP2B)
USBC3_TX_{2}-: C113.2, U21.38 (USB3DN_TXDM2B)
USBC3_VBUS: C78.1, C80.1, D45.1 (C), J6.A4 (VBUS), J6.A9 (VBUS), J6.B4 (VBUS), J6.B9 (VBUS), R74.2, R263.2, TP43.1, U18.1 (OUT)
USBC3_VBUS_MON: R262.2, R263.1, U21.36 (DP2_VBUS_MON)
USBC4_CC_{1}: J5.A5 (CC_{1}), R336.2, U21.12 (DP1_CC1), U25.5, U25.6
USBC4_CC_{2}: J5.B5 (CC_{2}), R337.2, U21.13 (DP1_CC2), U25.4, U25.7
USBC4_CONN_TX1_N: C83.1, J5.A3 (TX_{1}-), U19.2, U19.9
USBC4_CONN_TX1_P: C81.1, J5.A2 (TX_{1}+), U19.1, U19.10
USBC4_CONN_TX2_N: C103.1, J5.B3 (TX_{2}-), U17.2, U17.9
USBC4_CONN_TX2_P: C82.1, J5.B2 (TX_{2}+), U17.1, U17.10
USBC4_D+: J5.A6 (D_{A}+), J5.B6 (D_{B}+), U21.5 (USB2DN_DP1), U25.1, U25.10
USBC4_D-: J5.A7 (D_{A}-), J5.B7 (D_{B}-), U21.6 (USB2DN_DM1), U25.2, U25.9
USBC4_ISET: R259.2, U20.5 (ISET)
USBC4_RX_{1}+: J5.B10 (RX_{1}-), U19.4, U19.7, U21.10 (USB3DN_RXDP1A)
USBC4_RX_{1}-: J5.B11 (RX_{1}+), U19.5, U19.6, U21.11 (USB3DN_RXDM1A)
USBC4_RX_{2}+: J5.A10 (RX_{2}-), U17.4, U17.7, U21.19 (USB3DN_RXDP1B)
USBC4_RX_{2}-: J5.A11 (RX_{2}+), U17.5, U17.6, U21.20 (USB3DN_RXDM1B)
USBC4_TX_{1}+: C81.2, U21.7 (USB3DN_TXDP1A)
USBC4_TX_{1}-: C83.2, U21.8 (USB3DN_TXDM1A)
USBC4_TX_{2}+: C82.2, U21.16 (USB3DN_TXDP1B)
USBC4_TX_{2}-: C103.2, U21.17 (USB3DN_TXDM1B)
USBC4_VBUS: C105.1, C106.1, D48.1 (C), J5.A4 (VBUS), J5.A9 (VBUS), J5.B4 (VBUS), J5.B9 (VBUS), R260.2, R261.2, TP44.1, U20.1 (OUT)
USBC4_VBUS_MON: R92.2, R261.1, U21.4 (DP1_VBUS_MON)
USBSS2.RX+: C253.1
USBSS2.RX-: C255.1
USBSS2.TX+: C254.1
USBSS2.TX-: C256.1
USBSS_RX_N: C256.2, U21.95 (USB3UP_RXDM)
USBSS_RX_P: C254.2, U21.94 (USB3UP_RXDP)
USBSS_TX_N: C255.2, U21.92 (USB3UP_TXDM)
USBSS_TX_P: C253.2, U21.91 (USB3UP_TXDP)
VBUS_MON_UP: R66.1, R82.2, U21.80 (VBUS_MON_UP)
~RESET: C195.2, R67.2, U21.1 (RESET_N)

Notes on the sheet:
NOTE: Configurations shown in USB7252CT-I/KDX datasheet table 3-5. Currently set to configuration 1 (SMBus/I2C)
USB PORT 4
USB hub
Note: TX/RX cross is intentional (it normally happens in USB cable)
VCONN Switches
USB PORT 3
USB Hub flash
Alt modes: /CFG_BC_EN /CFG_NON_REM
NOTE: Configurations shown in USB7252CT-I/KDX documentaion table 3-2 and 3-3. In this case it is set to: - All ports removable - Battery charging not enabled on any port
