phuongnamzz/jetson-agx-thor-baseboard/(commit log)

2026-10-11 add: version with full 3D components
    [csi.kicad_sch, dcdc.kicad_sch, expansion_connector.kicad_sch, jetson-agx-thor-baseboard.kicad_sch, level_shifter_x8.kicad_sch, m2.kicad_sch, peripherals.kicad_sch, power.kicad_sch]
2026-10-12 remove: .gitignore to push step files
    [0050362462.stp, 74438356018.stp, Bus_M.2_Socket_Key_E_TE_2199230-6.step, Bus_M.2_Socket_Key_M_TE_1-2199230-6.step, CONN-SMD_MX1.25-LS-4P.step, CONN-SMD_SR1.00-WS-4P.step, C_0402_1005Metric.step, C_0603_1608Metric.step]
