phuongnamzz/jetson-agx-thor-baseboard/(notices)

Notices in the files:
jetson-agx-thor-baseboard_full3D/3D_Model/LED_0603_1608Metric.step:
Copyright (C) 2018, kicad StepUp
This work is licensed under the [Creative Commons CC-BY-SA 4.0 License](https://creativecommons.org/licenses/by-sa/4.0/legalcode),
with the following exception:
To the extent that the creation of electronic designs that use 'Licensed Material' can be considered to be 'Adapted Material',
You are free to use the library data in your own projects without the obligation to share your project files under this or any other license agreement.
jetson-agx-thor-baseboard_full3D/3D_Model/SOT-666.step:
Copyright (C) 2017, kicad StepUp
This program is free software: you can redistribute it and/or modify
it under the terms of the GNU General Public License as published by
the Free Software Foundation, either version 3 of the License, or
any later version.
itself might be covered by the GNU General Public License.
jetson-agx-thor-baseboard_full3D/3D_Model/D_SOD-123.step:
Copyright (C) 2025, KiCAD
This work is licensed under the
[Creative Commons CC-BY-SA 4.0 License](https://creativecommons.org/licenses/by-sa/4.0/legalcode),
project files under this or any other license agreement. However, if you wish to distribute
jetson-agx-thor-baseboard_full3D/3D_Model/UMPT-06-06.5-G-V-S-W-TR.stp:
author */ ('License CC BY-ND 4.0'),
parts and their libraries:
License: Apache-2.0
